tianchuangya/SmartDesktopCube-IoT/README.md

# SmartDesktopCube-IoT
SmartDesktopCube-IoT基于 ESP32 的多功能智能桌面魔方 IoT 项目
