tianchuangya/SmartDesktopCube-IoT/关于硬件.docx

BH1750：SDA=2，SCL=1 ,

ENS160 + AHT21：SDA 6 SCL 5

TFT ILI9341：led 3.3v sck 13 sdi 12 dc 14 reset 4 cs 16 T_CLK 17 T_DIN 18 T_DO 20 T-IQR 21 T_CS 47

LD2410C：tx 15 rx 7

LD2410C：16mm * 22mm

多路dc电源模块：pcb板59.5mm*26.5mm，dc接口5.5*2.1mm

ENS160 + AHT21：19.6mm*24.3mm（手工测量）

BH1750：32.6mm*15.1mm
