tianchuangya/SmartDesktopCube-IoT/具体功能实现.docx

实现：

ESP32 + DHT11 温湿度采集

OLED 显示（温度、湿度、时间、WiFi 状态）

WS2812 灯光（3 种效果：常亮、呼吸、报警）

WiFi 上传数据到本地服务器

网页端：登录 + 设备在线状态 + 实时数据 + 历史曲线

远程控制灯光（网页点一下 → 灯亮）

阈值报警（温度过高 → 灯变红）

硬件端

1. 搭建 ESP32 开发环境
2. 驱动 0.96 寸 OLED 屏幕，显示温湿度、WiFi 状态、网络时间
3. 驱动 DHT11 采集温湿度数据
4. 驱动 WS2812 灯光，实现常亮、红色报警两种状态
5. 连接 WiFi，定时通过 HTTP 上传温湿度数据到服务器
6. 接收服务器指令，执行开灯、关灯、报警灯光效果

网页 / 服务器端

1. 搭建本地 Flask 服务器
2. 实现用户注册、登录功能（可略）
3. 提供接口接收 ESP32 上传的温湿度数据，存入 SQLite
4. 开发登录后可见的网页仪表盘，显示当前温湿度、设备在线状态、历史折线图
5. 开发网页控制按钮：开灯、关灯、触发报警
6. 开发接口下发控制指令给 ESP32
7. 记录并展示设备上下线日志
