tianchuangya/SmartDesktopCube-IoT/数据集字段说明(1).md

# 数据集字段说明

## 变量说明

| 字段名 | 说明 | 单位 |
|---|---|---|
| TypPS | 平均粒径 | μm |
| oxygen | 氧气浓度 | 体积百分比（%） |
| pm10 | 直径 ≤ 10 μm 的颗粒物（PM10）浓度 | μg/m³ |
| cnt0_5 | 直径 > 0.5 μm 的颗粒物计数 | 个 |
| co | 一氧化碳（CO）浓度 | ppm |
| temperature | 温度 | °C |
| performance | 计算得出的性能指标 | — |
| co2 | 二氧化碳（CO₂）浓度 | ppm |
| measuretime | 上一次完整测量周期所用的时间 | 毫秒（ms） |
| so2 | 二氧化硫（SO₂）浓度 | μg/m³ |
| no2 | 二氧化氮（NO₂）浓度 | μg/m³ |
| cnt5 | 直径 > 5 μm 的颗粒物计数 | 个 |
| timestamp | 测量对应的时间戳 | Unix Epoch 时间（毫秒） |
| pm1 | 直径 ≤ 1.0 μm 的颗粒物（PM1）浓度 | μg/m³ |
| cnt1 | 直径 > 1 μm 的颗粒物计数 | 个 |
| dewpt | 露点温度 | °C |
| tvoc | 总挥发性有机化合物（TVOC）浓度 | ppb |
| pressure | 大气压 | hPa |
| cnt10 | 直径 > 10 μm 的颗粒物计数 | 个 |
| dCO2dt | CO₂ 浓度变化率 | ppm/s |
| sound_max | 最大噪音水平 | dB(A) |
| health | 计算得出的健康指标。正常评估范围为 0~1000，燃气报警为 -200，火灾报警为 -800 | — |
| temperature_o2 | 温度（氧气传感器） | °C |
| cnt2_5 | 直径 > 2.5 μm 的颗粒物计数 | 个 |
| o3 | 臭氧（O₃）浓度 | μg/m³ |
| humidity | 相对湿度 | % |
| dHdt | 绝对湿度变化率 | g/m³/s |
| humidity_abs | 绝对湿度 | g/m³ |
| sound | 噪音水平 | dB(A) |
| pm2_5 | 直径 ≤ 2.5 μm 的颗粒物（PM2.5）浓度 | μg/m³ |
| cnt0_3 | 直径 > 0.3 μm 的颗粒物计数 | 个 |

## 数据异常记录

| 日期 | 异常说明 |
|---|---|
| 2023 年 7 月 9 日 | 由于空气湿度骤增，导致细颗粒物测量值出现误差 |
| 2023 年 4 月 17 日 | 实验室停电，可能由短路引发 |
| 2023 年 5 月 21 日 | Herzogenrath 发生大火（距测量地点约 9~10 公里） |
