tianchuangya/SmartDesktopCube-IoT/作品提交/文档要求.md

 文档撰写要求

1）设计作品名称应与作品创意表上的作品名称一致，作品名称不超过20（含）字。

2）摘要为中文摘要，不超过1000字。

3）正文主要包含以下部分，依次为：1.设计需求分析，2.特色与创新，3.功能设计，4.系统实现，5.其他内容，6.参考文献。每部分的内容要求见括号中说明。

4）正文采用三级编目，章、节、小节。格式参照本模板。

5）所有文字均需自己撰写，引用参考文献仅可引用文中的观点或结论，不能引用文字。所有引用请标明出处，并在参考文献中说明，严禁抄袭。

- 设计文档容量限制在30MB

- 设计文档后缀名， .doc, .docx，不支持.pdf格式
