tianchuangya/SmartDesktopCube-IoT/Smart Desktop Cube IoT/答辩/答辩流程设计_v1.md

# 智能桌面魔方 — 答辩流程设计（第一版）

> 赛事：2026全国大学生物联网设计竞赛 · 华东赛区决赛
> 赛道：乐鑫科技命题赛道
> 预设答辩时长：8分钟陈述 + 3~5分钟评委提问（以赛区通知为准）
> 团队：3人（主讲1人 + 补充1人 + 演示协助1人）

---

## 总体节奏

| 段落 | 内容 | 时长 | 核心目标 |
|---|---|---|---|
| 一 | 市场痛点 + 产品定位 | 1分30秒 | 让评委3秒记住"我们是什么" |
| 二 | 系统架构 | 1分30秒 | 展示技术完整度 |
| 三 | 核心功能演示 | 2分钟 | 眼见为实，视频/实物 |
| 四 | AI决策（端+云） | 1分30秒 | 回应赛事AI主题要求 |
| 五 | 工程深度 + 创新点 | 1分钟 | 拉开与"拼凑型"队伍的差距 |
| 六 | 未来规划 + 收尾 | 30秒 | 商用想象空间，干净收束 |

---

## 一、市场痛点 + 产品定位（1分30秒）

### 讲述脚本

> "在开始之前，我想先请大家看几张截图。"
>
> 【翻到PPT第2页：电商平台截图拼贴】
>
> "这是我在京东、淘宝、拼多多搜索'桌面智能终端'的结果。排名前十的产品，功能高度雷同——显示时间、测个温湿度、最多再加个PM2.5数字。它们本质上是一个**带屏幕的测量仪**，不是终端。测量完了，然后呢？没有然后。"
>
> 【翻到PPT第3页：对比表格】
>
> "我们也看了乐鑫官方的参考方案，偏向办公辅助和生活提醒。但真正做'环境感知→智能决策→主动推送'这条链路的桌面产品，在消费市场上几乎是空白。"
>
> 【翻到PPT第4页：产品定位一句话】
>
> "这就是我们做智能桌面魔方的出发点：**不做第N个温湿度计，做桌面上第一个会思考、会决策、会主动找你的环境终端。**"

### PPT内容

**第1页（封面）**
- 项目名称：智能桌面魔方 — 基于ESP32-S3的环境决策终端
- 团队名 / 学校 / 赛道
- 小眠角色形象（右下角，建立视觉记忆）

**第2页（市场截图拼贴）**
- 【图片位】京东搜索"桌面智能终端"前5个商品截图（带价格）
- 【图片位】淘宝搜索"桌面温湿度计"前5个商品截图
- 【图片位】拼多多同类商品截图
- 标注：用红色圈出它们共同的功能点（时钟、温度、湿度），旁边大字写"然后呢？"
- 底部小字：截图日期 2026年X月

**第3页（竞品对比表）**

| 维度 | 市面桌面终端 | 乐鑫参考方案 | 智能桌面魔方 |
|---|---|---|---|
| 环境感知 | 温湿度（1~2项） | 温湿度+光照 | 六参数+雷达存在 |
| 智能决策 | 无 | 简单阈值提醒 | 边缘AI+云端LLM |
| 主动推送 | 无 | 无 | 微信/网页实时推送 |
| 用户交互 | 无/按键 | 屏幕显示 | TFT触摸+网页+OTA |
| 角色IP | 无 | 无 | 小眠（5种情绪状态） |

**第4页（定位一句话）**
- 大字居中：**"不做第N个温湿度计，做桌面上第一个会思考的环境终端。"**
- 下方三个关键词图标：感知 → 决策 → 行动
- 小眠角色从"睡觉"到"醒来"的小动画暗示（静态图即可）

### 演讲要点
- 语速稍慢，让评委消化截图信息
- "然后呢？"这个反问要停顿一拍，制造记忆点
- 不要贬低竞品，用"它们解决了测量问题，但决策是空白"这种中性表述

---

## 二、系统架构（1分30秒）

### 讲述脚本

> "接下来看系统怎么实现。"
>
> 【翻到PPT第5页：硬件架构图】
>
> "主控是ESP32-S3，双核240MHz，16MB Flash加8MB PSRAM。我们利用双核做了物理隔离——Core 0跑网络和通信，Core 1跑UI和传感器，两核之间通过共享数据池通信，互不阻塞。"
>
> "传感器方面，六种环境参数全覆盖：ENS160出CO2、TVOC、AQI、eCO2四项空气质量指标，AHT20出温湿度，BH1750出光照，LD2410B毫米波雷达做人体存在检测——这个是后面专注模式的核心。"
>
> 【翻到PPT第6页：软件分层图】
>
> "软件分三层：底层是FreeRTOS任务调度，中间是数据池加协议栈，上层是LVGL界面和Web服务。所有LVGL渲染严格限制在单一线程内，其他任务只写共享字段——这是我们踩了线程安全的坑之后确立的核心原则。"
>
> 【翻到PPT第7页：云端架构图】
>
> "云端走MQTT协议，自研握手鉴权——设备上报DID，后端下发Token，后续所有消息带Token校验。后端用FastAPI，接了大模型API做环境报告的智能生成。"

### PPT内容

**第5页（硬件架构图）**
- 【图片位】系统硬件连接图（ESP32-S3居中，各传感器用线连接，标注接口I2C/UART/SPI）
- 双核分工用两种颜色区分：Core 0（蓝色）= WiFi/MQTT/Web，Core 1（绿色）= LVGL/传感器/OTA
- 右下角小图：实物照片（外壳装好后的正面照）

**第6页（软件分层图）**
- 三层架构图：
  - 底层：FreeRTOS（Task_LVGL / Task_Network / Task_DataRead / Task_Control / OTA）
  - 中间层：DataPool共享数据池 + MQTT协议栈 + WebServer RESTful API
  - 上层：LVGL UI（bootScreen/mainScreen/fouseScreen/settingsScreen）+ Web控制页
- 用红色虚线框标注"LVGL线程安全边界"

**第7页（云端架构图）**
- 数据流图：ESP32 → MQTT Broker → FastAPI后端 → LLM API → 报告生成 → 网页展示
- 旁边标注：握手鉴权流程（DID→Token→带Token通信）
- 小图标：微信推送、网页数字孪生

### 演讲要点
- 这页信息密度高，不要逐字念，抓重点讲
- "双核物理隔离"和"LVGL线程安全"是两个技术亮点，稍微展开一句
- 如果评委是技术背景，这里会留下"这队有工程深度"的印象

---

## 三、核心功能演示（2分钟）

### 讲述脚本

> "说了这么多，直接看东西。"
>
> 【播放演示视频 / 或现场操作实物】
>
> "这是开机——黑色启动画面，小眠在睡觉，下方实时显示模块加载进度：光照传感器、温湿度、空气质量、雷达，每个模块有五次重试机会，全部加载完才进入主界面。"
>
> 【视频切到主界面】
>
> "主界面：左侧是六项环境数据实时刷新，右上角小眠的表情会随空气质量变化——空气好她开心，空气差她报警。底部是WiFi和MQTT连接状态。"
>
> 【视频切到专注模式】
>
> "专注模式是雷达驱动的。我坐到桌前，雷达检测到人体存在，五秒后自动进入专注界面，计时开始，灯光切暖光。我站起来离开，五秒后自动退出。全程不需要碰任何按钮。"
>
> 【视频切到网页控制】
>
> "手机打开cube.local，这是设备的Web控制页：实时数据、专注模式开关、亮度调节、OTA固件更新——全部远程可控。"
>
> 【视频切到AI报告】
>
> "最后看云端AI。后端每天聚合环境数据和专注记录，大模型生成日报：今天下午CO2超标时你的专注时长缩短了40%，建议午后先通风。这不是简单的数据展示，是跨数据源的因果洞察。"

### PPT内容

**第8页（演示视频/实物）**
- 如果播放视频：全屏播放，PPT只显示一个标题"实机演示"
- 如果现场操作：PPT显示功能清单checklist，每演示完一项打勾
- 视频建议分段剪辑，每段之间用黑屏+白字标题过渡

**视频分段建议（总长控制在2分钟内）：**

| 段落 | 内容 | 时长 | 拍摄要点 |
|---|---|---|---|
| 1 | 开机动画 | 10秒 | 特写TFT屏幕，黑色背景+加载文字清晰可见 |
| 2 | 主界面数据刷新 | 15秒 | 手指触摸滑动，数据实时跳动，小眠表情变化 |
| 3 | 专注模式自动进入/退出 | 20秒 | 人坐下→自动进入→计时→人离开→自动退出，一镜到底 |
| 4 | 网页控制 | 20秒 | 手机屏幕录制：打开cube.local→操作→设备响应 |
| 5 | OTA升级 | 15秒 | 网页点检测更新→确认→进度条→完成 |
| 6 | AI日报/周报 | 20秒 | 网页端展示报告内容，重点拍"洞察"文字 |
| 7 | 微信推送（如有） | 10秒 | 手机收到推送通知的画面 |

### 演讲要点
- 演示是全场最重要的环节，视频必须提前录好备份
- 如果是现场操作，安排一个人专门操作设备，主讲人继续讲
- 专注模式的"无感"是最大卖点——强调"全程不需要碰任何按钮"
- 如果现场演示翻车，立刻切到备份视频，不要慌

---

## 四、AI决策：端侧 + 云端（1分30秒）

### 讲述脚本

> "赛事主题要求AI，我们的AI不是贴上去的标签，是系统架构的有机组成，分两端。"
>
> 【翻到PPT第9页：端侧AI】
>
> "端侧：ESP32-S3上跑了一个轻量PM2.5预测模型，基于温湿度、光照、CO2等特征做实时推理，不依赖网络，毫秒级响应。另外专注模式的状态机本身就是一个决策系统——雷达输入→存在判断→延迟确认→状态切换→灯光联动，这是完整的感知-决策-执行闭环。"
>
> 【翻到PPT第10页：云端AI】
>
> "云端：后端每天聚合所有传感器数据和专注记录，调用大模型API生成环境日报和周报。关键不是'生成了报告'，而是报告里有什么——"
>
> 【翻到PPT第11页：报告示例】
>
> "比如这条：'本周你下午的专注效率是上午的2.1倍，且CO2超过1000ppm时专注时长平均缩短40%。建议：午后先开窗通风15分钟再进入专注。'这是跨数据源的相关性分析，是只有我们这套硬件组合——雷达+环境传感器+专注计时——才能算出来的洞察。"
>
> "端侧管实时，云端管长时。实时决策不需要网络，长时洞察需要推理能力。这是我们的AI分工。"

### PPT内容

**第9页（端侧AI）**
- 左侧：PM2.5预测模型流程图（输入特征→模型→输出）
- 右侧：专注状态机图（雷达检测→存在确认→延迟→进入专注→离开→退出）
- 标注：TinyML / 边缘推理 / 零网络依赖

**第10页（云端AI）**
- 数据流：传感器数据 → 后端聚合 → 结构化Prompt → LLM → 报告
- 强调：不是"接了个API"，是"只有这套数据组合才能产生的洞察"

**第11页（AI报告示例截图）**
- 【图片位】实际生成的日报/周报截图（从后端网页截取）
- 用高亮框标出"洞察"句子（如上面的CO2与专注时长相关性）
- 底部对比：左边"普通数据展示：平均CO2 800ppm" vs 右边"AI洞察：CO2>1000时专注缩短40%"

### 演讲要点
- 这页直接回应赛事AI主题要求，必须讲清楚
- "不是贴标签，是有机组成"这句话要说出来
- 报告示例用真实数据（提前跑几天积累），不要用假数据
- 如果评委问"大模型用的什么"，诚实回答（Qwen/DeepSeek API），重点是prompt设计和数据聚合逻辑

---

## 五、工程深度 + 创新点总结（1分钟）

### 讲述脚本

> "最后快速说几个工程细节，然后总结创新点。"
>
> 【翻到PPT第12页：工程细节】
>
> "第一，OTA固件升级是用户确认制的——设备永不自动更新，后端推送新版本通知，用户在网页上确认后才开始下载，下载期间自动暂停所有非关键任务，MD5校验通过才写入。"
>
> "第二，启动流程做了I2C总线恢复和每模块五次重试——烧录后传感器可能卡死，我们发9个SCL脉冲释放总线，这在消费级产品里是标配，在学生项目里很少见。"
>
> "第三，所有LVGL渲染严格单线程，跨核通信只走共享字段，杜绝了线程安全问题。"
>
> 【翻到PPT第13页：创新点】
>
> "总结三个创新点：
> 一，市场定位创新——从测量仪到决策终端，填补桌面环境智能决策的空白；
> 二，交互创新——毫米波雷达驱动的无感专注闭环，加上角色IP的情感化交互；
> 三，架构创新——端侧实时AI加云端长时洞察的双层智能分工。"

### PPT内容

**第12页（工程深度）**
- 三个要点，每个配一个小示意图：
  - OTA流程图（推送→确认→暂停任务→下载→校验→写入）
  - I2C恢复波形示意（9个SCL脉冲）
  - 线程安全模型（LVGL线程 vs 其他任务，共享字段箭头）
- 这页不需要讲太细，快速过，但让评委看到"这队有工程素养"

**第13页（创新点总结）**
- 三个创新点，每个一句话 + 一个图标
- 大字、留白、不要堆文字
- 这是评委打分时最后记住的一页

### 演讲要点
- 工程细节快速过，不要陷入技术讲解（留给Q&A）
- 创新点总结要慢、要清晰、要有停顿
- "填补空白"这个词可以用，但不要过度吹嘘

---

## 六、未来规划 + 收尾（30秒）

### 讲述脚本

> "未来规划：短期内，灯光控制和空调联动已经在协议层预留了接口，赛后即可扩展。中期，我们会把环境决策模型开放API，对接智能家居生态。长期，这个方向——桌面环境智能决策——在消费市场是空白，我们相信它值得被做成一个真正的产品。"
>
> "以上就是智能桌面魔方，谢谢大家。"

### PPT内容

**第14页（未来规划）**
- 时间轴：短期（灯光/空调联动）→ 中期（开放API/生态对接）→ 长期（产品化）
- 简洁，不要画太大的饼

**第15页（结束页）**
- 项目名称 + 团队 + 感谢
- 小眠角色"点赞"表情
- 二维码（可选：链接到演示视频/GitHub仓库）

---

## 评委提问预判 + 应答准备

### 高概率问题

**Q1: "你们和市面上的桌面温湿度计有什么本质区别？"**
> 答：它们是测量工具，显示数字就结束了。我们是决策终端——测量之后有判断、有行动、有推送。比如CO2超标，温湿度计只会显示一个数字，我们会判断"空气质量差"，推送微信通知，小眠表情变成告警状态，周报里会告诉你"这周有三天CO2超标，建议改善通风"。从测量到决策到行动，这是本质区别。

**Q2: "AI具体用了什么？是调API还是有自己的模型？"**
> 答：两端都有。端侧是TinyML的轻量PM2.5预测模型，跑在ESP32-S3上，不依赖网络。云端是大模型API做环境报告生成，但核心价值不在API本身，在于我们的数据聚合和prompt设计——我们把雷达存在数据、环境六参数、专注时长做跨源关联，这是通用大模型做不到的，因为它没有这些数据。

**Q3: "代码是自己写的还是AI生成的？"**
> 答：架构设计是我们自己做的——双核怎么分、协议怎么走、状态机怎么转、线程安全怎么保证，这些设计决策是人做的。实现层面我们大量使用了AI辅助编码，这在2026年是正常的工程实践。关键是每一个设计决策我都能解释为什么这么做——比如为什么LVGL必须单线程、为什么OTA要暂停其他任务、为什么I2C要做总线恢复。工具是AI的，脑子是我们的。

**Q4: "毫米波雷达和摄像头方案比有什么优势？"**
> 答：三个优势。第一，隐私——雷达不采集图像，放在卧室、宿舍没有隐私顾虑，摄像头不行。第二，穿透性——雷达可以穿透塑料外壳，不需要开孔，摄像头必须露出来。第三，功耗和成本——LD2410B几块钱，摄像头加AI推理芯片贵得多。对于"有没有人"这个判断，雷达是更优解。

**Q5: "这个产品能商用吗？壁垒在哪？"**
> 答：硬件本身没有壁垒，谁都能抄。壁垒在数据——跑三个月、半年之后，我们的决策模型比任何新入场的团队都准，因为我们有真实的环境-行为关联数据。另外用户习惯和角色IP的情感连接也是软壁垒。商用路径上，短期内可以走众筹/小批量，中期对接智能家居生态。

**Q6: "为什么选ESP32-S3而不是其他方案？"**
> 答：三个原因。第一，双核240MHz性能够跑LVGL加传感器加网络，不需要额外的应用处理器。第二，8MB PSRAM让LVGL的帧缓冲可以放PSRAM，内部RAM留给任务栈。第三，乐鑫生态成熟，WiFi/BLE/OTA都是现成的，开发效率高。这个赛道本身就是乐鑫命题，用ESP32-S3是最自然的选择。

**Q7: "专注模式的误触发怎么处理？比如只是路过桌子？"**
> 答：我们做了延迟确认机制——雷达检测到人体存在后，不是立刻进入专注，而是等待5秒持续存在才确认进入。同样，离开后也是5秒无人才退出。另外有30秒冷却期——手动退出后30秒内不会自动重新进入，防止"我只是站起来拿个东西"的误触。

### 中概率问题

**Q8: "MQTT为什么不用TLS？"**
> 答：当前是局域网场景，设备和后端在同一WiFi下，风险可控。协议层已经预留了Token鉴权，后续上公网时可以加TLS。这是一个工程权衡——局域网内TLS的握手开销对ESP32来说不小，在演示场景下我们优先保证通信稳定性。

**Q9: "传感器数据准不准？有没有校准？"**
> 答：ENS160有72小时预热期，我们上电后持续运行让传感器稳定。AHT20出厂已校准。BH1750是数字输出，精度高。实际使用中我们更关注趋势和相对变化（比如"CO2从600升到1200"），而不是绝对精度。周报里的洞察也是基于趋势分析。

**Q10: "团队怎么分工的？"**
> 答：我负责硬件和固件——系统架构、双核任务设计、传感器驱动、LVGL界面、OTA。成员2负责后端——FastAPI服务、MQTT通信、AI报告生成、数字孪生网页。成员3负责测试、文档、PPT和演示视频。三个人从四月开始，每周至少碰一次进度。

---

## 演示视频拍摄清单（提前准备）

- [ ] 设备充满电 / 准备稳定USB供电
- [ ] 外壳装配完成，外观整洁
- [ ] 拍摄环境：干净桌面，背景简洁，光线充足
- [ ] 手机屏幕录制（网页控制 + 微信推送）
- [ ] AI报告提前生成好（用真实数据跑几天）
- [ ] 每段拍两遍，选最好的
- [ ] 剪辑总长控制在2分钟以内
- [ ] 导出1080p，备份U盘+云端各一份

---

## 答辩当天检查清单

- [ ] 实物设备 + 备用USB线 + 充电宝
- [ ] 演示视频U盘备份（防止现场网络问题）
- [ ] PPT备份（U盘 + 云端 + 邮箱发自己一份）
- [ ] 手机热点（防止现场WiFi不可用）
- [ ] 后端服务确认在线（成员2负责）
- [ ] 提前30分钟到场测试投屏/翻页笔
- [ ] 主讲人计时排练至少3遍（控制在7分30秒，留30秒余量）

---

## 待确认事项

- [ ] 华东赛区决赛形式：现场答辩 or 线上？（查赛区通知）
- [ ] 答辩时长：几分钟陈述 + 几分钟提问？
- [ ] 是否允许实物演示？还是只能放视频？
- [ ] PPT比例：16:9 还是 4:3？
- [ ] 是否需要提交PPT文件？格式要求？

---

*文档版本：v1.0 | 创建日期：2026-07-21 | 状态：初稿待排练后迭代*
