tianchuangya/SmartDesktopCube-IoT/智能桌面魔方——功能规格说明书.docx

智能桌面魔方

Smart Desktop Cube IoT

功能规格说明书

Technical Specification Document

2026年7月 | v1.0

一、产品概述

1.1 产品定义

智能桌面魔方（Smart Desktop Cube IoT）是一款面向桌面场景的物联网智能终端设备。产品以 ESP32-S3 为主控核心，集成多维度环境传感器、毫米波雷达、触控显示屏、智能灯光控制等模块，通过边缘AI推理、WiFi联网、MQTT通信，实现环境感知、智能决策、场景联动、远程管控的一体化解决方案。

1.2 产品定位

• 目标用户：学生、办公人群、桌面工作者

• 使用场景：个人桌面、书房、宿舍、小型办公室

• 核心价值：自动感知用户状态，智能调节桌面环境，提升专注效率与舒适度

• 产品形态：桌面立方体终端 + Web管理后台 + 智能灯带

1.3 技术栈

• 硬件平台：ESP32-S3（双核240MHz，8MB Flash，8MB PSRAM）

• 开发框架：Arduino IDE + PlatformIO + FreeRTOS

• UI框架：LVGL 8.x（轻量级嵌入式图形库）

• 通信协议：WiFi 802.11b/g/n + MQTT 3.1.1 + HTTP/HTTPS

• 后端：FastAPI + async/await + SQLite (aiosqlite)

• 前端：纯HTML5/CSS3/JavaScript（Canvas粒子引擎）

二、硬件规格

2.1 主控模块

• 芯片：ESP32-S3

- 双核Xtensa LX7 @ 240MHz

- 8MB Flash（固件 + SPIFFS + OTA分区）

- 8MB PSRAM（ Octal SPI）

- 内置WiFi 4 + BLE 5.0

双核分工：Core 1 负责显示渲染（LVGL）、传感器采集、雷达检测、专注模式决策、OTA 升级、本地智能决策；Core 0 负责 WiFi 连接管理、MQTT 通信（握手/心跳/数据上报）、Web 服务器（REST API + mDNS）。两核通过 DataPool 共享数据与 dataMutex 互斥锁实现线程安全通信。

2.2 显示模块

• 屏幕：2.4寸 TFT LCD

- 驱动芯片：ILI9341

- 分辨率：320×240像素

- 接口：SPI（MOSI 12, SCLK 13, CS 16, DC 14, RST 4, BL 42）

- 背光：PWM可调亮度（GPIO 42）

• 触摸：XPT2046 电阻式触摸控制器

- 接口：SPI（SCLK 18, MISO 20, MOSI 17, CS 47, IRQ 21）

- 采样方式：压力值判断（z1 < 20 或 > 4000 视为无效）

- 坐标映射：raw(150-2000) → screen(0-320/0-240)

2.3 传感器模块

2.3.1 ENS160 空气质量传感器

• 测量指标：eCO₂（等效二氧化碳）、TVOC（总挥发性有机物）、AQI（空气质量指数）

• 通信接口：I²C（地址 0x53）

• 预热时间：上电后2-3分钟自动预热

• 温度补偿：每60秒从AHT21读取温湿度进行一次补偿校准

• 异常恢复：连续读数异常时自动执行 IDLE→STANDARD 复位流程

• 输出范围：eCO₂ 400-65000ppm, TVOC 0-65000ppb, AQI 1-5级

2.3.2 AHT21 温湿度传感器

• 测量指标：温度（-40~85°C）、相对湿度（0~100%RH）

• 通信接口：I²C（地址 0x38）

• 精度：温度 ±0.3°C, 湿度 ±2%RH

• 采样周期：500ms（Task_DataRead 任务周期）

2.3.3 BH1750 光照传感器

• 测量指标：环境光照度（1-65535 lux）

• 通信接口：I²C（地址 0x23）

• 应用：屏幕亮度自适应调节

2.3.4 LD2410B 毫米波雷达

• 功能：人体存在检测（静止/运动目标检测）

• 检测范围：0.75-6米

• 通信接口：UART（RX 7, TX 15, 波特率 256000bps）

• 输出：静止目标距离、运动目标距离、存在状态

• 应用：专注模式自动触发、无人自动退出、屏幕智能唤醒/休眠

2.4 执行模块

2.4.1 Yeelight 智能灯带 1S

• 光源：双色温LED（暖白2700K + 冷白6500K）

• 亮度范围：1%-100%

• 通信方式：WiFi 2.4GHz + LAN Control Protocol（HTTP API）

• 控制接口：HTTP GET /set?power=on&bright=80&ct=4000

• 供电：USB / DC 5V，即插即用，零接线

• 联动场景：专注模式自动切换3000K暖光，退出恢复先前灯光

2.5 存储模块

• 固件存储：8MB Flash（Bootloader + 分区表 + factory + ota_0 + SPIFFS）

• SPIFFS 分区：预留用于配置文件与运行时数据存储；当前图片资源以 C 数组形式编译进固件 Flash

• PSRAM：8MB，用于LVGL显示缓冲区（LV_MEM_CUSTOM=1）

三、软件功能详述

3.1 环境数据采集

3.1.1 数据采集流程

系统以500ms 为周期轮询所有传感器，采集以下数据：

• 温度（°C）和湿度（%RH）—— AHT21

• eCO₂（ppm）、TVOC（ppb）、AQI（1-5级）—— ENS160

• 光照强度（lux）—— BH1750

• 人体存在状态（有/无）—— LD2410B

3.1.2 数据滤波算法

• 数据平滑：传感器驱动库内置滤波处理，ENS160 自带多周期平均

• 限幅滤波：两次采样差值超过阈值时丢弃，防止跳变

• ENS160预热管理：上电后2-3分钟自动预热，期间标记数据为"预热中"

3.1.3 AQI计算

• 采用标准0-500线性插值算法

• 输入eCO₂和TVOC，取两者中更差等级

• 等级映射：优(0-50) / 良(51-100) / 轻度(101-150) / 中度(151-200) / 重度(201-300) / 严重(>300)

3.2 边缘AI：PM2.5浓度预测

3.2.1 功能概述

利用设备已有的温湿度、CO₂、TVOC四维传感器数据，通过部署在ESP32本地的LightGBM机器学习模型，实时预测PM2.5浓度（μg/m³），无需额外硬件。

3.2.2 模型规格

• 模型类型：LightGBM 回归树

• 决策树数量：1000棵

• 每树内部节点：30个

• 每树叶节点：31个

• 输入特征：温度、CO₂、TVOC、湿度（4维）

• 输出：PM2.5浓度（μg/m³）

3.2.3 推理流程

ESP32读取4路传感器数据 → 构建特征向量 → 遍历1000棵决策树 → 每棵树叶节点值累加 → 输出PM2.5预测值。推理全程在本地Flash（PROGMEM）中完成，无需网络请求。

3.2.4 部署工具

• convert_model_to_c.py：自研Python脚本，将LightGBM模型文件转换为C语言数组

• 输出文件：pm25_model_data.h（包含阈值、特征索引、左子树、右子树、叶子值五个数组）

• 存储位置：ESP32 Flash（PROGMEM），不占用RAM

3.2.5 性能指标

• 单次推理耗时：< 10ms

• 模型占用Flash：约500KB

• RAM占用：约4KB（仅存储中间变量）

• 网络依赖：无（完全离线推理）

3.3 本地UI交互

3.3.1 显示框架

• 图形库：LVGL 8.x

• 显示驱动：Adafruit_ILI9341 + TFT_eSPI

• 触摸驱动：XPT2046（SPI通信，压力值判断）

• 显示缓冲区：PSRAM分配（LV_MEM_CUSTOM=1），约 30KB 双缓冲（320×48 像素 × 2 × RGB565）

3.3.2 页面结构

• 主屏幕（mainScreen）：AQI数值+颜色圈圈（绿→红渐变）、温湿度/光照/CO₂/TVOC/PM2.5数据、虚拟IP角色+心情标签、WiFi/MQTT/专注状态指示灯、固件版本号

• 环境屏幕（envScreen）：温湿度、CO₂、TVOC、AQI、光照详细数据

• 空气质量屏幕（airScreen）：CO₂/TVOC/AQI分级展示

• 专注屏幕（fouseScreen）：专注计时器（HH:MM:SS）、环境建议（温度过高建议开空调、CO₂偏高建议通风等）

• 设置屏幕（settingsScreen）：灯光、专注参数、OTA更新

3.3.3 交互特性

• 时间显示：通过NTP对时，每200ms刷新一次

• 环境数据：传感器 500ms 采样一次，UI 每 200ms 刷新显示（LVGL 定时器）

• 页面切换：触控滑动或点击导航图标切换

• 离线模式：断网时所有本地UI功能正常，仅网络相关数据标记为"--"

3.3.4 开机动画

设备上电后显示开机画面（bootScreen），展示"小眠"角色睡眠静态图与模块加载进度文字。Phase 1 即时渲染 UI 框架（约 1 秒），Phase 2 后台依次初始化各传感器模块（BH1750→AHT21→ENS160→LD2410B，每个模块 5 次重试 + I2C 总线恢复），每步更新进度文字。全部就绪后以 500ms 淡入动画过渡到主界面。

- sleep：角色睡眠静态图

- wake_1 -> wake_2：角色眼睛缓缓睁开，完成苏醒动效

- welcome：显示欢迎语

- logo：项目Logo展示

过渡到主界面。开机画面使用角色睡眠静态图（C 数组编译），后续可扩展苏醒序列帧。

3.3.5 锁屏界面

设备远程锁定后，独立显示lockScreen：

- 屏幕显示锁定状态，虚拟IP角色抱胸严肃、带锁图标

- 触控完全失效，禁止任何本地操作

- 解锁后自动恢复主界面

3.4 虚拟IP角色交互

3.4.1 功能概述

采用专属二次元虚拟IP角色作为设备的情感化交互核心，通过角色表情和动作替代传统灯光告警，实现环境状态、设备模式、安全事件的拟人化表达。

3.4.2 角色状态机

• 微笑放松：AQI=1（优良），所有指标正常

• 轻微担忧：AQI=2（良），单项指标轻微异常

• 紧张警示：AQI≥3（轻度污染及以上），CO₂/TVOC超标

• 安静陪伴：专注模式激活，低动效，不打扰

• 抱胸严肃：设备锁定，显示锁态图标

• 点赞鼓励：环境恢复正常，任务完成

• 开机显示角色睡眠静态图 + 模块加载进度文字

• 传感器就绪后以 500ms 淡入动画过渡到主界面

• 主界面各组件依次浮现（15 个控件，70ms 步长，300ms 动效），全程 1-2 秒

• 显示欢迎语："嗨，今天想专注点什么？"

• 平滑过渡到主界面，全程1-2秒

3.4.4 资源管理

• 存储位置：以 C 数组形式编译进固件 Flash（PROGMEM）

• 图片分类：角色表情、AQI背景、专注界面、开机动画

• 渲染方式：低帧率、低占用，适配ESP32性能

图片资源池（ImagePool_t）六类资源：

- 角色表情（RoleImg_t, 60x60）：normal微笑 / remind提醒 / alert告警 / focus专注 / celebrate点赞 / guide向导

- AQI背景（AqiBgImg_t, 60x60）：5级（优/良/中/差/劣）

- 开机动画（BootImg_t, 320x240）：5帧序列（sleep -> wake_1 -> wake_2 -> welcome -> logo）

- 界面背景（BgImg_t, 320x240）：main / focus / menu / report / setting

- UI控件（UIControlImg_t）：tab_air / tab_env / tab_time / tab_set / btn_back / btn_ok

- 专注相关（FocusImg_t）：focus_start / focus_running / focus_end

所有图片以 C 数组形式存储于固件 Flash 中（PROGMEM），编译时嵌入，不依赖 SPIFFS 分区。

3.4.5 温度驱动角色换装（规划功能）

规划为虚拟IP角色"小眠"添加根据 AHT21 传感器实时温度自动切换服饰的功能，将环境温度从抽象数字转化为直觉感知的角色穿着变化。当前版本角色表情仅基于空气质量（AQI/eCO₂/TVOC）驱动，温度换装功能预留了图片资源接口，将在后续版本中实现。

（规划中）• 寒冷（<15°C）：角色穿着厚棉服、围巾，呈现“冷”的视觉信号

（规划中）• 凉爽（15-22°C）：角色穿着薄外套，呈现“偏凉”的视觉信号

（规划中）• 舒适（22-28°C）：角色穿着短袖T恤，呈现“舒适”的视觉信号

（规划中）• 炎热（>28°C）：角色穿着无袖背心，呈现“热”的视觉信号

（规划中）换装机制与角色状态机独立运行，温度换装优先级低于AQI状态切换但高于专注模式动效。每个温度区间预绘制多张不同服饰的角色图片，存储于SPIFFS分区，温度跨越阈值...

3.5 专注模式

3.5.1 触发机制

• 自动触发：LD2410B雷达检测到人体存在，持续超过设定阈值（默认5秒，可通过 FocusConfig_t 配置）

• 手动触发：触控屏幕专注模式按钮

• 远程触发：MQTT指令下发专注模式切换

3.5.2 模式行为

• 进入专注：虚拟IP角色切换安静陪伴状态 + Yeelight灯带切换3000K暖光 + 计时器开始计时

• 专注中：屏幕显示专注计时器（HH:MM:SS格式），角色保持安静状态

• 退出专注：雷达检测到离开超过阈值 + 自动退出 + 灯光恢复默认 + 展示专注时长

• 数据记录：专注时长（sensorData.focus_duration）由focus_mode.cpp全权管理，每秒自增

• 专注会话环境记录（FocusSession_t）：进入专注模式后，IntelligenceTask每5秒采样一次温度、湿度、CO₂数据并累积求和。退出专注时计算会话期间平均值，生成专注质量评分（0-100分），评分权重为CO₂浓度40%（>600ppm开始扣分）、温度35%（舒适区22-26°C）、湿度25%（舒适区40-60%）。评分结果以半透明面板形式展示在屏幕上（6秒自动消失），包含专注时长、环境均值和评分等级（Excellent≥90 / Good≥75 / Fair≥60 / Improve<60）。

• CO₂趋势预测（predictCO2Trend）：利用传感器历史环形缓冲区（SensorHistory，每5分钟记录一次，保留60个点=5小时）中最近6个点（30分钟数据），通过最小二乘法线性回归计算CO₂浓度变化斜率。当斜率>5ppm/5min且当前值<1000ppm时，预测达到通风阈值（1000ppm）的剩余时间，在专注界面显示'CO2 rising ~25min to ventilate'。每30秒更新一次预测结果。

• 专注期间智能休息建议（checkFocusBreak）：专注模式运行中，系统每5秒检测环境参数，当CO₂>1200ppm、温度>28°C或湿度>75%时，通过顶部半透明Toast弹窗（5秒显示时长）建议用户适当休息通风。同类建议设有3分钟冷却期（FOCUS_BREAK_COOLDOWN_MS=180000）避免频繁打扰。

3.5.3 联动逻辑

• 灯光联动：进入专注→暖光（3000K），退出专注→恢复先前灯光

• 角色联动：根据AQI/CO₂实时变化，角色在安静陪伴状态下仍可轻微表情变化

• CO₂提醒：专注中CO₂持续升高，角色轻微提醒用户开窗通风

专注模式可配置参数（FocusConfig_t）：

- radar_max_distance：雷达最大探测距离（默认60cm）

- radar_sensitivity：雷达灵敏度1-10（默认5）

- leave_timeout_ms：离开超时（默认5000ms），无人超时自动退出专注

- auto_enter_delay_ms：自动进入延时（默认5000ms），持续有人超时自动进入

- auto_enter_enabled / auto_exit_enabled：启用/禁用自动进出（默认：auto_enter=关闭，auto_exit=开启）

- focus_cooldown_ms：手动退出后冷却期（默认30000ms），禁止自动进入

3.6 远程设备锁定

3.6.1 锁定机制

• 锁定方式：通过 MQTT 控制指令或 Web 管理面板远程触发设备锁定，锁定状态由 status.device_lock 标志位管理

• 解锁方式：通过 MQTT 控制指令或 Web 管理面板远程解锁，解锁后自动恢复主界面与全部功能

• 离线保持：WiFi 断开后锁定状态依然保持（标志位存储于内存），防止物理绕过

3.6.2 锁定行为

• 屏幕：黑屏或显示锁定界面

• 触控：完全失效，禁止任何本地操作

• 传感器：停止数据采集和上报

• 灯光：全部禁用

• 网络：仅保留MQTT心跳，接收解锁指令

3.6.3 触发方式

• 远程锁定：Web后台一键锁定/解锁

• 指令鉴权：设备 Token 验证（MQTT 握手动态下发）

• 离线保持：WiFi断开后安全状态依然保持，防止物理破解

3.7 网络通信

3.7.1 WiFi连接

• 协议：802.11b/g/n, 2.4GHz

• 连接策略：异步连接 + 状态机管理（15秒超时重试）

• 断网处理：自动重连，不阻塞本地功能

• 离线模式：断网时本地所有功能正常，联网后自动恢复数据上报

3.7.2 MQTT通信

• 协议：MQTT 3.1.1（端口 1883，公共 EMQX Broker: broker.emqx.io）

• QoS：QoS 0（PubSubClient 默认，至多一次送达）

• 订阅Topic：

- status：设备状态上报

- data：传感器数据上报

- control：云端指令下发（灯光控制/安全锁/OTA/专注模式）

• 时序控制：subscribe()后等待SUBACK确认（delay 300ms），避免握手消息丢失

• 心跳保活：KeepAlive 15秒（PubSubClient 默认值）

• 缓冲区：setBufferSize(512)

MQTT消息类型与握手流程：

- handshake：设备上电后发送握手请求（含device_id, chip_model, version）

- handshake_ack：服务器返回握手响应（含token, 过期时间），token用于后续鉴权

- data_report：传感器数据周期性上报

- data_report_ack：服务器确认接收

- heartbeat：心跳包（每 30 秒发送一次）

- heartbeat_ack：心跳响应

- version_check：设备请求版本检查（含current_version字段）

- ota_update：服务器推送OTA更新响应（含code/url/version/md5字段）

- control：服务器下发控制指令（灯光/安全锁/专注模式）

- control_ack：设备控制指令执行回执

- ota_status：设备OTA状态上报

时序控制：subscribe()后等待SUBACK（delay 300ms），避免握手消息在订阅生效前到达。

3.7.3 NTP时间同步

• 服务器：ntp.aliyun.com, ntp1.aliyun.com, pool.ntp.org

• 时区：Asia/Shanghai（UTC+8）

• 同步策略：启动后每30秒重试一次，10秒超时等待

• 时间格式：通过localtime()转换为本地时间，每200ms刷新UI显示

3.7.4 非阻塞异步联网架构

系统采用FreeRTOS多任务 + 状态机 + 超时重试的非阻塞架构，确保联网过程不影响屏幕渲染、传感器采集和用户交互：

• WiFi连接：Task_Network 独立任务（Core 0, 优先级1），每500ms轮询WiFi状态。WiFi.begin()调用后立即返回，通过状态机跟踪连接进度（WL_IDLE_STATUS → WL_CONNECTED），15秒超时后自动重试

• MQTT通信：MqttReconnectTask 独立任务，每50ms处理MQTT消息收发。subscribe()后等待SUBACK确认（delay 300ms），避免握手消息丢失

• NTP时间同步：非阻塞轮询，每500ms检查一次同步结果，最多等待10秒。失败后30秒自动重试，不影响其他任务

• 离线模式：断网时所有本地功能（传感器、UI、雷达、灯光）正常运行，网络相关数据标记为离线。网络恢复后自动重连并补传数据

• 任务优先级设计：UI渲染（最高）> 传感器采集 > 网络通信 > 灯光控制，确保交互流畅不被网络阻塞

整个架构确保设备7×24小时稳定运行，网络状态变化不影响本地功能。

3.7.5 Blinker App 云平台通信

• 平台：Blinker IoT 物联网平台（点灯科技）

• 实现方式：直连 Blinker MQTT 协议（不依赖 Blinker 库，避免 ArduinoJson 版本冲突）

• 认证流程：HTTPS 请求 iot.diandeng.tech 获取动态 MQTT broker 凭证 → 独立 PubSubClient 连接 Blinker broker

• 上行控件（6个）：num-wendu(温度), num-shidu(湿度), num-eco2, num-pm25, num-lx(光照), num-ppb(TVOC)

• 下行控件：当前版本仅实现数据推送，灯光控制通过设备端 Web 管理面板或 MQTT 指令实现

• 合并发送：9 个控件打包到 1 条 MQTT publish，2 秒推送一次

• 安全设计：独立 WiFiClient/PubSubClient 实例不干扰主 MQTT，断网自动跳过，setSocketTimeout(2) 防看门狗

3.7.6 微信报警通知

• 推送方式：Blinker HTTP API（iot.diandeng.tech/api/v1/user/device/wxMsg/）发送微信模板消息

• 模板格式：标题 + 状态 + 消息内容（含实时数值）

• 检测周期：10 秒检查一次，各项报警独立冷却 2 分钟（Blinker 服务端限制 60s/条）

• 断网时自动跳过，不影响其他功能

报警阈值表：

报警项 | 阈值 | 级别 | 报警消息
AQI（空气质量指数） | ≥ 300 | 严重 | AQI值过高(XXX)，请注意室内通风
温度（上限） | ≥ 45°C | 紧急 | 室内温度过高，目前XX°C，疑似火灾！
温度（下限） | ≤ 5°C | 提醒 | 室内温度过低，目前XX°C
湿度（上限） | ≥ 85% | 提醒 | 室内湿度过高，当前XX%，注意防潮
湿度（下限） | ≤ 20% | 提醒 | 室内湿度过低，当前XX%，注意保湿
PM2.5 | ≥ 150 μg/m³ | 严重 | PM2.5浓度超标，当前XX μg/m³，请通风或佩戴口罩
eCO2（等效二氧化碳） | ≥ 2000 ppm | 严重 | CO2浓度过高，当前XX ppm，请开窗通风
TVOC（挥发性有机物） | ≥ 2200 ppb | 严重 | TVOC浓度过高，当前XX ppb，注意室内空气

3.8 灯光控制

3.8.1 控制方式

• 设备：Yeelight 智能灯带 1S

• 协议：Yeelight LAN Control Protocol（TCP JSON-RPC, port 55443）

• 控制接口：TCP JSON-RPC over port 55443（Yeelight LAN Control Protocol）

• 色温映射：0-100（APP值）→ 2700K-6500K（开尔文）

3.8.2 预设模板

• 暖光模式：亮度100%，色温3000K（专注/放松场景）

• 冷光模式：亮度80%，色温6500K（工作/提神场景）

• 白光模式：亮度80%，色温4500K（日常/中性场景）

本地智能决策阈值（IntelligenceTask，区别于微信告警阈值，用于本地早期预警）：CO₂告警 >1000ppm（微信2000ppm）；TVOC告警 >0.5mg/m³（微信2200ppb）；温度舒适度 18-28°C（含闷热26°C+60%、湿冷20°C+70%复合判断）；湿度舒适度 30-70%；专注休息建议 CO₂>1200ppm / 温度>28°C / 湿度>75%（冷却3分钟）；自动亮度 光照<100lux→40%亮度，>500lux→100%亮度（线性插值）；免打扰时段 22:00-08:00（需NTP时间同步）。

3.8.3 联动场景

• 专注模式：自动切换暖光（3000K）

• 退出专注：恢复先前灯光状态

• 远程控制：Web后台滑块调节亮度和色温

• 远程控制：Blinker App 数据推送（灯光控制已移除，通过 Web 管理面板或 MQTT 指令实现）

3.9 Web管理后台

3.9.1 粒子可视化

• 三路独立Canvas粒子系统：CO₂、湿度、温度

• CO₂映射：粒子数量（400ppm→30个，2500ppm→200个），颜色从青→橙→红渐变

• 湿度映射：粒子数量+大小（干燥→少而小，潮湿→多而大）

• 温度映射：粒子颜色（冷蓝紫→暖黄→热橙红）

• 粒子物理：布朗运动（随机加速度+速度阻尼），边界反弹

• 平滑过渡：指数移动平均（EMA），避免粒子数量突变

3.9.2 数字孪生控制面板

• 两阶段转场动画：模型放大移动→落位→面板分块出现

• 返回动画：面板隐藏→模型缩回卡片→恢复控制台

• 左侧面板：实时环境数据（CO₂/温度/湿度/AQI/PM2.5/光照）

• 右侧面板：设备控制（灯光开关/亮度/色温/专注模式/安全锁）

3.9.3 页面加载动画

• 主页面：导航栏从左展开→内容淡入上浮→卡片分批浮现

• 页面切换：路由淡入→块依次浮现，块间延迟约50ms

• 性能：主要使用transform+opacity，避免layout重排和filter:blur()

• 无障碍：支持prefers-reduced-motion，用户关闭动画时自动减少动效

3.9.3.1 网页端固件更新管理

设备内置Web服务器（http://cube.local/，mDNS局域网访问），提供全中文管理界面。固件更新卡片显示当前版本号，用户点击“检测更新”后设备通过MQTT向后端查询，若有新版本则显示确认/暂不按钮，用户确认后才执行OTA。更新过程中网页实时显示下载进度百分比。

3.9.4 OTA远程固件升级（已完整实现）

OTA远程固件升级功能已完整实现，支持通过MQTT协议检测新版本、网页端确认更新、HTTP流式下载固件、Flash分区写入、MD5完整性校验、自动重启生效的完整流程。

核心设计原则：设备不自动更新。所有OTA触发权交给网页端用户手动确认，防止误更新导致设备变砖。

OTA更新流程：

1. 用户在设备网页端（http://cube.local/）点击“检测更新”按钮

2. 设备通过MQTT发送version_check请求（含当前版本号）到后端服务器

3. 后端比较版本号，若有新版本则回复ota_update消息（code:200 + url + version + md5）

4. 设备收到后存储为待确认状态，网页端显示“发现新版本: vX.X.X”

5. 用户点击“确认更新”→ 设备启动OTA任务，暂停所有其他活动

6. HTTP流式下载固件 → 边下载边写入Flash → 实时更新进度条（0-100%）

7. 下载完成 → MD5校验 → 校验通过 → 3秒后自动重启生效

8. 若5秒内后端无响应，网页显示“已是最新版本”

线程安全架构：

OTA任务（Core 1）不直接调用任何LVGL函数。所有UI更新通过DataPool共享字段（status.ota_in_progress / ota_progress / ota_status_text）传递，由LVGL定时器任务（custom.c ui_refresh_timer_cb）在正确的线程上下文中渲染进度条。

OTA期间任务暂停机制：

OTA进行时（status.ota_in_progress=true），以下任务自动暂停：

• Task_Realtime_Control：雷达更新 + 专注模式状态机

• Task_DataRead：传感器数据采集

• MqttReconnectTask：数据上报/Blinker推送/心跳（但保持MQTT连接用于状态上报）

• IntelligenceTask：自动亮度/空气告警/舒适度评估/免打扰/专注会话记录与评分/CO₂趋势预测/历史数据（5秒周期，Core 1）

OTA完成或失败后，所有任务自动恢复。

技术规格：

• 分区表：8MB Flash（factory + ota_0 + spiffs，通过 partitions_8MB.csv 配置）

• 下载方式：HTTP流式下载，4KB缓冲区，边下载边写入

• 校验：MD5完整性校验（后端下发），校验失败自动丢弃

• 版本比较：vX.Y.Z格式，仅新版本号>当前版本才允许更新

• 进度显示：硬件TFT锁屏界面 + 网页端同步显示百分比

• 错误恢复：下载/写入/校验失败后5秒显示错误信息，自动恢复主界面

• 当前固件版本：v1.0.0（DataPool.h FW_VERSION宏定义）

3.9.5 开机GIF过渡加载

Web管理后台在首次加载时需要缓存粒子可视化引擎、角色图片、UI组件等静态资源，此过程存在数百毫秒至数秒的白屏时间。为优化用户等待体验，复用设备端开机动画素材“小眠苏醒”GIF作为过渡动画，在资源缓存期间全屏播放，下方同步显示Loading文字及进度指示。

• 素材复用：直接复用设备端开机GIF（img_boot_sleep），无需额外制作加载动画资源

• 双重价值：既美化了界面加载过程，又解决了缓存期间的白屏闪烁问题，优化了界面流程的连贯性

• 视觉设计：GIF居中全屏播放，下方显示“Loading…”文字与呼吸动画，背景色与主界面深色主题一致（#0d0d1a）

• 生命周期：资源缓存完成 → GIF淡出 → 主界面粒子可视化淡入，全程无白屏

• 二次访问：静态资源已缓存后直接跳过过渡动画，零延迟进入主界面

该方案巧妙复用已有开机动画素材，在不增加额外资源开销的前提下，将原本令人困扰的白屏等待时间转化为品牌IP展示窗口，提升了产品整体视觉完成度和用户体验连贯性。

3.10 设备安全

3.10.1 传输安全

• MQTT：数据上报与指令下发通过公共 EMQX Broker 传输

• HTTPS：后端 API、用户认证（JWT 令牌签发与验证）、配置下发全部使用 HTTPS

• 设备身份：设备临时 Token（MQTT 握手时由服务器动态下发）+ 用户端 JWT 令牌双重鉴权

3.10.2 防护机制

• 限流：单设备单位时间上报次数限制

• 短时封禁：同一MAC/Token/IP短时间内大量请求，自动封禁5分钟

• 永久黑名单：已封禁设备持续攻击，MAC地址加入永久黑名单

• 双层防护：应用层（Token/JWT/频率校验）+ 网络层（IP/MAC/流量过滤）

3.10.3 硬件安全

• 安全启动：仅运行合法签名固件

• Flash加密：Token、日志全部加密存储

• 防篡改：固件完整性校验

四、系统架构

4.1 端-边-云三层架构

端侧（ESP32-S3 硬件端，8MB Flash）

• 传感器数据采集（ENS160/AHT21/BH1750/LD2410B）

• 边缘AI推理（LightGBM PM2.5预测）

• 本地UI渲染（LVGL + 虚拟IP角色）

• 设备执行（Yeelight灯带 + 触控交互）

• 双核分工隔离（Core 1 业务逻辑 + Core 0 网络通信，通过 dataMutex 互斥锁同步）

边侧（设备端智能处理）

• 数据滤波与异常检测

• 专注质量评分（加权扣分：CO₂ 40% + 温度 35% + 湿度 25%）

• CO₂趋势预测（最小二乘法线性回归，30分钟滑动窗口）

• 专注期间智能休息建议（CO₂/温度/湿度阈值触发，3分钟冷却）

• 夜间免打扰模式（22:00-08:00自动抑制告警输出）

• 专注模式决策引擎

• 虚拟IP角色状态机

• 离线自治（断网时所有本地功能正常）

云侧（FastAPI + SQLite + WebSocket）

• MQTT Broker（公共 EMQX 服务）

• 数据持久化存储（SQLite + aiosqlite 异步驱动，6 张数据表：用户、设备、传感器数据、操作日志、语音日志、OTA日志）

• Web 管理后台（粒子可视化 + 数字孪生 + WebSocket 实时推送）

• 远程设备管控（灯光/安全锁/OTA/专注模式）、AI 环境评分与建议、"小眠"AI 对话助手（SSE 流式）

4.2 数据流

上行数据流：传感器采集 → 本地滤波 → 边缘AI推理 → 本地UI更新 + 灯控联动 → MQTT → 云端存储 → Web粒子可视化

下行指令流：Web后台 → MQTT → ESP32 → 执行（灯光/安全锁/模式切换/OTA）

4.3 模块化代码架构

• DataPool：全局数据池，统一管理传感器数据、设备状态、WiFi状态、角色状态

• 各模块围绕数据池运行，模块间不直接相互调用，高内聚低耦合

• 模块列表：sensor / screen / wifi / mqtt / focus_mode / pm25predict / bluetooth_light / ui / radar / security

五、通信协议与数据格式

5.1 MQTT 上报数据格式

传感器数据上报（Topic: cube2026/device/{did}/data）：

{

"device_id": "CUBE001",

"timestamp": 1720000000,

"temperature": 24.5,

"humidity": 52.0,

"eco2": 850,

"tvoc": 120,

"aqi": 2,

"pm25_predicted": 35.2,

"lux": 320,

"focus_mode": true,

"focus_duration": 3600,

"radar_present": true

}

5.2 MQTT 控制指令格式

灯光控制（Topic: cube2026/server/{did}/control）：

{

"cmd": "light_control",

"power": "on",

"brightness": 80,

"color_temp": 50

}

安全锁控制：

{

"cmd": "security_lock",

"action": "lock"

}

专注模式切换：

{

"cmd": "focus_mode",

"action": "enter"

}

5.2.1 版本检查请求（Topic: device/{did}/status）：

{"device_id": "CUBE001", "token": "xxx", "timestamp": 1753012800, "type": "version_check", "current_version": "v1.0.0"}

5.2.2 OTA更新响应（Topic: server/{did}/control）：

{"code": 200, "type": "ota_update", "msg": "新版本可用", "timestamp": 1753012801, "url": "http://server.com/firmware/v1.1.0.bin", "version": "v1.1.0", "md5": "d41d8cd98f00b204e9800998ecf8427e"}

code说明：200=有新版本可用，204=已是最新版本，401=Token无效，403=设备未授权

5.3 Yeelight HTTP API

• 开灯：GET /set?power=on

• 关灯：GET /set?power=off

• 亮度：GET /set?bright=80（1-100）

• 色温：GET /set?ct=4000（2700-6500K）

• 组合：GET /set?power=on&bright=80&ct=4000

六、性能指标

• 传感器采样周期：1秒

• PM2.5推理耗时：< 10ms（单次）

• PM2.5模型大小：约500KB（Flash）

• UI刷新率：约30fps（LVGL渲染）

• 粒子可视化：60fps（200+粒子）

• MQTT上报周期：2秒（传感器数据）/ 30秒（设备状态）

• WiFi重连：15秒超时 + 指数退避

• NTP同步：30秒重试间隔，10秒超时

• 触摸采样：约20ms/次

• RAM占用：约36%（启用PSRAM后）

• Flash占用：约3MB（固件）+ 2MB（SPIFFS）

七、版本信息

• 固件版本：v1.0.0

• LVGL版本：8.x

• Arduino框架：ESP32 Arduino Core 2.x

• 编译器：PlatformIO + GCC xtensa-esp32s3-elf

• 分区表：8MB Flash（factory 3MB + ota_0 3MB + spiffs 2MB）

八、规划中功能（待实现）

以下功能已纳入系统设计规划，将在后续版本中逐步实现。

8.2 系统调度与低功耗管理

• 定时任务：用户可预设时间触发特定操作（如定时开关灯、定时切换模式）

• 夜间低功耗模式：指定时段自动降低屏幕亮度、减少传感器采样频率

• 屏幕亮度自适应：BH1750读取环境光照 → PWM自动调节TFT背光亮度

• 毫米波待机：长时间无人时自动进入低功耗休眠，检测到人自动唤醒

8.3 算法模块扩展

• 人体舒适度评估：综合温湿度数据，计算体感舒适度指数（SSD），输出舒适/一般/不舒适

• 故障检测与隔离：传感器连续异常时自动标记故障、隔离该模块，不影响其他功能正常运行

• 屏幕亮度自适应算法：光照值 → 对数映射 → PWM占空比，平滑过渡不闪烁

8.4 微信告警推送

• 环境异常事件（CO₂超标、AQI恶化）自动推送微信消息

• 安全锁操作通知（锁定/解锁）

• 设备离线超时告警

• 对接方式：微信公众号/企业微信 API

8.5 一主多从分布式架构

• 一个主设备管理多个从设备（不同房间/位置）

• 云端统一管理所有设备，数据看板支持多设备切换

• 从设备通过MQTT注册到主设备账号，自动同步配置

8.6 开机自检

• 设备启动时自动检测各模块状态（传感器I²C通信、WiFi、MQTT连接）

• 异常模块在屏幕上显示红色警告图标

• 自检通过后进入正常主界面

8.7 霉菌风险监测

• ENS160传感器内置霉菌风险评估算法

• 综合温湿度数据，输出霉菌生长风险等级

• 高风险时角色提醒用户开窗通风、除湿

8.9 红外家电控制

• 红外收发模块学习空调/电视等红外遥控码

• 根据温湿度阈值自动调控空调（温度过高→开制冷，温度过低→开制热）

• 支持远程红外指令下发

8.10 音频播报

• DFPlayer Mini本地语音播报，零延迟

• 环境告警、AI建议、模式切换语音提示

• 断网超时自动语音提醒

8.11 SD卡本地存储

• 历史数据与运行日志本地存储，掉电不丢失

• 支持数据导出

8.12 云端AI增强

• 对接大模型，基于环境数据生成舒适度评分与场景建议

• 长期数据智能分析，输出环境优化方案

• 专注报告生成（已在设备端实现）：退出专注时本地生成专注质量评分（0-100分）+ 环境均值统计 + CO₂趋势预测，以半透明面板实时展示；云端进一步生成长期趋势分析与改进建议

• 云端TTS语音合成：支持普通话 + 多地方言（Edge-TTS）

• 对接公开气象接口，室内外温差计算与穿衣建议

## 8.13 启动流程（两阶段初始化）

- Phase 1（快速显示）：Serial + LVGL + 触摸屏 + UI界面初始化，约1秒内完成，启动画面立即渲染
- Phase 2（模块加载）：BH1750光照 → AHT21温湿度 → ENS160空气质量 → LD2410B雷达，每个模块最多5次重试
- 启动画面：纯黑背景 + 小眠角色图片 + 实时加载进度文字（白色）
- 模块加载期间持续显示启动画面，全部完成后自动淡入过渡到主界面
- 模块加载在独立FreeRTOS任务中运行（Core 1），不阻塞LVGL渲染
- LVGL定时器每500ms轮询modules_ready标志，确认加载完成后切换屏幕
