tianchuangya/SmartDesktopCube-IoT/智能桌面魔方——物联网竞赛项目系统方案.docx

智能桌面魔方

Smart Desktop Cube IoT

全国大学生物联网设计竞赛 — 系统方案

2026年7月

一、项目概述

1.1 一句话定义

智能桌面魔方是一款集环境感知、边缘AI推理、情感化交互、场景联动于一体的桌面物联网智能终端。它不只监测环境，更理解你的工作状态——在你专注时自动营造最佳氛围，在你离开时守护你的隐私。

1.2 我们解决的问题

桌面是每个人每天停留最久的工作空间，但市面上没有一款设备能同时做到：实时监测空气质量、理解你的专注状态、自动调节灯光氛围、用有温度的方式与你交互。传统环境监测仪只能显示数字，智能台灯只能手动开关，两者互不通信。

智能桌面魔方将环境感知、人体检测、灯光控制、边缘AI推理、情感化交互融合于一台设备，让桌面空间从"被动工具"升级为"主动智能伙伴"。

1.3 核心定位

硬件端（ESP32-S3）+ 网络端（FastAPI）分工协作：硬件端负责本地数据采集、边缘AI推理、触控交互与设备联动；网络端负责数据存储、远程管控与可视化。两大模块分工明确，系统低成本、高可靠、易落地。

二、场景故事：用户的一天

场景一：早晨 8:00 — 走近桌面，设备苏醒

用户走进书房，坐到了桌前。智能桌面魔方通过毫米波雷达无感检测到人体存在，屏幕自动亮起，虚拟IP角色从睡眠状态缓缓睁眼，做出欢迎动作。

屏幕主界面显示当前时间、室内温湿度、CO₂浓度。经过一夜封闭，CO₂可能偏高——设备上的粒子开始变得密集，这是用户第一眼就能感知到的空气质量信号。

用户打开窗户通风。随着新鲜空气流入，ENS160传感器实时捕捉CO₂下降趋势，屏幕上的粒子逐渐变得稀疏。虚拟IP角色露出微笑——"空气变好了"。

场景二：上午 9:00 — 专注工作，智能联动

用户开始工作。毫米波雷达持续检测到人体存在，超过设定阈值后，设备自动进入专注模式：

• 虚拟IP角色切换为安静陪伴状态，减少动效，不打扰

• Yeelight智能灯带自动切换为3000K暖光，营造专注氛围

• 屏幕中央显示专注计时器，记录每次专注时长

• 环境传感器持续监测，CO₂浓度若持续升高，角色会轻微提醒用户开窗

用户无需任何手动操作，整个流程由设备自动感知、自动决策、自动执行——这就是"感知-决策-执行"的完整闭环。

场景三：下午 14:00 — 远程查看，数据一目了然

用户在外出时，打开浏览器进入Web管理后台。

管理后台的核心是粒子可视化系统：CO₂、湿度、温度分别对应一片动态粒子区域。粒子越多越密集，代表数值越高；粒子稀疏清爽，代表空气优良。用户不需要读任何数字，扫一眼粒子的密度和颜色，就能立刻感知家中空气质量。

同时，管理后台支持数字孪生控制面板：点击设备卡片，设备模型平滑放大移动到屏幕中央，左右两侧展开实时环境数据和远程控制面板，用户可以远程开关灯、调节色温亮度。

场景四：晚上 22:00 — 离开桌面，安全锁定

用户离开书房。毫米波雷达检测到无人状态，超过设定时间后自动退出专注模式，灯光恢复默认。

如果用户需要保护隐私，可通过Web后台一键远程锁定设备。锁定后：屏幕锁定、触控失效、传感器停止上报、灯光禁用。ESP32-S3双核架构中，Core 1独立运行安全锁逻辑，即使Core 0的业务代码被攻击，安全状态依然保持。

三、系统架构

3.1 总体架构：端-边-云三层

系统采用"端-边-云"三层架构，充分发挥各层优势：

端侧 — ESP32-S3 硬件端

• 环境感知：ENS160（CO₂/TVOC/AQI/eCO₂）+ AHT21（温湿度）+ BH1750（光照）+ LD2410B（毫米波雷达）

• 边缘AI推理：LightGBM模型本地运行，4传感器特征融合 → PM2.5浓度预测

• 交互与执行：2.4寸触控TFT + 虚拟IP角色 + Yeelight灯带联动

• 安全机制：双核架构，Core 1独立运行安全锁

边侧 — 设备端智能处理

• 本地数据滤波与异常检测

• 专注模式决策引擎（雷达+时长+环境综合判断）

• 虚拟IP角色状态机（根据AQI/CO₂/模式自动切换表情）

• 离线自治：断网时所有本地功能正常运行，不受网络状态影响

云侧 — FastAPI 后端

• MQTT over TLS 安全通信

• 数据持久化存储与历史趋势分析

• Web管理后台（粒子可视化 + 数字孪生控制面板）

• 远程设备管控与安全锁

• Blinker App 物联网云平台（手机 App 远程查看传感器数据 + 按钮/滑块控制灯光）

3.2 数据流

上行：传感器采集 → 边缘AI推理 → 本地UI更新 + 灯控联动 → MQTT上报云端 → Web粒子可视化 + Blinker App 实时显示。

下行：Web后台/Blinker App → MQTT下发 → 设备执行（灯光控制 / 安全锁 / 模式切换）。

四、核心技术详解

4.1 边缘AI：PM2.5浓度预测（核心创新）

传统PM2.5监测依赖独立的激光粉尘传感器，成本高、体积大、功耗高。本项目创新性地采用"间接预测"方案：利用设备已有的温湿度、CO₂、TVOC四维传感器数据，通过LightGBM机器学习模型，在ESP32本地推理出PM2.5浓度。

技术路线

• 模型训练：在PC端使用公开环境数据集训练LightGBM回归模型，共1000棵决策树，每棵树30个内部节点 + 31个叶子节点

• 模型部署：通过自研convert_model_to_c.py工具，将训练好的模型自动转换为C语言数组，存储在ESP32 Flash（PROGMEM）中

• 边缘推理：ESP32读取4路传感器数据 → 遍历1000棵决策树 → 累加叶子节点值 → 输出PM2.5预测值（μg/m³）

• 性能指标：单次推理耗时 < 10ms，模型占用Flash约500KB，无需任何网络请求

为什么这是边缘计算

• 数据不出设备：4路传感器数据在ESP32本地完成推理，原始数据不上传云端

• 零网络依赖：断网状态下依然可以预测PM2.5

• 毫秒级响应：无需网络往返，推理结果即时可用

• 隐私保护：原始传感器数据不出设备，仅上传预测结果

与竞品的差异

绝大多数物联网竞赛作品将传感器数据直接上传云端，在服务器端进行分析。本项目将AI模型部署在端侧，实现了"云端训练 + 边缘推理"的完整链路，在技术深度和工程能力上具有显著优势。

4.2 粒子可视化：环境数据一眼感知

传统环境监测设备以数字和图表为主，用户需要思考"这个数值高不高？是否正常？"。粒子可视化采用直觉感知范式：

设计原理

• CO₂浓度 → 粒子数量：400ppm时30个粒子稀疏清爽，2500ppm时200个粒子密集拥挤。无需读数字，一眼感知空气质量

• 湿度 → 粒子数量：干燥时粒子少而小，潮湿时粒子多而大，40%-60%舒适区粒子适中

• 温度 → 粒子颜色：冷色（蓝紫）→ 暖黄 → 橙红，颜色本身就是温度的语言

技术实现

• 纯HTML5 Canvas实现，零依赖，单文件即可运行

• 每个粒子独立布朗运动（随机加速度+速度阻尼），模拟空气分子漂浮感

• 粒子数量通过指数移动平均平滑过渡，避免突变

• 中心半透明遮罩保护数据标签清晰可读

• 60fps稳定运行，支持200+粒子同时渲染

4.3 专注模式：无感检测 + 场景联动

专注模式是"感知-决策-执行"闭环的集中体现：

• 感知层：LD2410B毫米波雷达无感检测人体存在，无需穿戴设备、无需手动触发

• 决策层：持续检测到人体 + 超过设定阈值 → 自动进入专注模式；检测到离开 + 超时 → 自动退出

• 执行层：进入专注 → 虚拟IP角色安静陪伴 + Yeelight灯带切换3000K暖光 + 计时器启动

整个流程用户无需任何操作，设备自动感知、自动决策、自动执行。

4.4 虚拟IP角色：有温度的情感化交互

摒弃传统RGB灯珠告警方案，采用专属二次元虚拟IP角色作为设备的情感化交互核心：

• AQI优良 → 角色微笑放松

• 轻度污染 → 角色轻微担忧

• 严重超标 → 角色紧张警示

• 专注模式 → 角色安静陪伴，低动效，不打扰

• 设备锁定 → 角色抱胸严肃，显示锁态图标

• 开机 → 角色从睡眠中苏醒，缓缓睁眼

• 温度驱动换装 → 角色服饰根据实时温度自动切换：寒冷穿厚棉服围巾、凉爽穿薄外套、舒适穿短袖、炎热穿背心，用户从角色穿着即可直觉感知温度

所有角色图片存储于ESP32 SPIFFS文件系统，分类管理，低帧率渲染不卡顿。全程统一IP形象，形成强烈的项目视觉标识。

4.5 双核安全锁：硬件级隐私保护

基于ESP32-S3双核架构实现硬件级安全隔离：

• Core 0：负责显示、传感器、联网、交互等业务逻辑

• Core 1：独立运行安全锁逻辑，与Core 0物理隔离

• 锁定后：屏幕锁定、触控失效、传感器停止上报、灯光禁用

• 即使Core 0业务代码被攻击，Core 1的安全状态依然保持

• Web后台一键远程锁定/解锁，DID + Token双重鉴权

4.6 Yeelight智能灯光：即插即用的场景联动

选用Yeelight智能灯带1S（2700K-6500K色温，1%-100%亮度），通过WiFi局域网HTTP API直接控制。ESP32主控发送HTTP GET请求即可完成开关灯、亮度调节、色温调节。

与专注模式深度联动：进入专注→自动切换3000K暖光，退出专注→恢复先前灯光状态。方案优势：零接线、零额外硬件、即插即用，代码量仅为自研BLE+MOS方案的1/5。

4.7 OTA远程固件升级：安全可控的空中更新

智能桌面魔方支持完整的OTA（Over-The-Air）远程固件升级能力，实现“云端推送 + 用户确认 + 安全下载 + 自动校验”的四步更新流程。

设计哲学：设备永不自动更新。后端检测到新版本后仅推送通知，实际更新必须由用户通过设备网页端（http://cube.local/）手动确认。这确保了用户对设备的完全控制权，避免误更新导致设备不可用。

技术实现：OTA任务运行在Core 1独立FreeRTOS任务中，通过DataPool共享字段与LVGL渲染线程通信（线程安全），下载期间自动暂停传感器采集、雷达检测、数据上报等所有非关键任务，将CPU和带宽资源集中用于固件下载。

安全保障：MD5完整性校验（后端下发校验值）、版本号递增比较（仅允许升级不允许降级）、下载失败自动回滚（不影响当前固件）。

协议设计：设备发送version_check（含当前版本）→ 后端比较后回复ota_update（code:200+url+version+md5 或 code:204已是最新）→ 设备存储待确认 → 用户网页确认 → 执行OTA。

4.8 启动流程：两阶段初始化与模块自检

系统上电后采用两阶段初始化策略，确保用户第一时间看到启动画面，而非黑屏等待：

Phase 1（快速显示，约1秒）：初始化Serial调试口、LVGL图形引擎、触摸屏驱动、UI界面框架。启动画面立即渲染：纯黑背景 + 小眠角色图片 + 白色状态文字。

Phase 2（模块加载，2-12秒）：在独立FreeRTOS任务中依次初始化BH1750光照传感器、AHT20温湿度传感器、ENS160空气质量传感器、LD2410B毫米波雷达。每个模块最多重试5次（含I2C总线恢复），加载期间启动画面实时显示当前加载模块名称。

过渡机制：LVGL定时器每500ms轮询modules_ready标志，全部模块加载完成后自动淡入过渡到主界面。任何模块失败不阻塞启动，标记为离线后继续。

设计优势：用户感知启动时间从12秒缩短到1秒（立即看到画面）；模块故障不影响系统启动；I2C总线恢复机制解决烧录后传感器卡死问题。

五、硬件选型

• 主控：ESP32-S3 N16R8（双核240MHz，16MB Flash，8MB PSRAM）

• 显示屏：2.4寸 TFT LCD（ILI9341驱动，320×240分辨率，XPT2046电阻触摸）

• 环境传感器：ENS160（CO₂/TVOC/AQI/eCO₂）+ AHT21（温湿度）

• 光照传感器：BH1750

• 毫米波雷达：LD2410B（人体存在检测，0.75-6m范围）

• 灯光：Yeelight智能灯带1S（WiFi HTTP API，2700K-6500K）

• 电源：USB-C 5V供电

六、创新点与竞赛优势

1. 边缘AI推理（最大亮点）

1000棵决策树的LightGBM模型部署在ESP32端侧，4传感器特征融合预测PM2.5浓度。数据不出设备、推理不依赖网络、毫秒级响应。在物联网竞赛中，将AI模型部署到端侧的作品极为罕见，技术深度具有显著优势。

2. 粒子可视化

以动态粒子系统的密度、大小、颜色替代传统数字仪表盘，实现环境数据的"直觉感知"。创意独特，视觉冲击力强，在答辩展示中具有极强的记忆点。

3. 虚拟IP情感化交互

专属二次元角色替代传统灯光告警，通过表情和动作传递环境状态。无额外硬件、低成本、高辨识度，形成项目独有的品牌IP。

4. 专注模式无感联动

毫米波雷达无感检测→自动进入专注→灯光自动切换暖光→计时器启动→离开自动退出。完整的"感知-决策-执行"闭环，无需用户任何手动操作。

5. 双核硬件级安全锁

利用ESP32-S3双核架构实现Core 0业务与Core 1安全的物理隔离，锁定后所有功能禁用，即使业务核被攻击安全状态依然保持。

6. 端-边-云三层架构

端侧感知与执行、边侧AI推理与决策、云侧存储与可视化，三层分工明确，系统稳定可靠，断网离线可用。

7. 模块化代码架构

全局数据池 + 模块化设计，传感器/WiFi/MQTT/UI/雷达/灯光各模块独立运行，高内聚低耦合。

8. 温度驱动角色换装

虚拟IP角色“小眠”的穿着服饰根据AHT21传感器实时采集的室内温度自动切换：寒冷穿厚棉服围巾、凉爽穿薄外套、舒适穿短袖、炎热穿背心。将环境温度从抽象数字转化为直觉感知的角色穿着变化，进一步深化了情感化交互的设计理念，在竞赛作品中具有独特的创意记忆点。

9. 开机GIF过渡加载

Web管理后台首次加载时复用设备端开机动画“小眠苏醒”GIF作为过渡动画，下方显示Loading文字。既美化了界面加载过程，又解决了静态资源缓存期间的白屏闪烁问题，将原本的等待时间转化为品牌IP展示窗口，提升了产品整体视觉完成度和用户体验连贯性。

七、团队分工

• 成员1：硬件核心开发、系统架构、边缘AI模型部署、虚拟IP交互、安全机制、固件开发

• 成员2：后端服务（FastAPI）、MQTT通信、AI模型训练、Web管理后台、粒子可视化

• 成员3：测试验证、文档撰写、PPT制作、演示视频、结构设计

八、附录：Web管理后台技术规格

8.1 粒子可视化引擎

• 纯HTML5 Canvas实现，零依赖，单文件部署

• 三路独立粒子系统：CO₂（数量映射）、湿度（数量映射）、温度（颜色映射）

• 布朗运动粒子物理，每个粒子独立随机加速度+速度阻尼

• 指数移动平均平滑过渡，避免粒子数量突变

• 60fps稳定运行，支持200+粒子同时渲染

8.2 页面加载动画方案

• 主页面：左侧导航栏从左展开 → Logo/导航项/用户区依次淡入 → 顶部栏下落 → 内容区淡入上浮 → 卡片从下往上分批浮现

• 页面切换：路由内容整体淡入 → 页面内块按顺序从下往上浮现，块间有轻微延迟

• 数字孪生转场：设备卡片模型放大移动到屏幕中央 → 模型落位后 → 控制面板分块出现

• 性能原则：主要使用transform+opacity，避免filter:blur()和layout重排，支持prefers-reduced-motion

8.3 数据接入

• MQTT over WebSocket 实时数据流

• JSON格式：{device_id, co2_ppm, humidity_pct, temperature_c, pm25_ugm3, timestamp}
