tianchuangya/SmartDesktopCube-IoT/双核分工.docx

【核心 0（协议核 / 网络核）】

专职：所有异步通信、后台、非实时任务

- Wi-Fi 连接与断网重连
- 网络协议（TCP/MQTT/HTTP）
- 后端数据上传、API 交互
- TLS 加密、Token 鉴权
- 蓝牙 BLE 通信

作用：保证网络永远稳定、不卡前端、不掉线。

【核心 1（应用核 / 实时核）】

专职：所有本地实时控制、用户交互、传感器

- 传感器采集（BH1750/AHT20/ENS160）
- 数据滤波、AI 本地推理
- LVGL 屏幕 UI 渲染
- 本地语音播报（Edge-TTS）
- 红外控制、设备联动
- 实时逻辑判断、警报触发
- SD 卡文件读写（语音文件、配置、日志）

xTaskCreatePinnedToCore( 任务函数名, "任务名字", 堆栈大小, 传递参数, 优先级, 任务句柄, 核心编号 );

堆栈大小：4096 → 普通任务（传感器、WiFi、MQTT、逻辑） 8192 → 中等任务（语音、SD卡、文件、字符串处理） 16384 → 大任务（LVGL屏幕、TTS语音、复杂AI、大量缓存）
