tianchuangya/SmartDesktopCube-IoT/未来扩展功能.docx

## 语音交互接口预留

硬件端已预留 I2S 音频接口与 MEMS 麦克风焊盘位置，未来可升级为：

- 离线语音关键词识别（基于乐鑫 ESP-Skainet 框架）
- 本地语音控制专注模式切换、台灯调节、温湿度查询
- 无需网络、低延迟、隐私安全

当前版本聚焦核心环境监测与专注闭环，语音交互为下一迭代方向。

## 红外家电控制接口预留

PPT页面建议：一页讲清楚

页面标题：红外家电控制 —— 空调自动调控

页面布局（分三栏）：

左栏：控制逻辑

触发条件

- 温度 > 28℃ → 自动开启空调制冷
- 温度 < 18℃ → 自动开启空调制热
- 专注模式激活 → 温度调节至 25℃ 舒适区间

控制方式

- 自动模式：根据温度阈值自主决策
- 远程模式：网页端/微信端手动控制
- 本地模式：屏幕触控面板快捷操作

中栏：技术架构

红外学习与发射

- 红外收发一体模块，支持遥控码学习
- 命令表驱动架构：ir_control 指令统一调度
- 发射后切换至接收模式，验证空调应答信号
- 闭环控制：发送 → 接收确认 → 状态反馈

现场演示说明

- 因比赛场地空调型号未知，无法提前学习遥控码
- 现场通过 屏幕弹窗 验证完整控制链路
- 红外发射管同步闪烁，提供物理层反馈
- 用手机摄像头捕捉演示
- Ppt中放入5秒视频演示设备控制寝室空调

右栏：架构图（简版）

text

┌──────────────┐

│ 温度传感器 │

│ (AHT21) │

└──────┬───────┘

│ 温度数据

▼

┌──────────────┐ ┌──────────────┐

│ 阈值判断 │────▶│ 红外发射 │

│ (command) │ │ (KY-005) │

└──────────────┘ └──────┬───────┘

│ 红外信号

▼

┌──────────────┐

│ 空调设备 │

└──────────────┘

页面底部补充说明（小字）

部署适配说明：实际使用时，只需通过红外学习功能录入一次遥控码，系统即可适配任意品牌空调。红外指令存储于命令表中，学习过程无需修改核心代码。当前演示版本聚焦于系统链路的完整性和控制逻辑的正确性，红外实际触发已通过 LED 指示和屏幕弹窗验证。

答辩时的口述配合

“关于空调控制，我们设计了完整的红外学习、阈值触发和闭环验证机制。由于比赛现场空调型号不确定，我们通过屏幕弹窗和红外发射管闪烁来验证完整链路。实际部署时，只需学习一次遥控码即可适配任意空调，这是我们工程上的设计考量。”
