tianchuangya/SmartDesktopCube-IoT/2026年全国大学生物联网设计竞设计文档初稿.docx

全国大学生物联网设计竞赛

智能桌面魔方

学校名称： | 宁波工程学院
团队名称： | 天幕智创
队长： | 钱泽琳
队员1： | 缪卓珲
队员2：
队员3：

全国大学生物联网设计竞赛组委会

2020年7月

智能桌面魔方

# 摘要

本设计面向校园与居家桌面场景，提出一款集环境监测、智能交互、远程管控、AI 分析于一体的物联网智能终端方案。设备以 ESP32-S3 为核心，实现温湿度、光照、空气质量多维度数据采集，搭配触控显示、语音播报、氛围灯提示与红外家电控制功能。系统采用非阻塞联网、模块化架构、故障隔离与表驱动编程，支持离线运行与自动重连。后端提供数据可视化、AI 健康建议、远程配置及微信告警服务，通信全程采用 MQTT over TLS 与 HTTPS 加密，并通过 DID+Token 鉴权、限流封禁、Flash 加密等机制保障安全。作品功能完整、架构规范、实用性强，可直接落地部署。

关键词：智能桌面；环境监测；物联网；ESP32-S3；MQTT 加密；AI 分析；红外控制；微信告警

目 录

# 第1章 设计需求分析

（本章节主要描述面向什么需求设计了本作品，本作品主要解决了什么问题，或对什么现有产品或应用作出了改进等）

## 1.1 桌面环境智能监测与交互的现实需求

### 1.1.1 传统桌面监测设备的功能局限性

当前市场上的桌面环境监测设备普遍存在功能单一、场景适配性差的问题：多数产品仅支持温湿度基础监测，缺少空气质量、光照强度等多维度数据采集；且普遍依赖屏幕单一展示方式，缺乏语音、灯光、远程通知等多通道交互能力，无法满足用户对健康环境感知与智能提醒的需求。

### 1.1.2 现有设备在智能联动与自动化上的不足

传统监测设备多为 “数据展示工具”，缺乏与家电设备的联动控制能力，无法根据环境参数自动调节空调、灯具等设备；同时多数产品依赖手机 APP 操作，缺少本地触控、离线运行、自动重连等高可用设计，网络异常时设备易陷入瘫痪状态，影响用户体验。

### 1.1.3 物联网终端的安全与工程化短板

市面低成本物联网设备普遍存在安全防护薄弱问题：通信未加密、身份无校验、数据易被篡改；同时代码架构松散，缺少模块化设计、故障隔离、表驱动编程等工程化实现，后期维护与扩展难度大，不符合竞赛对项目规范性与安全性的要求。

# 第2章 特色与创新

（本章节主要描述作品与现有其他技术或应用相比所产生的优势和创新点）

## 2.1 多维度环境感知与一体化交互创新

### 2.1.1 复合式环境监测方案

本作品突破传统桌面设备单一温湿度监测的局限，集成温湿度、光照、空气质量三类传感器，实现桌面环境的全维度感知。其中，ENS160 空气质量传感器可精准识别有害气体浓度，弥补了市面同类产品在室内健康监测上的空白，为用户提供更全面的环境健康参考。

### 2.1.2 多通道融合交互设计

作品构建了 “本地触控 + 语音播报 + 氛围灯提示 + 微信告警” 的多通道交互体系，相比传统设备仅依赖屏幕显示的单一交互方式，用户可通过视觉、听觉、远程通知等多种渠道获取信息，交互体验更直观、更及时，适配学习、工作等多种场景需求。

## 2.2 工程化架构与高可用设计创新

### 2.2.1 模块化代码与表驱动编程架构

硬件端采用分文件模块化开发，将显示、传感器、网络、安全等功能独立封装，实现故障隔离；同时通过表驱动命令管理模式，新增功能仅需修改配置表，无需改动主流程，相比传统线性代码，大幅提升了系统的可维护性与扩展性，符合工业级开发规范。

### 2.2.2 非阻塞异步联网与离线运行机制

系统采用非阻塞 WiFi+MQTT 架构，断网时自动进入离线模式，本地数据采集、显示功能不受影响；每 10 秒自动尝试重连，超过 1 分钟未恢复则语音告警，解决了传统物联网设备 “断网即瘫痪” 的痛点，大幅提升了设备的可用性与稳定性。

## 2.3 全链路安全防护与场景化优化创新

### 2.3.1 多重安全防护体系

作品在通信层采用MQTT over TLS 与 HTTPS 全链路加密，身份验证采用 DID 设备唯一标识 + 临时 Token 双重校验，同时结合限流封禁、Flash 加密、安全启动等机制，相比普通物联网设备的明文传输与弱身份验证，安全性提升显著，有效防范数据篡改与恶意攻击。

### 2.3.2 场景化智能联动与低功耗优化

针对桌面学习场景，设计了专注模式与日常模式双系统，可根据用户需求自动调节播报频率与红外控制策略；同时实现屏幕亮度自适应、夜间低功耗模式，兼顾了使用体验与能耗控制，相比通用型设备更贴合校园与居家桌面的实际使用场景。

# 第3章 功能设计

（本章节主要描述作品根据需求分析所规划设计的各种功能，着重体现这些功能的作用）

## 3.1 环境感知与数据采集功能

### 3.1.1 多维度环境数据采集

设备搭载 ENS160+AHT21 温湿度空气质量组合传感器、BH1750 光照传感器，实现桌面环境的多维度数据采集：

- 温湿度：实时监测室内温湿度，为舒适度评估与红外控制提供依据
- 光照强度：采集环境亮度数据，用于屏幕亮度自适应调节
- 空气质量：监测有害气体浓度并完成等级判定，为健康预警提供支撑

### 3.1.2 数据预处理与稳定输出

通过均值滤波、限幅滤波算法对采集数据进行处理，去除噪声与突变值，保证数据稳定可靠，为后续的显示、分析与控制功能提供高质量数据支撑。

## 3.2 地交互与控制功能

### 3.2.1 触控显示与状态反馈

搭载 2.4 寸触控 TFT 显示屏，实现多页面数据可视化展示，支持日常模式 / 专注模式切换，网络离线时自动进入离线界面，持续显示本地数据并提示网络状态。

### 3.2.2 语音播报与灯光提示

内置语音喇叭与 WS2812 氛围灯，可实现 AI 健康建议播报、网络异常提醒、故障告警等语音反馈；氛围灯随环境参数、设备状态自动变色，以灯光方式直观提示环境健康等级与设备运行状态。

### 3.2.3 红外家电自动控制

根据预设温湿度阈值，通过红外发射模块自动控制空调等家电设备启停，实现桌面环境温度的自动化调节，提升用户使用便捷性。

## 3.3 网络通信与远程功能

### 3.3.1 非阻塞联网与离线运行

采用非阻塞 WiFi+MQTT 架构，设备可在联网过程中继续运行本地功能；断网时自动进入离线模式，本地数据采集、显示、控制功能不受影响，网络恢复后自动同步数据。

### 3.3.2 数据上传与指令接收

通过 MQTT over TLS 加密通道，将环境数据上传至后端服务器；同时接收后端下发的控制指令、语音文本数据，实现远程管控与交互联动。

### 3.3.3 微信告警与远程通知

当环境参数超标、传感器故障或网络异常时，设备主动上报事件，后端通过微信公众号测试号向用户推送告警消息，实现异常情况的远程实时提醒。

## 3.4 安全防护与系统管理功能

### 3.4.1 身份鉴权与通信加密

采用 DID 设备唯一标识 + 临时 Token 双重身份校验，通信全程采用 MQTT over TLS 与 HTTPS 加密，防止数据被篡改与非法访问，保障设备与数据安全。

### 3.4.2 硬件自检与故障隔离

设备开机时自动检测传感器、屏幕、喇叭、网络等模块状态，任一模块故障时不影响整机运行，并通过交叉告警方式提示用户，实现故障隔离与高可用运行。

### 3.4.3 低功耗与自适应管理

支持夜间低功耗模式、屏幕亮度自适应调节，根据环境光照、运行模式动态调整设备功耗策略，兼顾使用体验与能耗控制，延长设备续航时间。

# 第4章 系统实现

（本章节主要描述实现功能所采用物联网技术架构，包括感知层技术、传输层技术、控制层技术、软件开发技术、云应用、数据挖掘和可视化应用等。）

## 4.1 感知层技术实现

### 4.1.1 硬件平台与传感器配置

系统以 ESP32-S3 为主控单元，搭载多类传感器与交互模块：

- 核心控制：ESP32-S3 开发板，集成 WiFi 与蓝牙功能，支持 Arduino 开发环境
- 环境感知：ENS160+AHT21 温湿度空气质量组合传感器、BH1750 光照传感器
- 交互模块：2.4 寸触控 TFT 显示屏、WS2812 氛围灯、无源语音喇叭、红外发射模块

### 4.1.2 数据采集与预处理实现

传感器通过 I2C、单总线等接口与主控通信，实现环境数据的实时采集；通过均值滤波与限幅滤波算法对原始数据进行去噪处理，消除数据抖动与异常值，保证数据的稳定性与可靠性。

## 4.2 传输层技术实现

### 4.2.1 通信协议与加密实现

- 采用 WiFi 无线通信方式接入网络，通过 MQTT 3.1.1 协议实现设备与后端的双向数据传输，全程采用 TLS 加密保障通信安全
- 设备与后端的 HTTP 接口通信采用 HTTPS 协议，结合 DID 设备唯一标识与临时 Token 双重身份校验，防止数据篡改与非法访问

### 4.2.2 非阻塞联网与离线机制实现

采用非阻塞式 WiFi 连接与 MQTT 客户端设计，联网过程中设备可继续运行本地功能；断网时自动进入离线模式，本地数据采集与显示功能不受影响，网络恢复后自动重连并同步数据。

## 4.3 控制层技术实现

### 4.3.1 模块化软件架构设计

硬件端采用分文件模块化开发，将显示模块、传感器模块、网络模块、安全模块等功能独立封装，实现功能解耦与故障隔离；通过表驱动命令管理模式，统一处理本地触控、远程指令、红外控制等命令，提升系统可维护性与扩展性。

### 4.3.2 系统调度与故障隔离实现

采用非阻塞异步调度机制，保证传感器采集、屏幕刷新、网络通信、语音播报等任务互不阻塞；开机时自动执行硬件自检，任一模块故障时不影响整机运行，并通过交叉告警方式提示用户，实现故障隔离与高可用运行。

## 4.4 软件开发与实现环境

### 4.4.1 开发环境与语言

硬件端基于 Arduino IDE 开发，采用 C/C++ 语言编写程序，通过各类第三方库实现传感器驱动、屏幕显示、网络通信等功能；后端采用 Python/Java 开发，搭建轻量级 Web 服务与 MQTT Broker。

### 4.4.2 关键技术库与工具

硬件库：TFT_eSPI 显示库、Adafruit Unified Sensor 传感器库、PubSubClient MQTT 库、IRremote 红外控制库

安全库：mbedtls 加密库，实现 TLS 通信与 Flash 数据加密

开发工具：串口调试助手、MQTT 客户端测试工具、微信公众平台测试号

## 4.5 云应用与数据服务实现

### 4.5.1 后端服务与数据存储

后端服务接收设备上传的环境数据，实现数据持久化存储；提供 Web 管理面板，支持用户查看历史数据、配置触发阈值、远程控制设备。

### 4.5.2 AI 分析与消息推送

后端对接大模型 API，基于环境数据生成人体舒适度评估与健康建议；通过微信公众号测试号接口，向用户推送异常告警消息，实现远程实时提醒。

### 4.5.3 数据可视化与用户交互

通过 Web 端实现环境数据的可视化展示，生成温湿度、光照、空气质量的历史趋势曲线；支持用户通过网页配置设备参数、查看设备状态、接收系统通知，实现完整的远程交互闭环。

# 第5章 其他内容

（本章节主要描述前文未涉及的内容，如作品的工业设计、作品的成本计算等）

## 5.1 作品工业设计与结构实现

### 5.1.1 整体外观与结构布局

本作品采用一体化紧凑设计，外壳选用简约立方体造型，适配桌面场景摆放；主控板、传感器、交互模块分层布局，顶部为传感器与显示屏区域，侧面预留红外发射窗口与散热孔，兼顾美观性与实用性，减少对桌面空间的占用。

### 5.1.2 人机交互与使用体验优化

设备采用正面触控屏 + 顶部指示灯的交互设计，屏幕界面布局简洁直观，数据信息分区展示；氛围灯采用柔和渐变效果，避免强光干扰学习与工作，同时外壳采用哑光材质，减少反光影响，提升使用体验。

## 5.2 5.2 成本核算与性价比分析

### 5.2.1 硬件成本明细

作品硬件均采用高性价比开源模块，总成本控制在百元级区间，具体如下：

模块 | 型号 / 规格 | 单价（元）
主控板 | ESP32-S3 开发板 | 31
传感器模块 | ENS160+AHT21、BH1750 | 42
显示模块 | 2.4 寸 TFT 触控屏 | 26
交互模块 | WS2812 灯条、喇叭、红外模块 | 15
电源与配件 | 杜邦线、外壳、电源模块 | 15
合计 | | 129

### 5.2.2 成本控制与性价比优势

相比市面同类功能的商用物联网设备，本作品成本仅为其 1/5 左右，同时保留了多维度监测、远程告警、自动化控制等核心功能，在低成本的基础上实现了较高的功能完整性与工程化设计，具备较强的推广应用潜力。

## 5.3 5.3 作品推广价值与应用展望

### 5.3.1 应用场景拓展

作品可直接应用于校园宿舍、家庭书房、办公桌面等场景，为用户提供健康环境监测与智能提醒；同时可通过扩展传感器模块，适配教室、实验室等更多场景的环境监测需求。

### 5.3.2 后续优化方向

后续可优化方向包括：优化外壳结构设计提升散热性能、扩展蓝牙连接功能实现本地数据备份、增加电池模块实现便携使用、接入更多类型传感器拓展监测维度，进一步提升设备的实用性与场景适配性。

# 参考文献

（请按规范列举参考文献，参考文献格式请按照GB/T 7714规范）

[1] 物联网嵌入式系统设计指南[M].中国电子技术标准化研究院. 2020.

[2] Espressif Systems. ESP32-S3 官方技术手册[EB/OL].Espressif Systems. 2023.

[3] MQTT 3.1.1 协议规范[S].OASIS Open. 2016.

[4] Arduino 编程入门与项目实践[M].机械工业出版社. 2021.

[5] 微信公众平台测试号开发文档[EB/OL].腾讯科技(深圳)有限公司. 2024.

全国大学生物联网设计竞赛设计文档[智能桌面魔方]
