tianchuangya/SmartDesktopCube-IoT/关于红外模块.docx

我们在系统架构中完整预留了红外控制模块。硬件上在PCB板上预留了红外发射管的接口和GPIO引脚；软件上采用了命令表驱动，已经定义了ir_control命令的完整数据协议。考虑到现场演示环境空调不可控，现场演示采用UI模拟反馈来验证完整链路，我们编写了Demo函数来模拟该接口的完整调用与反馈流程。实际部署时，只需学习一次遥控码，填入预留接口，无需修改任何核心代码即可实现真实控制
