tianchuangya/SmartDesktopCube-IoT/屏幕边缘灯带.docx

1. 显示规则（最舒服、最专业）

- 屏幕最外圈 4~6px 宽度，纯颜色，不画任何 UI
- 中间区域正常显示数据（时间、温湿度、空气质量）
- 外圈 = 环境氛围灯

2. 颜色规则

- 空气优（AQI≤50 / CO₂正常）：青绿色 / 天蓝色
- 良好：浅绿色
- 一般：黄色
- 差 / CO₂超标：橙色 → 红色
- 严重超标：红色快闪呼吸

3. 呼吸速度规则

- 优良：慢呼吸（周期 4 秒）
- 中等：中速（周期 2 秒）
- 差：急促呼吸（周期 1 秒）
- 严重超标：极急促（0.5 秒）+ 闪烁提醒
