tianchuangya/SmartDesktopCube-IoT/市场调研报告.docx

我调查了目前市场上大部分的普通价位的桌面产品（包括桌面智能桌宠、桌面智能时钟等）发现在这个关于温度这个功能方面做文章的挺少，主要是目前温度显示，少部分产品能做到天气预报等功能，针对这些我觉得我们可以针对一下方向入手，增加我们产品差异性：

1、 极端温度、天气（包括但不限于雨天，大风、炎热等天气）预报和警示
2、 定时或主动进行预报

针对上述的预报，用户可以自行设置自动提醒和每日固定时间进行播报

也可以用户主动询问的方式进行播报

3、 区别于天气预报只是大范围的温度和市场上产品无场景关联只是冰冷数据，本地部署的温湿度模块可以实时查看室内温度与湿度，从而达到室内外体感温度差过大的精准预警。或者基于桌面局部温湿度，计算体感舒适度等级（舒适 / 干燥 / 闷热 / 湿冷）

干燥：“建议补水，可开启加湿器”

闷热：“建议开启空调 + 开窗通风”

温差大：“建议增减衣物，避免着凉”

4、 通过云端记录（带个人账号登录的 Web 后台）：结合最近几日的温度湿度，可以准确比较出相较于前几日的温度差，从而提心用户添加/减少衣物，区别于传统桌面智能宠物对温度掌握只是数字上变化，而我们可以做到记录、对比、判断

实现 ：实时数据看板

历史环境曲线（日 / 周 / 月）

自定义提醒阈值

远程查看设备状态

5、区别传统桌面智能宠物对温度变化只是简单提醒，而我们通过红外遥控（服务器调用智能家居api（不考虑））来自动打开空调实现温度的调控，并在温度恢复到人体体感适宜温度时关闭

建议：考虑到实际会受到物体遮挡，导致空调红外接收失败，可以做分体式红外转发器，采用分离式设计来避免，同时做到减少产品臃肿的设计，后期可以扩展至智能家电控制

5、 多场景化设计：用户可通过设备本地触控屏或者网页端后台一键切换，支持定时自动开启/关闭。具体实现：

【专注模式】：

交互屏蔽：设备端屏幕自动降低亮度、关闭动态效果，禁用非必要的弹窗提醒、语音播报，仅保留基础环境数据显示，全程不打扰用户沉浸式专注状态

静默监测：后台持续正常采集桌面温湿度、室内外环境数据，不中断核心监测功能，所有异常预警转为静默记录，仅在网页端后台留存，不弹出打扰

温和联动：仅在环境出现极端异常（如温度超32℃、湿度低于30%）时，才以极温和的方式触发红外联动，自动开启空调/风扇调节环境，全程无声光打扰

状态留存：退出专注模式后，自动推送专注时段内的完整环境报告，告知用户期间环境变化、异常情况，不遗漏关键信息

【日常模式】：

全功能开放：正常开启所有环境提醒、定时播报、主动查询功能，屏幕亮度、交互效果恢复常规状态

智能联动生效：桌面环境超出舒适阈值时，正常触发弹窗提醒、设备端提示，同步启动红外联动控制空调、风扇等家电，自动调节桌面微环境

场景化建议推送：实时结合环境数据，推送对应办公场景的舒适度建议，辅助用户保持良好的桌面工作环境

数据同步：所有环境数据、联动记录实时同步至云端个人账号后台，完整留存历史记录

6、 云端设备检测：

网页端实时展示设备在线 / 离线状态（绿色 = 在线、红色 = 离线），同步监测 3 类异常（设备异常、传感器异常、环境异常）并推送告警，网页端增设 “异常记录” 模块，分类留存所有告警信息，支持按时间筛选查看，方便查看维修

7、 个性化阈值自适应：

系统内置人体舒适默认区间，用户可在网页端自行修改上下限，比如觉得偏热，可把上限调到 27℃，达到这个温度就自动打开空调
