tianchuangya/SmartDesktopCube-IoT/作品提交/2026年全国大学生物联网设计竞设计文档.docx

全国大学生物联网设计竞赛

智能桌面魔方

学校名称： | 宁波工程学院
团队名称： | 天幕智创
队长： | 钱泽琳
队员1： | 缪卓珲
队员2： | 许俊翔
队员3：

全国大学生物联网设计竞赛组委会

2026年7月

智能桌面魔方

# 摘要

本作品面向宿舍、书房、办公室等桌面学习与办公场景，设计并实现了一款集环境感知、专注陪伴、远程管控、前端可视化和云端分析于一体的物联网智能终端。硬件以 ESP32-S3 为核心，集成 AHT21 温湿度传感器、ENS160 空气质量传感器、BH1750 光照传感器、LD2410B 毫米波雷达和 2.4 寸 ILI9341 触控屏，能够采集温度、湿度、TVOC、eCO2、光照、人体存在等数据，并在本地完成显示、告警、自动亮度调节、专注模式触发和专注环境评分。系统采用 FreeRTOS 双核任务调度，将界面渲染、传感器采集、网络通信、Web 控制、OTA 升级和本地智能决策解耦运行；通过两阶段启动、模块重试、离线运行、自动重连、静态缓冲区和 PSRAM 内存优化提升稳定性。通信层支持局域网 Web 控制、Captive Portal 配网、MQTT 数据上报与远程指令下发，并接入 Blinker 数据面板和 PushPlus/微信告警。后端基于 FastAPI、SQLAlchemy、MQTT 与 WebSocket 构建，提供用户认证、设备管理、数据存储、历史查询、远程控制、OTA 固件管理、实时推送和以规则引擎为主的 AI 环境分析接口，可选接入大模型生成个性化建议。前端 cube-tianmu 基于 Vue 3、TypeScript 与 Vite 构建，提供大众版、青少年版和老年版三套入口，并通过 ECharts 趋势图、Three.js 数字孪生模型、空气成分粒子舞台、小眠角色交互和 WebSocket 实时同步提升可视化表达与演示稳定性。作品突出“桌面环境健康 + 专注学习陪伴”的应用定位，兼顾低成本、可扩展、安全鉴权与可演示落地，形成了从感知层、传输层、平台层到应用层的完整物联网闭环。

关键词：智能桌面；环境监测；ESP32-S3；MQTT；FastAPI；Vue 3；数字孪生；专注模式；毫米波雷达；OTA 升级；AI 分析

目 录

# 第一章 设计需求分析

## 1.1 桌面环境健康监测需求

### 1.1.1 桌面场景下的环境不可见问题

宿舍、书房和办公桌面通常空间较小、人员停留时间长，通风、光照、温湿度和挥发性气体变化会直接影响学习效率与身体舒适度。普通用户很难持续感知 eCO2、TVOC、光照强度等指标，只能在闷热、异味或疲劳已经出现后被动处理，因此需要一种能够长期驻留桌面、低打扰地采集环境数据并及时提醒的终端。

### 1.1.2 传统桌面设备的功能局限

现有温湿度计或空气质量检测仪多以单点数据显示为主，缺少人体存在感知、专注时长记录、远程数据查看和告警联动。部分智能家居设备依赖手机 App 和云平台，在断网或配网失败时体验明显下降，也不适合竞赛演示中对本地可用性、可解释性和工程完整性的要求。

### 1.1.3 物联网作品的工程化需求

本作品不仅要完成传感器采集和屏幕展示，还需要解决设备身份认证、数据可靠上报、远程控制回执、OTA 固件升级、历史数据存储、实时可视化和异常告警等工程问题。因此系统设计目标是构建软硬件协同的闭环架构，使设备具备可部署、可维护、可扩展的物联网终端能力。

# 第二章 特色与创新

## 2.1 多维感知与场景化陪伴创新

### 2.1.1 环境数据与人体存在融合

作品将温湿度、TVOC、eCO2、光照强度与毫米波人体存在数据统一纳入桌面环境模型。相比只显示温湿度的传统设备，系统能够判断“人在桌前时的真实环境质量”，并将监测结果用于专注模式、休息提醒和告警推送，使环境监测从被动读数转为场景化服务。

### 2.1.2 专注模式闭环设计

LD2410B 雷达可在约 30 cm 桌面距离内检测人体存在。系统支持自动、手动和远程三种专注触发方式，进入专注后记录会话时长与环境均值，退出时按照 eCO2、温度、湿度权重生成 0-100 分专注环境评分，并在屏幕上给出总结，实现“感知-记录-评价-反馈”的闭环。

### 2.1.3 二次元角色“小眠”状态与菜单向导

作品在本地屏幕和前端视觉中打造了统一的二次元角色“小眠”交互体系。小眠不是单纯装饰，而是与 AQI、eCO2、TVOC、温湿度、毫米波就座检测和专注模式联动：环境舒适时呈现放松常态，指标轻微异常时进入提醒状态，空气质量严重异常时进入告警状态，用户专注时降低动效进行安静陪伴，专注结束或环境恢复后给出庆祝反馈。开机阶段采用小眠“苏醒”动画，1-2 秒内完成品牌露出和主界面过渡；菜单层面则用小眠替代传统入口，点击角色后呼出空气质量、环境、专注、设置等选项卡，兼顾状态提示、情感陪伴和操作向导。

## 2.2 高可用与本地智能创新

### 2.2.1 两阶段启动与故障隔离

硬件端采用两阶段启动策略：先初始化 LVGL 和启动界面，让用户约 1 秒内看到设备反馈；随后在后台任务中依次加载 BH1750、AHT21、ENS160、LD2410B 等模块。每个模块具备多次重试和故障标记机制，单个传感器异常不会阻塞整机启动，屏幕和本地控制仍可继续使用。

### 2.2.2 离线可用与自动重连

WiFi、MQTT、Blinker 和 Web 服务均采用非阻塞运行方式。网络异常时，设备继续执行采集、显示、专注计时、亮度调节和本地告警；网络恢复后自动重连并重新上报状态，避免“断网即不可用”的低可靠体验。

## 2.3 端云协同与可扩展创新

### 2.3.1 多入口远程交互

系统同时提供设备本地触控屏、局域网 Web 控制页、MQTT 后端通道、cube-tianmu 前端控制台、WebSocket 实时推送、Blinker 数据面板和 PushPlus/微信提醒。用户可通过设备热点或局域网网页进入控制页，也可通过云端前端查看历史数据、接收告警和下发当前实机已接入的控制指令；灯光、色温、蜂鸣器等控制项在前后端协议和界面中保留扩展入口，当前不作为已完成实机执行链路描述。

### 2.3.2 本地预测与云端分析结合

设备端基于历史环形缓冲进行 CO2 趋势线性回归，提前提示通风；同时在固件中部署轻量 PM2.5 预测数据模型，将部分推理留在本地完成。后端再基于多维传感器数据计算环境综合评分、风险预警、改善建议和周报，使终端低延迟响应与云端长期分析形成互补。

## 2.4 多版本前端与数字孪生可视化创新

### 2.4.1 分层用户入口设计

前端 cube-tianmu 针对不同使用人群设计了 /public 大众版、/teen 青少年版完整控制台和 /senior 老年版三套入口。大众版强调轻量查看与快速上手，青少年版面向学生学习、设备调试和答辩展示，提供设备、控制、AI 分析、日志等完整功能；老年版采用大字号、低密度信息和简化操作，降低理解和操作成本。三套入口共用认证、设备数据和 WebSocket 状态同步，并结合模糊上浮入场、悬浮式卡片、页面过渡和状态加载动画，使不同人群进入系统时都能获得更直观、连续的交互反馈。

### 2.4.2 数字孪生与空气粒子表达

控制台引入 Three.js GLB 魔方模型、轻量硬件状态屏和 Canvas 空气成分粒子舞台，将 eCO2、TVOC、PM2.5、湿度、光照等抽象数据转化为可观察的视觉状态。粒子舞台会根据空气数据动态调整粒子类别、数量和颜色，并通过帧率限制、DPR 限制、IntersectionObserver 暂停和组件卸载清理控制资源占用，使前端既有展示辨识度，也能维持较好的运行性能。

# 第三章 功能设计

## 3.1 环境感知与数据采集功能

### 3.1.1 多维度环境数据采集

设备通过 AHT21 获取温湿度，通过 ENS160 获取 TVOC、eCO2 与空气质量相关指标，通过 BH1750 获取光照强度，通过 LD2410B 获取人体存在与距离信息。采集结果统一写入全局数据池，供屏幕显示、Web 控制页、MQTT 上报、本地智能决策和专注模式共同使用。

温湿度数据用于舒适度判断、专注环境评分和历史趋势展示。

光照数据用于屏幕背光自适应调节，降低夜间刺眼和强光下看不清的问题。

空气质量数据用于 eCO2、TVOC、AQI、PM2.5 预测与异常提醒。

### 3.1.2 数据预处理与稳定输出

系统对传感器异常值进行过滤，并在模块未就绪时使用状态标记避免错误数据污染历史缓存。历史数据以环形缓冲方式保存，支持趋势预测和局域网网页查询，后端则持久化保存上报数据用于历史曲线和周报分析。

## 3.2 本地交互与控制功能

### 3.2.1 触控显示与状态反馈

2.4 寸 TFT 触控屏采用 LVGL 构建启动页、主界面、空气质量页、环境页、专注页、设置页和锁屏页。界面实时显示温湿度、光照、空气质量、网络状态、人体存在、专注时长和 OTA 状态，异常时通过角色状态、提示弹窗和状态点进行反馈。

### 3.2.2 局域网 Web 控制页

设备内置 WebServer，可提供实时数据接口、历史数据接口、控制接口、WiFi 扫描与连接接口、OTA 检测和确认接口。用户连接设备热点或同一局域网后即可通过浏览器完成配网、专注模式切换、自动亮度开关、免打扰开关和固件升级确认。

### 3.2.3 移动端提醒与远程查看

设备通过 Blinker 直连协议推送温度、湿度、eCO2、PM2.5、光照、TVOC 等数据控件，并通过 PushPlus 接口发送微信告警。Blinker 端灯光按钮相关函数已保留但当前返回为空实现，告警推送设置冷却时间，避免同一异常连续推送造成打扰。

## 3.3 专注模式与智能提醒功能

专注模式可由雷达自动触发、屏幕/网页手动触发或后端远程触发。系统检测到人体持续存在超过阈值后进入专注状态，切换专注界面并开始计时；检测到离开超过设定时间后自动退出，手动退出后设置冷却时间，避免短时间内反复自动进入。

专注期间系统每 5 秒累积温度、湿度和 eCO2 数据。退出时计算平均值，并按照 eCO2 40%、温度 35%、湿度 25% 的权重生成专注环境评分，同时显示专注时长、均值和等级，帮助用户理解本次学习环境质量。

系统使用最近 30 分钟的 eCO2 历史点进行最小二乘线性回归，当预测到 CO2 将在一定时间内达到通风阈值时，在专注页面显示提前通风建议，实现从事后告警到事前提醒的改进。

专注期间若 eCO2、温度或湿度超过设定阈值，设备会弹出休息或通风建议，并设置 3 分钟冷却期，保证提醒有效但不过度打扰。

## 3.4 网络通信与远程功能

### 3.4.1 配网与离线运行

设备启动 SoftAP 与 Captive Portal，用户连接 CubeLight 热点后可自动跳转到配网页面，扫描附近 WiFi 并写入 NVS 持久化保存。已保存网络可在重启后自动连接；网络不可用时，核心本地功能保持运行。

### 3.4.2 数据上报与指令接收

设备通过 MQTT 向后端发送握手、心跳、数据上报、版本检查和控制 ACK。后端返回临时设备 Token，后续心跳、数据和控制回执均使用 Token 校验，保证设备身份和数据归属。

后端当前实机主线已支持设备锁、专注模式控制、OTA 更新推送与执行结果 ACK；局域网 Web 控制页支持专注模式、自动进入专注、自动亮度、免打扰和屏幕亮度调节。后端协议中保留灯光、色温、灯光亮度、微信通知开关等控制项，但其中灯光、色温、蜂鸣器等硬件执行链路尚未接入当前 MQTT 实机主流程，作为后续扩展能力处理。

### 3.4.3 OTA 固件升级

后端支持管理员上传固件、计算 MD5、生成下载地址并通过 MQTT 向单台或全部在线设备推送更新。设备端收到新版本后先提示用户确认，再通过 HTTPS/HTTP 流式下载、写入 Flash、校验 MD5、重启并回传 ACK，便于比赛演示和后续维护。

### 3.4.4 前端实时同步与演示模式

前端通过 WebSocket 订阅传感器数据、设备心跳、控制结果和告警消息，连接时携带最新 Token，连接建立前的订阅消息进入队列，异常断开后按指数退避自动重连。演示模式会拦截部分 API 并模拟 WebSocket 数据流，用于比赛答辩、无硬件环境展示和前端界面检查。

## 3.5 安全防护与系统管理功能

### 3.5.1 用户与设备双重鉴权

用户侧采用 JWT 登录鉴权和管理员权限校验；设备侧采用握手生成的临时 Token 校验心跳、数据上报、指令拉取和 ACK。后端区分普通用户与管理员，支持设备绑定、解绑、重命名和管理员设备管理。

### 3.5.2 告警、日志与数据管理

后端对 TVOC、eCO2、霉菌风险等指标进行阈值检测，并通过 WebSocket 推送告警；同时保存传感器数据、操作日志、语音日志和 OTA 日志。演示脚本可生成账号、设备、七天历史数据和典型异常样本，便于稳定展示。

### 3.5.3 低功耗与舒适体验

系统支持 22:00-08:00 免打扰、光照驱动的屏幕亮度调节和本地舒适度判断。通过减少动态内存分配、采用静态缓冲区和 PSRAM 承载大块内存，降低长时间运行中的内存碎片风险。

# 第四章 系统实现

## 4.1 感知层技术实现

### 4.1.1 硬件平台与传感器配置

系统硬件以 ESP32-S3 DevKitM-1 为主控，基于 PlatformIO + Arduino 框架开发，使用 8MB 分区配置和 PSRAM 支持。主要外设包括 ILI9341 触控显示屏、AHT21 温湿度传感器、ENS160 空气质量传感器、BH1750 光照传感器和 LD2410B 毫米波雷达。

ESP32-S3 负责传感器采集、屏幕渲染、WiFi/MQTT 通信、局域网 Web 服务和 OTA 升级。

AHT21、ENS160、BH1750 分别通过 I2C 接入，LD2410B 通过 UART 接入，屏幕与触控分别通过 SPI/触控接口驱动。

设备外设采用模块化初始化和状态标记，便于在单个模块异常时继续运行主流程。

### 4.1.2 数据采集与预处理实现

传感器数据采集由独立 FreeRTOS 任务执行，结果写入 SensorData、DeviceStatus、SensorHistory 等共享数据结构。系统通过互斥锁保护关键数据读写，通过历史环形缓冲支持网页历史曲线和本地趋势预测。

## 4.2 传输层技术实现

### 4.2.1 通信协议与主题设计

设备与后端主要通过 MQTT 3.1.1 通信，Topic 以 cube2026 为前缀区分公共 Broker 上的消息空间，包含设备状态、数据上报、ACK 和服务端控制等主题。后端基于 aiomqtt 异步客户端订阅消息，硬件端基于 PubSubClient 发送与接收 JSON 数据。

局域网交互采用设备内置 HTTP 服务，提供 /api/data、/api/history、/api/control、/api/wifi/scan、/api/wifi/connect 等接口；云端平台采用 FastAPI REST 接口和 WebSocket 连接，前端通过订阅设备实时刷新数据。

### 4.2.2 非阻塞联网与重连机制

网络任务独立运行在 Core 0，应用层、采集层和界面层主要运行在 Core 1。MQTT 连接、心跳、Blinker 推送和 Web 服务均避免阻塞主显示流程；断网时跳过云端发送并保留本地功能，恢复后重新认证、重连和同步状态。

## 4.3 控制层技术实现

### 4.3.1 FreeRTOS 双核任务划分

系统在 setup 中创建多个固定任务：LVGL 界面任务负责显示和触控，DataRead 负责数据采集，RealtimeCtrl 负责本地控制，FocusReport 负责专注相关处理，OTA 任务负责固件更新，WiFi/MQTT/Web 任务负责网络通信。双核划分降低了联网波动对用户界面和传感器采集的影响。

### 4.3.2 两阶段启动流程

第一阶段立即初始化串口、显示驱动、LVGL 和启动界面；第二阶段通过后台 ModuleLoad 任务加载传感器和雷达。启动页显示当前加载进度，全部模块完成后切换主界面。该设计显著降低用户等待感，也便于定位模块初始化失败。

### 4.3.3 本地智能决策实现

LocalIntelligence 任务每 5 秒执行一次，依次处理免打扰模式、自动亮度、空气质量告警、温湿度舒适度告警、专注会话采样、休息建议、CO2 趋势预测和历史数据记录。PM2.5 预测模型数据以头文件形式保存在固件中，推理过程不依赖网络。

### 4.3.4 稳定性与内存管理

系统通过 PSRAM、静态缓冲区、snprintf 和任务分工降低内存碎片风险；OTA 下载期间暂停部分网络任务，避免网络栈、TLS/HTTP 下载与 MQTT 发送同时争用资源。关键状态通过共享字段与 UI 渲染线程通信，保证升级进度和异常提示可见。

## 4.4 软件开发与平台实现

### 4.4.1 开发环境与主要技术栈

硬件端使用 PlatformIO、Arduino、FreeRTOS、LVGL、PubSubClient、ArduinoJson、Adafruit AHTX0、DFRobot ENS160、BH1750、MyLD2410、Adafruit ILI9341 等库；Yeelight/蓝牙灯控制模块作为预留扩展代码保留，当前未纳入主初始化流程和 MQTT 实机控制链路。后端使用 FastAPI、SQLAlchemy、aiosqlite、python-jose、bcrypt、aiomqtt、WebSocket 和 httpx，形成异步 API 服务。

### 4.4.2 后端服务实现

后端提供 /api/v1/auth、/device、/data、/control、/log、/admin、/ai、/chat、/ota 等接口。核心能力包括用户注册登录、JWT 鉴权、设备握手绑定、传感器数据上传、最新/历史数据查询、远程控制、控制 ACK、操作日志、语音日志、管理员统计、AI 分析和 OTA 固件管理；管理员后台接口与页面文件已保留，当前不作为 MVP 演示主入口。

数据库模型包括用户、设备、传感器数据、操作日志、语音日志和 OTA 日志。设备状态、固件版本、设备 Token、绑定用户和最近心跳均可持久化记录，便于后台管理和演示复盘。

WebSocket 管理器支持认证、设备订阅、心跳和广播，可向订阅客户端推送 sensor_data、device_status、device_heartbeat、control_result、alert 等消息，减少前端轮询压力。

### 4.4.3 前端工程实现

前端 cube-tianmu 采用 Vue 3、TypeScript、Vite、Pinia、Vue Router、Element Plus、ECharts、Three.js、Konva 等技术实现。路由层采用懒加载组织 /public、/senior 和 /teen 页面，导航守卫支持登录态校验与演示模式放行；useWebSocket 组合式函数统一处理地址解析、Token 认证、消息分发、订阅队列、自动重连和退出清理。Dashboard 页面使用按需加载的 ECharts 展示趋势数据，并通过数字孪生模型、空气粒子舞台和设备状态卡把硬件状态可视化。界面层实现了 BlurReveal 模糊上浮加载、LiquidGlass 悬浮玻璃面板、page-load 页面过渡、fade-up-blur 卡片入场、数字孪生飞行动画、二次元角色“小眠”浮动反馈和可展开的小眠聊天入口，使数据加载、页面切换和控制状态变化不再只是静态刷新，而是形成更具连续性的动态体验。

为降低首屏体积，前端将 Element Plus 延迟到 /teen 路由加载，ECharts 只在图表初始化时动态导入，Three.js、ECharts、Element Plus 等依赖通过 Vite manual chunks 拆分；较大的 GLB 模型和启动动画放在 public 静态目录引用。AI 分析页已接入环境评分、风险预警、智能建议和周报接口，PDF 导出按钮当前提示功能开发中，因此不计入已完成核心功能。

## 4.5 OTA 远程固件升级实现

OTA 链路包括固件上传、版本检查、MQTT 推送、用户确认、固件下载、MD5 校验、Flash 写入、重启和 ACK 回传。后端从 data/firmware 目录维护固件文件并生成 URL，设备端以独立 OTA 任务执行下载和升级，升级过程在本地 Web 页和屏幕上显示状态。实机联调已验证 ESP32-S3 能完成版本检查、下载校验、烧录重启和结果回传。

## 4.6 云应用与数据分析实现

### 4.6.1 数据可视化与远程管理

cube-tianmu 前端面向用户提供设备列表、实时数据、历史趋势、远程控制、AI 分析和日志中心，趋势图使用后端分桶聚合结果并支持 1H、6H、24H、7D 等时间范围切换；面向管理员的用户、设备和统计页面文件已保留，当前处于开发完善阶段。系统内置演示模式，可在没有完整硬件或公网环境时提供稳定样本数据，保证答辩展示过程可控。

### 4.6.2 AI 分析与智能建议

后端 AI 接口以规则引擎为基础计算环境综合评分：温度、湿度、空气质量和舒适度按权重汇总，并输出优秀、良好、一般、较差等级；风险接口根据 eCO2、TVOC、AQI、湿度、温度、霉菌风险等指标生成分级预警。建议接口默认使用规则建议，在配置 LLM_MODE、LLM_API_KEY、LLM_API_BASE_URL、LLM_API_MODEL 等环境变量后，可选调用通义千问或本地 Ollama 模型生成个性化改善建议；未配置时系统自动回退到规则结果。

周报接口按天汇总历史数据，输出近七天温湿度、空气质量等趋势，帮助用户观察桌面环境变化。小眠聊天接口通过 SSE 流式返回文本，可把设备实时数据注入上下文；前端控制台提供可展开的聊天面板，用“小眠”角色身份回答设备状态、环境指标和使用建议等问题。该能力依赖后端 LLM 配置，未配置时会提示需要配置模型参数。

端侧与云端共同完成实时响应和长期分析：端侧负责低延迟提示、离线可用和专注陪伴，后端负责跨设备管理、历史存储、实时推送、统计分析和固件维护。

# 第五章 其他内容

## 5.1 作品结构方案与样机形态

### 5.1.1 样机结构布局方案

当前作品处于功能样机阶段，重点完成主控、传感器、触控屏、网络通信和后端平台的联调验证。外壳尚未进行最终制作，因此本文不将外壳作为已完成成果描述。结构设计方案上，作品计划采用桌面立方体外形，主控、电源、传感器与显示模块按分区方式布置，传感器区域避开屏幕背光和主控发热位置，并预留散热孔、走线空间和后续 3D 打印装配位。

### 5.1.2 人机交互与样机体验

当前样机的人机交互主要由 2.4 寸触控屏、局域网 Web 控制页和移动端告警共同完成。屏幕界面采用二次元角色“小眠”的状态与数据仪表结合的方式表达设备状态，normal、remind、alert、focus、celebrate 等角色图像分别对应环境正常、普通提醒、严重告警、专注陪伴和任务完成反馈；boot_sleep 动画用于小眠开机“苏醒”流程。小眠固定在屏幕角落，不遮挡核心数据，并可作为菜单向导呼出空气质量、环境、专注、设置等选项，形成“状态提示 + 情感陪伴 + 操作引导”的交互闭环。后续外壳制作完成后，将进一步优化屏幕开孔、触控角度、传感器进气位置和整体握持/摆放体验。

## 5.2 成本核算与性价比分析

### 5.2.1 硬件成本明细

作品优先选用开源生态成熟、资料丰富且价格适中的模块，当前核心电子硬件成本约 114 元，成本明细见表。该成本不包含外壳加工、3D 打印材料、螺丝铜柱、备件损耗和调试工具；外壳将在后续样机完善阶段单独核算。

模块 | 型号 / 规格 | 单价（元）
主控板 | ESP32-S3 DevKitM-1 | 31
传感器模块 | AHT21、ENS160、BH1750、LD2410B | 42
显示模块 | 2.4 寸 ILI9341 TFT 触控屏 | 26
电源与配件 | 杜邦线、电源模块、连接器、临时固定配件 | 15
合计 | | 114

### 5.2.2 成本控制与性价比优势

相较商用空气质量检测仪和桌面智能屏，本作品在较低硬件成本下实现了多维环境采集、人体存在感知、专注陪伴、局域网控制、云端管理和 OTA 升级，适合教学、竞赛展示和小规模场景化应用。

## 5.3 作品推广价值与应用展望

### 5.3.1 应用场景拓展

作品可应用于学生宿舍、图书馆自习位、家庭书房、办公室工位和实验室环境角等场景。通过修改阈值、传感器组合和外壳结构，也可扩展为教室空气质量节点、办公区环境看板或多设备分布式监测系统。

### 5.3.2 后续优化方向

后续计划包括完成外壳建模与制作、优化散热和装配结构、完善多设备统一管理、提升告警策略可配置性、增加电池与低功耗休眠、强化 MQTT/TLS 安全配置、正式接入灯光/蜂鸣器等预留控制接口、接入更多传感器，并将 AI 建议从规则为主逐步扩展为规则与大模型协同。

# 第六章 参考文献

[1] Espressif Systems. ESP32-S3 Series Datasheet[EB/OL]. Espressif Systems, 2024.

[2] OASIS. MQTT Version 3.1.1 Plus Errata 01[S]. OASIS Standard, 2015.

[3] LVGL Kft. LVGL Documentation v8.3[EB/OL]. LVGL, 2024.

[4] FreeRTOS. FreeRTOS Kernel Developer Documentation[EB/OL]. Amazon Web Services, 2024.

[5] DFRobot. ENS160 Air Quality Sensor Wiki[EB/OL]. DFRobot, 2023.

[6] Aosong Electronics. AHT21 Integrated Temperature and Humidity Sensor Datasheet[EB/OL]. Aosong, 2023.

[7] ROHM Semiconductor. BH1750FVI Digital 16bit Serial Output Type Ambient Light Sensor IC Datasheet[EB/OL]. ROHM, 2011.

[8] Hi-Link. LD2410B Human Presence Radar Module Manual[EB/OL]. Hi-Link, 2023.

[9] Sebastián Ramírez. FastAPI Documentation[EB/OL]. FastAPI, 2024.

[10] SQLAlchemy Authors. SQLAlchemy 2.0 Documentation[EB/OL]. SQLAlchemy, 2024.

[11] Vue.js. Vue 3 Documentation[EB/OL]. Vue.js, 2026.

[12] Vite Team. Vite Documentation[EB/OL]. Vite, 2026.

[13] Apache Software Foundation. Apache ECharts Documentation[EB/OL]. Apache ECharts, 2026.

[14] Three.js Authors. Three.js Documentation[EB/OL]. Three.js, 2026.

全国大学生物联网设计竞赛设计文档[智能桌面魔方]
