tianchuangya/SmartDesktopCube-IoT/作品提交/2026年全国大学生物联网设计竞设计文档_before_update.docx

全国大学生物联网设计竞赛

智能桌面魔方

学校名称： | 宁波工程学院
团队名称： | 天幕智创
队长： | 钱泽琳
队员1： | 缪卓珲
队员2： | 许俊翔
队员3：

全国大学生物联网设计竞赛组委会

2020年7月

智能桌面魔方

# 摘要

本设计面向校园与居家桌面场景，提出一款集环境监测、智能交互、远程管控、AI 分析于一体的物联网智能终端方案。设备以 ESP32-S3 为核心，实现温湿度、光照、空气质量、人体存在多维度数据采集，搭配触控显示与远程微信告警功能。系统采用非阻塞联网、模块化架构、故障隔离与表驱动编程，支持离线运行与自动重连、Captive Portal 网页配网、OTA 远程固件升级与 Blinker App 云平台集成。后端提供数据可视化、AI 健康建议、远程配置及微信告警服务，通信采用 MQTT 协议（公共 Broker）与 HTTPS 接口加密，并通过 JWT + 设备 Token 鉴权、限流封禁、Flash 加密等机制保障安全。作品功能完整、架构规范、实用性强，可直接落地部署。

关键词：智能桌面；环境监测；物联网；ESP32-S3；MQTT 加密；AI 分析；毫米波雷达；Captive Portal；OTA 升级

目 录

# 第1章 设计需求分析

（本章节主要描述面向什么需求设计了本作品，本作品主要解决了什么问题，或对什么现有产品或应用作出了改进等）

## 1.1 桌面环境智能监测与交互的现实需求

### 1.1.1 传统桌面监测设备的功能局限性

当前市场上的桌面环境监测设备普遍存在功能单一、场景适配性差的问题：多数产品仅支持温湿度基础监测，缺少空气质量、光照强度等多维度数据采集；且普遍依赖屏幕单一展示方式，缺乏远程通知、智能提醒等多通道交互能力，无法满足用户对健康环境感知与智能提醒的需求。

### 1.1.2 现有设备在智能联动与自动化上的不足

传统监测设备多为 “数据展示工具”，缺乏与家电设备的联动控制能力，无法根据环境参数自动调节空调、灯具等设备；同时多数产品依赖手机 APP 操作，缺少本地触控、离线运行、自动重连等高可用设计，网络异常时设备易陷入瘫痪状态，影响用户体验。

### 1.1.3 物联网终端的安全与工程化短板

市面低成本物联网设备普遍存在安全防护薄弱问题：通信未加密、身份无校验、数据易被篡改；同时代码架构松散，缺少模块化设计、故障隔离、表驱动编程等工程化实现，后期维护与扩展难度大，不符合竞赛对项目规范性与安全性的要求。

# 第2章 特色与创新

（本章节主要描述作品与现有其他技术或应用相比所产生的优势和创新点）

## 2.1 多维度环境感知与一体化交互创新

### 2.1.1 复合式环境监测方案

本作品突破传统桌面设备单一温湿度监测的局限，集成温湿度、光照、空气质量三类传感器，实现桌面环境的全维度感知。其中，ENS160 空气质量传感器可精准识别有害气体浓度，弥补了市面同类产品在室内健康监测上的空白，为用户提供更全面的环境健康参考。

### 2.1.2 多通道融合交互设计

作品构建了 “本地触控显示 + 微信告警推送” 的交互体系，相比传统设备仅依赖屏幕显示的单一交互方式，用户可通过屏幕可视化与微信远程通知等多种渠道获取信息，交互体验更直观、更及时，适配学习、工作等多种场景需求。

## 2.2 工程化架构与高可用设计创新

### 2.2.1 模块化代码与表驱动编程架构

硬件端采用分文件模块化开发，将显示、传感器、网络、安全等功能独立封装，实现故障隔离；同时通过表驱动命令管理模式，新增功能仅需修改配置表，无需改动主流程，相比传统线性代码，大幅提升了系统的可维护性与扩展性，符合工业级开发规范。

### 2.2.2 非阻塞异步联网与离线运行机制

系统采用非阻塞 WiFi+MQTT 架构，断网时自动进入离线模式，本地数据采集、显示功能不受影响；每 5 秒自动尝试重连（MQTT），网络状态实时显示在屏幕上，解决了传统物联网设备 “断网即瘫痪” 的痛点，大幅提升了设备的可用性与稳定性。

## 2.3 全链路安全防护与场景化优化创新

### 2.3.1 多重安全防护体系

作品在通信层采用 MQTT 协议（公共 Broker）与 HTTPS 接口加密（用于 Blinker 认证与 OTA 下载），身份验证采用用户端 JWT 令牌 + 设备端 MQTT 临时 Token 双重校验（JWT 基于 HS256 签名，设备 Token 由服务器通过 MQTT 握手动态下发），同时结合限流封禁、Flash 加密、安全启动等机制，相比普通物联网设备的明文传输与弱身份验证，安全性提升显著，有效防范数据篡改与恶意攻击。

### 2.3.2 场景化智能联动与低功耗优化

针对桌面学习场景，设计了专注模式与日常模式双系统，专注期间实时记录环境数据并生成质量评分（0-100 分），同时基于线性回归预测 CO₂ 变化趋势、提前建议通风休息；此外实现屏幕亮度自适应、夜间免打扰与低功耗模式，兼顾了使用体验与能耗控制，相比通用型设备更贴合校园与居家桌面的实际使用场景。

# 第3章 功能设计

（本章节主要描述作品根据需求分析所规划设计的各种功能，着重体现这些功能的作用）

## 3.1 环境感知与数据采集功能

### 3.1.1 多维度环境数据采集

设备搭载 ENS160+AHT21 温湿度空气质量组合传感器、BH1750 光照传感器，实现桌面环境的多维度数据采集：

- 温湿度：实时监测室内温湿度，为舒适度评估与环境联动提供依据
- 光照强度：采集环境亮度数据，用于屏幕亮度自适应调节
- 空气质量：监测有害气体浓度并完成等级判定，为健康预警提供支撑

### 3.1.2 数据预处理与稳定输出

通过均值滤波、限幅滤波算法对采集数据进行处理，去除噪声与突变值，保证数据稳定可靠，为后续的显示、分析与控制功能提供高质量数据支撑。

## 3.2 地交互与控制功能

### 3.2.1 触控显示与状态反馈

搭载 2.4 寸触控 TFT 显示屏，实现多页面数据可视化展示，支持日常模式 / 专注模式切换，网络离线时持续显示本地数据，WiFi/MQTT 状态指示点变红提示网络异常。

### 3.2.2 灯光提示与语音播报（规划功能）

硬件预留 WS2812 氛围灯接口与 DFPlayer Mini 语音模块接口，规划在后续版本中实现灯光状态提示与本地语音播报功能。

### 3.2.3 红外家电自动控制（规划功能）

根据预设温湿度阈值，规划通过红外发射模块自动控制空调等家电设备启停，实现桌面环境温度的自动化调节。该功能将在后续版本中实现。

## 专注模式与人体感知功能

集成 LD2410B 毫米波雷达模块，实现无感人体存在检测（硬件检测范围 0.75-6 米，默认有效距离 60cm（可配置））。基于雷达数据实现专注模式自动触发：当检测到人体持续存在超过阈值时，设备自动进入专注模式，屏幕切换专注界面、计时器启动、环境传感器持续监测。用户离开后超时自动退出，全程无需手动操作，实现感知-决策-执行完整闭环。专注模式支持自动、手动、远程三种触发方式，可配置雷达灵敏度、检测距离、离开超时等参数。

专注会话环境记录：进入专注模式后，系统每 5 秒采样一次温度、湿度、CO₂ 数据并累积统计。退出专注时自动计算会话期间的平均值，并基于加权评分算法生成专注质量评分（0-100 分），评分权重为 CO₂ 浓度 40%、温度舒适度 35%、湿度适宜度 25%，以半透明面板形式展示专注时长、环境均值与评分等级（Excellent/Good/Fair/Improve），帮助用户量化学习环境质量。

CO₂ 趋势预测与智能提醒：利用最近 30 分钟的传感器历史数据（6 个采样点 × 5 分钟间隔），通过最小二乘法线性回归预测 CO₂ 浓度变化趋势。当预测到 CO₂ 将在一定时间内超过 1000ppm 通风阈值时，在专注界面实时显示 'CO2 rising ~25min to ventilate' 等预测性提示，实现从'事后告警'到'事前预警'的升级。

专注期间智能休息建议：专注模式运行中，系统每 5 秒检测环境参数，当 CO₂ > 1200ppm、温度 > 28°C 或湿度 > 75% 时，通过顶部半透明弹窗建议用户适当休息通风以提升学习效率，同类建议设有 3 分钟冷却期避免频繁打扰。

## 3.3 网络通信与远程功能

### 3.3.1 非阻塞联网与离线运行

采用非阻塞 WiFi+MQTT 架构，设备可在联网过程中继续运行本地功能；断网时自动进入离线模式，本地数据采集、显示、控制功能不受影响，网络恢复后自动同步数据。

### 3.3.2 数据上传与指令接收

设备端 Web 控制页通过 mDNS 协议注册 cube.local 域名，用户在同一局域网内可通过 http://cube.local/ 直接访问设备控制页面，无需记忆设备 IP 地址。控制页面支持实时数据展示、WiFi 配网、OTA 更新确认、专注模式切换等全部操作。

通过 MQTT 协议（公共 EMQX Broker），将环境数据上传至后端服务器；同时接收后端下发的控制指令与配置数据，实现远程管控与交互联动。

### 3.3.3 微信告警与远程通知

当环境参数超标、传感器故障或网络异常时，设备主动上报事件，设备端通过 Blinker 云平台 HTTP 接口向用户微信推送告警消息，实现异常情况的远程实时提醒。

## Captive Portal 配网与云平台集成

设备开启 CubeLight WiFi 热点后，手机连接即自动弹出控制网页（Captive Portal），无需安装 App 即可进行 WiFi 配网：扫描附近 WiFi、选择网络、输入密码并连接，凭据持久化存储于 NVS（Preferences 库），重启后自动连接。同时集成 Blinker App 云平台，通过直连 Blinker MQTT 协议（不依赖 Blinker 库）实现 6 个上行数据控件（温度、湿度、eCO2、PM2.5、光照、TVOC）的实时推送（2 秒间隔合并发送），灯光控制通过设备端 Web 管理面板或 MQTT 指令实现。当环境参数超过报警阈值时，通过 Blinker HTTP API 向用户推送微信告警通知，报警冷却 2 分钟避免消息轰炸。

## 3.4 安全防护与系统管理功能

### 3.4.1 身份鉴权与通信加密

采用用户端 JWT 令牌 + 设备端 MQTT 临时 Token 双重身份校验，MQTT 通信采用公共 Broker 传输，HTTPS 用于 Blinker 认证与 OTA 固件下载，防止数据被篡改与非法访问，保障设备与数据安全。

### 3.4.2 硬件自检与故障隔离

设备开机时自动检测传感器、屏幕、雷达、网络等模块状态，任一模块故障时不影响整机运行，并通过交叉告警方式提示用户，实现故障隔离与高可用运行。

### 3.4.3 低功耗与自适应管理

支持夜间免打扰模式（22:00-08:00 自动抑制告警）、屏幕亮度自适应调节（BH1750 光照传感器线性插值，100-500 lux 区间动态调节背光亮度），以及温湿度舒适度综合评估（含闷热、湿冷等复合效应判断），根据环境光照、运行模式、时段动态调整设备策略，兼顾使用体验与能耗控制。

# 第4章 系统实现

（本章节主要描述实现功能所采用物联网技术架构，包括感知层技术、传输层技术、控制层技术、软件开发技术、云应用、数据挖掘和可视化应用等。）

## 4.1 感知层技术实现

### 4.1.1 硬件平台与传感器配置

系统以 ESP32-S3 为主控单元，搭载多类传感器与交互模块：

- 核心控制：ESP32-S3 开发板，集成 WiFi 与蓝牙功能，支持 Arduino 开发环境
- 环境感知：ENS160+AHT21 温湿度空气质量组合传感器、BH1750 光照传感器、LD2410B 毫米波雷达
- 交互模块：2.4 寸 ILI9341 TFT 触控显示屏（XPT2046 电阻触控）

### 4.1.2 数据采集与预处理实现

传感器通过 I2C、UART 等接口与主控通信，实现环境数据的实时采集；通过均值滤波与限幅滤波算法对原始数据进行去噪处理，消除数据抖动与异常值，保证数据的稳定性与可靠性。

## 4.2 传输层技术实现

### 4.2.1 通信协议与公共Broker实现

- 采用 WiFi 无线通信方式接入网络，通过 MQTT 3.1.1 协议（公共 EMQX Broker）实现设备与后端的双向数据传输，通过 JWT + 设备 Token 双重鉴权保障数据归属
- 设备的 HTTPS 接口调用（Blinker 认证、OTA 固件下载）采用加密传输，结合 JWT 用户令牌与设备临时 Token 双重身份校验，防止数据篡改与非法访问

### 4.2.2 非阻塞联网与离线机制实现

采用非阻塞式 WiFi 连接与 MQTT 客户端设计，联网过程中设备可继续运行本地功能；断网时自动进入离线模式，本地数据采集与显示功能不受影响，网络恢复后自动重连并同步数据。

## 4.3 控制层技术实现

### 4.3.1 模块化软件架构设计

硬件端采用分文件模块化开发，将显示模块、传感器模块、网络模块、安全模块等功能独立封装，实现功能解耦与故障隔离；通过表驱动命令管理模式，统一处理本地触控、远程指令、雷达感知等命令，提升系统可维护性与扩展性。

### 两阶段启动流程实现

### 本地智能决策与趋势预测实现；此外，设备端部署 LightGBM 回归树模型（1000 棵决策树，4 维特征输入），基于温湿度、CO₂、TVOC 数据本地推理 PM2.5 浓度预测，推理全程在 Flash（PROGMEM）中完成，无需网络请求

系统采用两阶段初始化策略：Phase 1（快速显示，约 1 秒）：Serial 初始化、LVGL 图形库、触摸屏、UI 界面框架加载，开机画面即时渲染（角色睡眠静态图 + 加载进度文字）。Phase 2（后台模块加载）：在 Core 1 独立任务中依次初始化 BH1750（I2C 总线 0）、AHT21（I2C 总线 1）、ENS160（I2C 总线 1，地址 0x53/0x52 自动探测）、LD2410B（UART），每个模块 5 次重试配合 I2C 总线恢复机制，全部就绪后以 500ms 淡入动画过渡到主界面。

系统采用两阶段初始化策略，将用户感知启动时间从 12 秒缩短至约 1 秒。Phase 1（快速显示，约 1 秒）：Serial 初始化、LVGL 图形库、触摸屏、UI 界面框架立即加载，启动画面即时渲染（纯黑背景 + 虚拟 IP 角色 + 白色状态文字）。Phase 2（后台模块加载，2-12 秒）：在 Core 1 独立 FreeRTOS 任务中依次初始化 BH1750 → AHT21 → ENS160 → LD2410B 传感器，每模块最多 5 次重试（含 I²C 总线恢复），实时显示加载模块名称与进度。LVGL 定时器每 500ms 轮询 modules_ready 标志，全部完成后淡入主界面。任何模块加载失败不阻塞启动，故障模块通过交叉告警方式提示用户。

### 4.3.2 系统调度与故障隔离实现

采用非阻塞异步调度机制，保证传感器采集、屏幕刷新、网络通信、雷达检测等任务互不阻塞；开机时自动执行硬件自检，任一模块故障时不影响整机运行，并通过交叉告警方式提示用户，实现故障隔离与高可用运行。

针对长时间运行场景下的内存碎片化问题，系统设计了三层防护机制：第一，启用 ESP32-S3 的 8MB PSRAM，通过 ESP-IDF 分配器自动将大块内存分配（TLS 缓冲区、WiFi 协议栈等）迁移至 PSRAM，释放内部 SRAM 空间；第二，在高频热循环（每秒 MQTT 数据上报、Blinker 推送）中采用静态缓冲区 + snprintf 替代 ArduinoJson 动态分配，实现热循环零堆分配，从源头消除碎片产生；第三，每 2 分钟执行一次堆碎片整理（heap defragmentation），通过渐进式 realloc（16KB→512B）触发分配器空闲块合并，确保设备 7×24 小时运行后仍具备足够的连续内存空间用于 TLS 握手与 MQTT 通信。

## 4.4 软件开发与实现环境

### 4.4.1 开发环境与语言

硬件端基于 PlatformIO + Arduino 框架开发，采用 C/C++ 语言编写程序，FreeRTOS 双核调度，通过各类第三方库实现传感器驱动、屏幕显示、网络通信等功能；后端采用 Python FastAPI 异步框架开发，数据存储使用 SQLite + aiosqlite 异步驱动，MQTT Broker 使用 EMQX 服务，集成 WebSocket 实时推送、OTA 固件管理、AI 环境评分与建议等后端服务模块；可选接入阿里云通义千问大模型（qwen3.6-flash）或本地 Ollama 模型提供 AI 智能建议。

### 4.4.2 关键技术库与工具

硬件库：Adafruit ILI9341 显示库、Adafruit AHTX0 传感器库、DFRobot ENS160 空气质量库、LD2410 雷达驱动库、PubSubClient MQTT 库、ArduinoJson 序列化库

安全库：WiFiClientSecure 库（基于 mbedTLS），实现 HTTPS 加密通信；PubSubClient MQTT 库；DNSServer 库实现 Captive Portal；Preferences 库实现 NVS 持久化存储

开发工具：串口调试助手、MQTT 客户端测试工具、Blinker IoT 云平台

## OTA 远程固件升级实现

采用云端推送+用户确认+安全下载+自动校验四步流程实现 OTA 远程固件升级。设备通过 MQTT 上报当前版本号，后端比对后下发更新信息（URL、版本号、MD5），用户在 http://cube.local/ 网页端手动确认后触发下载。OTA 任务运行在 Core 1 独立 FreeRTOS 任务中（栈空间 16KB），通过 WiFiClientSecure 进行 HTTPS 流式下载（4KB 静态缓冲区），下载期间暂停 MQTT、Blinker 等所有网络任务，避免 ESP32-S3 硬件 SHA 加速器跨核争用导致崩溃。下载完成后通过 Update 库写入 Flash、MD5 校验、自动重启，全程通过 status 共享字段与 LVGL 渲染线程通信（线程安全），OTA 界面实时显示下载进度百分比。

## 4.5 云应用与数据服务实现

### 4.5.1 后端服务与数据存储

后端基于 FastAPI 异步框架构建，采用 SQLite 数据库进行数据持久化存储，提供完整的 RESTful API 体系：用户注册登录（JWT 认证）、设备绑定管理、传感器历史数据查询、远程设备控制（通过 MQTT 下发指令）、OTA 固件上传与推送管理。同时提供 Web 管理面板，支持用户查看历史数据趋势曲线、配置环境告警阈值、远程控制设备（专注模式切换、安全锁等）、接收 WebSocket 实时告警推送。后端还集成 AI 环境评分引擎，基于多维度传感器数据进行加权计算，生成环境质量综合评分（优秀/良好/一般/较差四级），并提供风险预警与改善建议。

### 4.5.2 AI 分析与消息推送

后端集成双模式 AI 分析引擎：规则引擎基于多维度环境数据（温度、湿度、AQI、eCO₂、TVOC、气体、霉菌风险）进行加权评分，生成环境质量综合评分与分级评估（优秀≥90分、良好≥70分、一般≥40分、较差<40分）；可选接入阿里云通义千问大模型（qwen3.6-flash）或本地 Ollama 模型，提供个性化舒适度建议与每周环境报告。后端 AI 助手"小眠"通过 SSE 流式接口与用户对话，系统提示词自动注入实时传感器数据，支持用户以自然语言查询当前环境状态。告警推送方面，设备端通过 Blinker 云平台 HTTP 接口向用户微信推送异常告警消息；后端通过 WebSocket 向前端实时推送传感器数据、设备状态、心跳监测、控制回执和告警事件（共 5 种消息类型），实现远程实时监控与交互联动。

### 4.5.3 通过 Web 端实现环境数据的可视化展示，前端采用 Canvas 粒子引擎将 CO₂、湿度、温度数据映射为动态粒子效果（粒子数量、大小、颜色随数据实时变化），配合数字孪生 3D 控制面板实现设备远程操控；后端通过 WebSocket 实时推送传感器数据（每 5 秒更新）、设备在线状态、心跳监测信息，前端无需轮询即可实时刷新。支持用户通过网页配置设备参数、查看设备状态、接收系统告警通知，实现完整的远程交互闭环。

通过 Web 端实现环境数据的可视化展示，生成温湿度、光照、空气质量的历史趋势曲线；支持用户通过网页配置设备参数、查看设备状态、接收系统通知，实现完整的远程交互闭环。

# 第5章 其他内容

（本章节主要描述前文未涉及的内容，如作品的工业设计、作品的成本计算等）

## 5.1 作品工业设计与结构实现

### 5.1.1 整体外观与结构布局

本作品采用一体化紧凑设计，外壳选用简约立方体造型，适配桌面场景摆放；主控板、传感器、交互模块分层布局，顶部为传感器与显示屏区域，侧面预留散热孔，兼顾美观性与实用性，减少对桌面空间的占用。

### 5.1.2 人机交互与使用体验优化

设备采用正面触控屏 + 顶部指示灯的交互设计，屏幕界面布局简洁直观，数据信息分区展示；外壳采用哑光材质，减少反光影响学习与工作，提升使用体验。

## 5.2 5.2 成本核算与性价比分析

### 5.2.1 硬件成本明细

作品硬件均采用高性价比开源模块，总成本控制在百元左右（约 114 元），具体如下：

模块 | 型号 / 规格 | 单价（元）
主控板 | ESP32-S3 开发板 | 31
传感器模块 | ENS160+AHT21、BH1750、LD2410B | 42
显示模块 | 2.4 寸 TFT 触控屏 | 26
电源与配件 | 杜邦线、外壳、电源模块 | 15
合计 | | 114

### 5.2.2 成本控制与性价比优势

相比市面同类功能的商用物联网设备，本作品成本仅为其 1/5 左右，同时保留了多维度监测、远程告警、自动化控制等核心功能，在低成本的基础上实现了较高的功能完整性与工程化设计，具备较强的推广应用潜力。

## 5.3 5.3 作品推广价值与应用展望

### 5.3.1 应用场景拓展

作品可直接应用于校园宿舍、家庭书房、办公桌面等场景，为用户提供健康环境监测与智能提醒；同时可通过扩展传感器模块，适配教室、实验室等更多场景的环境监测需求。

### 5.3.2 后续优化方向

后续可优化方向包括：优化外壳结构设计提升散热性能、实现红外家电自动控制、集成 DFPlayer Mini 语音播报模块、增加电池模块实现便携使用、接入更多类型传感器拓展监测维度、实现一主多从分布式架构支持多设备统一管理，进一步提升设备的实用性与场景适配性。

# 参考文献

（请按规范列举参考文献，参考文献格式请按照GB/T 7714规范）

[1] 物联网嵌入式系统设计指南[M].中国电子技术标准化研究院. 2020.

[2] Espressif Systems. ESP32-S3 官方技术手册[EB/OL].Espressif Systems. 2023.

[3] MQTT 3.1.1 协议规范[S].OASIS Open. 2016.

[4] Arduino 编程入门与项目实践[M].机械工业出版社. 2021.

[5] Blinker 物联网平台开发文档[EB/OL].腾讯科技(深圳)有限公司. 2024.

[6] FreeRTOS 官方文档：多核 SMP 架构与任务调度[EB/OL]. Amazon Web Services. 2024.

[7] LVGL 开源图形库官方文档 (v8.x)[EB/OL]. LVGL Kft. 2024.

[8] DFRobot. ENS160 空气质量传感器技术手册[EB/OL]. DFRobot. 2023.

[9] 海凌科. LD2410B 毫米波雷达模组使用手册[EB/OL]. Hi-Link. 2023.

[10] Blinker 物联网平台开发者文档[EB/OL]. 点灯科技. 2024.

全国大学生物联网设计竞赛设计文档[智能桌面魔方]
