tianchuangya/SmartDesktopCube-IoT/AboutUI/智能桌面魔方 二次元角色状态及菜单向导设计文档.docx

智能桌面魔方 二次元角色状态及菜单向导设计文档

# 一、二次元角色状态联动设计（与环境数据、用户行为绑定）

角色作为核心视觉交互载体，结合环境数据（AQI、eCO₂、TVOC、温湿度）及用户行为（专注模式、就座检测），呈现不同神态与动作，兼顾状态提示与情感陪伴，不遮挡核心数据，贴合整体UI治愈风。

## 1.1 状态良好（默认常态）

- 触发条件：AQI == 1 且 eCO₂、TVOC、温度、湿度均处于舒适范围
- 角色表现：😊 微笑/放松神态（默认静态，可添加轻微呼吸动效）
- 设计目的：传递安心、舒适的环境状态，让用户直观感知环境一切正常，营造治愈氛围。

## 1.2 普通提醒

- 触发条件：AQI >= 2 或单一指标（如温度、湿度）轻微偏离舒适区
- 角色表现：😟 担心/思考神态（歪头动作或头顶冒出小问号，动效柔和不突兀）
- 设计目的：温和提示用户关注环境变化，不打断专注状态，如同友好的贴心建议，兼顾实用性与情感化。

## 1.3 严重告警

- 触发条件：AQI >= 4，或 eCO₂、TVOC 等关键空气质量指标严重超标
- 角色表现：😨 紧张/催促神态（搭配小闪电或感叹号点缀，可添加轻微抖动动效，增强视觉警示）
- 设计目的：提供强视觉信号，快速提醒用户环境异常，催促用户及时处理（如开窗通风），兼顾警示性与角色辨识度。

## 1.4 专注陪伴

- 触发条件：毫米波雷达检测到用户就座，设备自动进入 FocusMode（专注模式）
- 角色表现：💤 安静陪伴神态（趴在桌上或看书的静态/低帧率动效，无多余动态干扰）
- 设计目的：遵循“不打扰是最大的温柔”，减少角色动效，安静陪伴用户专注，不分散注意力，贴合专注模式核心需求。

## 1.5 任务结束（正向反馈）

- 触发条件：用户主动退出专注模式，或空气质量从 AQI >= 4 恢复至正常范围
- 角色表现：👍 点赞/庆祝神态（竖起大拇指、撒花等轻动效，氛围活泼）
- 设计目的：提供正向情感反馈，增强用户的成就感与使用粘性，让用户感受到产品的人文关怀。

# 二、开机初始化动画设计（角色“苏醒”流程）

开机动画以角色“苏醒”为核心，结合项目标识，打造有记忆点的开场，过渡自然，兼顾创意与实用性，时长控制在合理范围，不影响设备启动效率。

1. 屏幕亮起，显示项目Logo（二次元风格）或角色睡觉的静态插画，画面简洁柔和，无多余元素；
2. 角色缓慢“苏醒”：眼睛逐渐睁开，搭配轻微的起身/伸懒腰动效（低帧率，避免卡顿），贴合二次元治愈风格；
3. 苏醒完成后，屏幕出现一行暖心欢迎语，如“嗨，今天想专注点什么？”，字体与角色风格统一，柔和易读；
4. 动画结束（总时长1-2秒），无缝过渡到主功能界面，动画以淡入淡出方式呈现，避免突兀切换。

# 三、二次元角色菜单向导功能

角色作为菜单“向导”，以轻量化交互方式呼出选项卡，不破坏主界面布局，兼顾实用性与创意性，让菜单操作更具趣味性。

- 向导定位：角色固定在屏幕角落（与专注模式、状态提示位置统一，保持视觉一致性），常态下为静态，不干扰操作；
- 呼出逻辑：用户点击角色或触发指定操作（如短按设备按键），角色做出“指引”动作（手指指向菜单方向、点头等轻动效），同时弹出菜单选项卡；
- 菜单关联：菜单选项卡（含“空气质量”等核心菜单）弹出时，角色保持指引姿态，直至用户选择菜单或关闭选项卡；
- 设计亮点：用角色替代传统菜单按钮，增强交互趣味性，同时让角色功能更丰富，既做状态提示、情感陪伴，也做操作向导，提升整体交互体验，答辩时可作为细节亮点展示。

# 四、设计规范补充

- 角色形象统一：全程使用同一款Q版二次元角色，神态、动作风格一致，形成项目专属视觉IP；
- 动效适配性能：所有角色动效均为低帧率、轻量化，适配ESP32屏幕性能，避免卡顿、占用过多资源；
- 视觉优先级：角色始终作为辅助元素，不遮挡核心数据（如环境指标、专注时长），确保功能性优先；
- 风格统一：角色设计、动画、文案均贴合“科技专业+二次元治愈”的整体调性，与设备UI风格保持一致。

# 五、图片资源及对应变量名设计（适配数据池调用）

结合所有功能场景，设计所需图片资源，严格适配320*240屏幕尺寸，变量名遵循“功能_场景_类型”命名规范，简洁易懂、便于数据池调用，避免重名，所有图片风格统一为二次元治愈风，与角色、界面调性一致，具体如下：

## 5.1 角色神态类图片（核心交互类）

用途：对应角色不同状态联动，均为透明背景、Q版风格，尺寸统一为60*60（适配角落放置，不遮挡核心数据）

图片用途 | 变量名（数据池调用名） | 图片描述 | 适配场景
角色状态良好 | img_role_normal | Q版角色微笑/放松神态，透明背景，60*60 | AQI==1且所有环境指标正常
角色普通提醒 | img_role_remind | Q版角色担心/歪头神态（头顶小问号），透明背景，60*60 | AQI≥2或单一指标轻微偏离舒适区
角色严重告警 | img_role_alert | Q版角色紧张神态（搭配小感叹号），透明背景，60*60 | AQI≥4或关键指标严重超标
角色专注陪伴 | img_role_focus | Q版角色趴在桌上/看书安静神态，透明背景，60*60 | 用户就座进入专注模式
角色正向反馈 | img_role_celebrate | Q版角色竖大拇指/撒花庆祝神态，透明背景，60*60 | 退出专注模式、环境指标恢复正常
角色菜单向导指引 | img_role_guide | Q版角色手指菜单方向指引神态，透明背景，60*60 | 用户触发菜单呼出操作

## 5.2 开机初始化类图片

用途：开机“苏醒”动画序列，适配320*240全屏尺寸，无透明背景，动画帧按顺序命名，便于逐帧调用

图片用途 | 变量名（数据池调用名） | 图片描述 | 适配场景
开机初始静态图（角色睡眠） | img_boot_sleep | 320*240全屏，浅色系背景+角色睡眠静态插画，无多余元素 | 开机屏幕亮起初始帧
开机苏醒过渡帧1（眼睛半睁） | img_boot_wake1 | 320*240全屏，角色眼睛半睁，轻微苏醒姿态，背景不变 | 开机苏醒动画中间过渡
开机苏醒过渡帧2（完全睁眼） | img_boot_wake2 | 320*240全屏，角色完全睁眼，轻微伸懒腰姿态 | 开机苏醒动画末尾过渡
开机欢迎语背景图 | img_boot_welcome | 320*240全屏，浅色系背景+苏醒后角色，预留欢迎语文本位置 | 苏醒完成后显示欢迎语
项目二次元Logo图 | img_boot_logo | 320*240全屏，二次元风格Logo+项目名“智能桌面魔方” | 开机可选初始帧（替代角色睡眠图）

## 5.3 背景及界面辅助类图片

用途：屏幕背景、菜单弹窗背景，适配320*240屏幕，风格简约，不遮挡数据

图片用途 | 变量名（数据池调用名） | 图片描述 | 适配场景
主界面背景图 | img_bg_main | 320*240全屏，浅米白/淡浅蓝底色，极淡网格纹理，无多余元素 | 设备主功能界面默认背景
专注模式背景图 | img_bg_focus | 320*240全屏，比主背景更淡的底色，无纹理，降低视觉干扰 | 专注模式界面背景
菜单选项卡背景图 | img_bg_menu | 200*150（适配弹窗尺寸），浅白色背景，轻微圆角边框，二次元简约风格 | 角色向导呼出的菜单选项卡
专注报告弹窗背景 | img_bg_report | 280*200（适配弹窗尺寸），浅色系背景，预留角色、数据显示位置 | 退出专注模式后的报告弹窗

## 5.4 数据池调用说明

- 所有变量名均为英文小写，采用“img_功能模块_具体用途”格式，便于数据池统一管理和调用，避免与其他变量冲突；
- 图片格式统一为PNG（透明背景类）、JPG（全屏背景类），严格适配对应尺寸，避免拉伸、模糊，降低ESP32调用负载；
- 动画序列图片（开机苏醒帧）按变量名后缀1、2顺序命名，便于数据池按帧顺序调用，实现流畅动画效果；
- 所有图片资源需与数据池中定义的变量名一一对应，调用时直接通过变量名读取，无需额外路径配置，简化开发流程。

|（注：文档部分内容可能由 AI 生成）
