tianchuangya/SmartDesktopCube-IoT/AboutUI/ui界面二次元风格设计.docx

智能桌面魔方 UI 二次元风格视觉设计需求整理

一、专注模式页面设计

1. 视觉布局：页面固定角落放置迷你二次元 Q 版角色插画，尺寸小巧、不抢占主界面数据显示空间，低调不抢眼。
2. 文案搭配：角色旁附带暖心文案「专注中，加油！」，字体柔和简约，和插画风格统一。
3. 触发场景：用户入座自动进入专注模式时即刻展示，营造安静治愈的氛围感，不破坏专业数据界面整体调性。
4. 扩展优化：可增加轻微呼吸渐变动效，静态插画低亮度显示，避免强光分心；专注时长越久，角色可微调细微暖心姿态变化。

二、环境数据状态联动设计（AQI / 温湿度 / TVOC 等通用）

1. 状态联动逻辑
  - 环境数据正常优良：屏幕边缘环绕柔和冰蓝光带、缓慢流动渐变；二次元角色呈现微笑放松表情，神态治愈。
  - 环境数据超标异常：屏幕边缘光带切换暖红色警示流动光效；二次元角色切换紧张、担忧神态，直观提示异常。
2. 设计亮点：摒弃传统红绿灯、文字告警死板样式，用二次元角色神态 + 边缘氛围光带双重联动，创意感拉满，兼顾美观与状态识别。
3. 扩展优化：可增设中间档位（轻度偏高），光带呈暖黄色、角色轻微皱眉中性表情，实现三档状态分层提示，更细腻。

三、开机启动画面设计

1. 展示时长：设备上电开机，专属启动画面停留 1~2 秒 自动淡出。
2. 视觉内容：二次元手绘风格专属 Logo，搭配项目全称「智能桌面魔方」艺术字体排版。
3. 风格调性：二次元简约治愈风，配色统一后续 UI 体系；过渡动画平滑淡入淡出。
4. 扩展优化：可添加极淡粒子星光点缀，不花哨；启动画面结束后无缝切入专业数据主界面，风格切换自然，既有开场记忆点又不影响专业功能性。

四、退出专注模式汇报弹窗设计

1. 弹窗布局：专注结束生成数据报告弹窗，右下角 / 左下角嵌入迷你二次元角色插画。
2. 角色与文案：角色竖大拇指鼓励姿态，搭配文案「做得好！」「专注圆满结束～」。
3. 价值亮点：细节拉满，提升用户情感体验；项目答辩时评委能直观感受到人文关怀 + 交互细节设计，加分明显。
4. 扩展优化：可根据本次专注时长微调文案，时长越长鼓励文案更丰富；弹窗增加轻微上浮动画，角色做小幅点赞微动效。

五、整体统一规范（补充扩展）

1. 全程使用同一款 Q 版二次元角色贯穿所有页面，形象统一，形成项目专属视觉 IP；
2. 角色尺寸统一做小比例边角点缀，不遮挡传感器数据、WiFi 状态、时间等核心信息；
3. 光带动效、角色神态切换均做低帧率柔和动画，适配 ESP32 屏幕性能，不卡顿、不占用过多资源；
4. 整体风格：科技专业风 + 二次元治愈风结合，数据界面保持极简专业，细节彩蛋用二次元元素点缀，平衡功能性与创意颜值。
