tianchuangya/SmartDesktopCube-IoT/AboutUI/UI制作.docx

当然可以！GUI Guider 做的界面，**不仅能整得超好看，还能做到非常丝滑**，而且比手写代码效率高太多了！

## ✨ 「好看」怎么整？（GUI Guider 可视化调）

在工具里直接拖拽改样式，不用写一行代码：

1. **卡片/容器美化**

- 圆角：拉到 12~20px，瞬间就有现代感

- 背景：用白色/浅灰色，加个淡淡的边框和阴影，质感直接拉满

- 内边距：给文字留出空间，别贴边，看着更清爽

2. **按钮样式**

- 主色调：用你喜欢的蓝色，按下状态加深一点，做出按压反馈

- 圆角：8~12px，和卡片风格统一

- 文字：用白色，字号 14~16px，居中对齐

3. **文字和排版**

- 标题：用 18~20px 粗体，卡片内数据用 14~16px

- 颜色：深灰/黑色为主，避免纯黑，看着更柔和

- 对齐：卡片内文字左对齐，按钮文字居中对齐

## 🚀 「丝滑」怎么实现？（关键设置）

这才是ESP32上流畅度的核心，GUI Guider 导出的代码配合这些设置，丝滑度直接翻倍：

1. **开启硬件加速**

- 在你的Arduino代码里，初始化TFT_eSPI时开启DMA：

```cpp

tft.initDMA();

```

配合 LVGL 的 `lv_disp_draw_buf_init`，能大幅提升刷新速度。

2. **优化刷新方式**

- 在 `lv_conf.h` 里设置：

```c

#define LV_REFRESH_RATE 60 // 把刷新率设到60Hz

#define LV_DISP_DEF_REFR_PERIOD 16 // 约60fps

```

3. **减少界面负担**

- 别用太多复杂的阴影、渐变、半透明效果，会严重拖慢帧率

- 界面元素能静态就静态，少做频繁重绘的动画（比如实时刷新的数字，用定时器控制1秒刷新一次就行）

4. **内存优化**

- 双缓冲模式：在初始化LVGL时，用两个显示缓存（`draw_buf` 用两个），避免撕裂感

- 缓存大小：`buf[320 * 10]` 足够用，不用开太大

## 📌 额外加分项（丝滑又好看）

- 按钮按下的反馈动画、页面切换的淡入淡出效果，GUI Guider 里直接一键开启

- 数据更新用 LVGL 的动画 API，比如 `lv_bar_set_value(bar, value, LV_ANIM_ON)`，进度条会平滑过渡，比直接赋值好看10倍

- 给界面加个简单的主题（比如 `lv_theme_material_init()`），统一所有控件的风格，不用一个个调

总的来说，GUI Guider 做出来的界面，只要做好上面这几点，在你的ESP32上跑起来**又好看又丝滑**完全没问题。

需要我给你一份「GUI Guider导出代码后，在Arduino里做丝滑优化的完整示例」吗？
