tianchuangya/SmartDesktopCube-IoT/关于模型/训练模型.docx

时间 | 核心目标 | 你要做什么（每天2小时） | 做到这个就稳了
第1天 | 搞定“教师”设备 | 去实验室或网上确认专业检测仪，并搞定免费天气API的注册和验证（这步必须今天完成！）。 | 设备来源确定，API密钥拿到手。
第2-3天 | 搭建你的传感器 | 连接ENS160+BME280，写代码把TVOC、eCO2、温度、湿度按时间存到SD卡里。 | 串口能稳定打印传感器数值。
第4-5天 | 采集黄金数据 | 借到设备，和你的传感器放在一起，连续记录24-48小时，并同步抓取室外天气数据。 | 至少24小时的连续数据到手。
第6天 | 合并与训练 | 把所有数据合并到一个CSV文件，上传到Edge Impulse，点击“训练”得到模型。 | R² > 0.8 的模型生成。
第7天 | 部署与完善 | 把模型部署到ESP32，验证预测功能，并优化PPT或整理数据报告。 | 项目核心功能跑通。
