tianchuangya/SmartDesktopCube-IoT/（旧）智能桌面魔方——物联网竞赛项目系统方案.docx

智能桌面魔方——物联网竞赛项目系统方案

# 一、项目概述

## 1.1 项目名称

智能桌面魔方（Smart Desktop Cube IoT）

## 1.2 项目背景与痛点

日常桌面场景缺乏一体化环境监测与智能交互设备（在答辩PPT中放一页对比表），传统环境监测仪功能单一，无联动控制、远程管理及AI智能分析能力，且未覆盖空气质量监测需求；手动调控家电设备繁琐，无法根据室内环境参数实现自动化适配，难以兼顾使用便捷性与场景智能化需求。本项目针对校园、居家桌面场景，打造集环境感知（温湿度、光照、空气质量）、本地交互、远程管控、AI智能分析于一体的物联网智能终端，解决环境数据可视化、家电自动化、场景个性化适配、空气质量实时监测的核心痛点。

## 1.3 项目核心定位

本项目采用硬件端+网络后端分工协作模式，硬件端负责本地数据采集、交互控制与设备联动，网络端负责数据处理、AI分析与远程管控，两大模块分工明确、无功能重叠，整体系统低成本、易落地、实用性强，贴合物联网竞赛创新与实操要求。

# 二、整体系统架构

# 系统采用分层架构 + 高可用模块化设计，划分为硬件感知控制层、网络传输层、后端服务层、应用交互层、安全加固层，实现数据闭环流转与双向指令控制，架构稳定、扩展性强、安全性高，适配竞赛与实际使用场景，系统支持一主多从分布式设备接入，预留桌面环境数字孪生扩展接口，可实现多区域环境数据融合与物理虚拟空间同步映射，采用屏幕边缘氛围光效替代传统 LED 灯珠，实现环境数据与视觉效果实时联动，无额外硬件、展示更具科技感。。

# 硬件感知控制层：核心控制单元、环境传感器、显示交互模块、灯光音频模块、红外控制模块，负责本地数据采集与设备执行，蓝牙Mesh设备控制模块（台灯联动）

# 网络传输层：WiFi 无线传输 + MQTT over TLS 加密通道 + HTTPS 接口，保障通信安全

# 后端服务层：数据存储、AI 智能分析、气象对接、语音合成、业务逻辑处理模块

# 应用交互层：本地触控交互、后端网页管理平台

# 安全加固层：设备唯一标识 DID、临时 Token、限流封禁、黑名单机制、硬件安全启动、Flash 加密

# 三、模块分工与功能明细（硬件端+网络端）

## 3.1 硬件端

硬件端以ESP32-S3为核心控制器，基于Arduino IDE开发，搭载光照传感器、ENS160 + AHT21、触控显示屏、氛围灯、语音喇叭、红外收发一体模块、DFPlayer Mini MP3 播放器、Micro SD 卡数据存储模块实现全流程本地感知与执行控制，所有功能独立完成，不与网络端功能重叠。

### 3.1.1 环境数据采集

- 实时采集室内温湿度数据，保证数据精准稳定，适配日常桌面环境监测精度要求
- 实时采集环境光照强度数据，为屏幕亮度调节、环境分析提供基础数据支撑
- 通过 ENS160 高精度空气质量传感器，实时采集室内有害气体（氨气、硫化物、苯系蒸汽等）浓度数据，完成空气质量等级判定，为AI分析与预警提供数据支撑；模块上电后需2-3分钟预热，确保数据采集精准，代码中加入对应延时逻辑，保障数据稳定性。

### 3.1.2 本地显示与交互

- 搭载 2.4 寸触控 TFT 显示屏，支持多页面展示
- 显示内容：时间、温湿度、光照、空气质量多指标分级展示（AQI、TVOC、eCO₂、霉菌风险）、AI 建议、设备状态
- 支持用户单独查看任一空气质量指标详情与趋势，实现精细化数据查阅
- 网络离线时自动进入离线模式，继续显示本地数据
- 状态栏提示 “网络未连接”，AI 建议区显示 “等待网络恢复”

### 支持手动切换与毫米波雷达自动进入专注模式两种方式

### 3.1.3 灯光与音频输出

- 利用TFT 屏幕四周边缘作为环境氛围光带，无需外接 RGB灯珠，光效颜色、呼吸频率与温湿度、空气质量、CO₂浓度实时联动。
- ・空气优良时光效为柔和长周期慢呼吸；空气质量下降或 CO₂超标时，光带自动变为警示色并加快呼吸频率，形成直观视觉提醒。
- ・空气质量异常、网络异常、预警时屏幕边缘自动转为红色急促呼吸，无需独立灯珠即可实现强视觉反馈。采用 DFPlayer Mini MP3 模块实现本地语音播报，将高频提示音预先存入专用 TF 卡，无需云端 TTS 即可零延迟播报
- 语音喇叭支持故障提示、网络提醒、AI 建议播报
- 网络断开超过 1 分钟自动语音提醒用户检查网络
- 专注模式智能台灯联动
- 系统通过ESP32-S3内置蓝牙模块，基于蓝牙Mesh协议与桌面智能台灯建立直接通信。当毫米波雷达检测到用户就座并自动进入专注模式后，系统自动向台灯发送色温调节指令，将灯光切换为3000K暖色调，营造舒适专注的桌面光环境；退出专注模式时自动恢复默认色温。
- 技术特点：
- 零网关架构：ESP32-S3直接作为蓝牙Mesh配置端（Provisioner），无需额外网关设备，降低系统复杂度与硬件成本
- 场景化智能联动：专注模式触发→灯光自动适配，体现物联网“感知-决策-执行”完整闭环
- 自动式交互：用户无需任何手动操作，坐下即自动调节光环境，实现真正的无感智能

### 3.1.4 红外家电控制

- 内置定向红外收发一体模块可自动 / 远程控制空调等家电
- 根据预设温湿度阈值，自动控制空调启停，实现环境温度自动化调节
- 支持红外指令学习与本地存储，发送指令后自动切换接收模式，获取空调应答信号，确认设备真实开启 / 关闭，形成闭环控制

### 3.1.5 系统调度与低功耗管理

- 支持定时任务配置，实现定时关机、定时数据采集功能，提升设备实用性
- 开启夜间自动低功耗模式，降低设备能耗，延长运行时长
- 屏幕亮度自适应调节，根据环境光照强度、时段自动调整，兼顾视觉体验与功耗控制
- 新增毫米波人体存在检测模块，实现无感自动专注模式：检测到用户就座自动进入专注模式，用户离开超时自动退出，无需手动操作，提升智能交互体验。
- 屏幕亮度自适应调节，根据环境光照强度、时段自动调整，兼顾视觉体验与功耗控制。
- 屏幕边缘氛围光效支持智能动态调节，根据环境等级自动切换颜色与呼吸速度，提升交互体验与科技感。

### 3.1.6 数据通信

- 稳定连接WiFi网络，保障硬件与后端通信畅通（包含自动断网重连）
- 将本地采集的温湿度、光照、空气质量等环境数据实时上传至后端服务端，确保数据同步及时
- 精准接收网络端下发的控制指令、语音文本数据，快速响应执行
- 异常事件主动上报，支持触发微信告警通知
- 支持传感器数据本地存储：通过 SPI 接口 SD 卡模块，将温湿度、光照、空气质量、运行日志实时写入独立 TF 卡，实现数据掉电保存与离线记录
- 支持分布式多设备架构：同一账号可绑定主控制设备与多个环境采集从设备，云端统一汇聚、展示、分析多点环境数据。

### 3.1.7 硬件端模块化代码框架

硬件端采用共享数据池 + 模块化架构。所有功能模块围绕统一的全局数据结构（AppConfig）运行，各模块只负责读写数据池中的对应字段，模块之间不直接通信，实现高内聚低耦合。

文件 | 核心职责 | 数据池操作权限
main.ino | 系统初始化、各模块初始化调用、主循环任务调度 | 无直接读写操作
sensor.cpp | 驱动读取 ENS160、AHT21、BH1750 传感器数据，统一写入全局数据池 | 仅写入传感器类数据字段
screen.cpp | LVGL 界面渲染、触控交互逻辑、页面状态刷新 | 只读传感器数据与设备状态字段
speaker.cpp | 语音播报底层驱动封装 | 只读指令模块下发的播报文本缓冲区
dfplayer.cpp | 本地 MP3 音频播放控制、播放器指令调度 | 只读播放控制指令
sdcard.cpp | 离线数据缓存、历史监测数据本地日志存储 | 读取传感器数据，写入本地文件
wifi.cpp | WiFi 连接配置、自动重连、网络状态检测 | 读写并更新网络连接状态字段
mqtt.cpp | MQTT 云端消息上行上报、下行消息监听接收 | 上行只读传感器数据；下行写入设备配置字段
security.cpp | 设备 DID 唯一标识管理、Token 凭证存储、Flash 加密读写 | 独立管理安全凭证类私有字段
command.cpp | 指令注册表维护、云端下行指令解析与功能派发 | 解析指令并修改对应业务控制字段

setup () 全局硬件自检

开机一次性检测所有模块：

- 屏幕、传感器、喇叭、WiFi、Flash、时钟等
- 故障自动交叉告警：屏幕坏 → 喇叭报警；喇叭坏 → 屏幕提示
- 任意模块故障不影响整机运行，实现故障隔离

loop () 非阻塞主循环 + 条件执行

主循环永不阻塞，根据模块状态动态执行：

- 模块正常 → 执行功能
- 模块异常 → 跳过执行，不卡死系统
- 网络、显示、传感器、喇叭完全异步运行

表驱动编程（命令表模式）

使用结构体数组实现类似 Excel 配置表的命令管理：

- 命令 ID、命令名称、执行函数统一存放
- 新增 / 删除功能只需修改命令表，不改动主框架
- 支持远程指令、本地按键、红外指令统一调度

### 3.1.8 非阻塞异步联网架构

硬件端采用非阻塞 WiFi + MQTT 重连机制，确保断网不影响本地使用：

- 联网过程不阻塞屏幕、传感器、喇叭运行
- 断网自动进入离线模式，界面显示 “网络未连接”
- 每 10 秒后台尝试重连一次
- 重连成功自动恢复上传、同步 AI 建议
- 断网超过 1 分钟，喇叭自动播报：“网络异常，请检查路由器”
- 本地数据持续采集、显示、存储，不受网络影响

### 3.1.9 硬件安全机制

本设备在硬件层构建了四道纵深防线，覆盖固件、存储、身份、凭证四个维度，实现在物理设备被获取或通信被监听的情况下，仍能有效保护系统安全与用户隐私。

安全启动

设备仅运行签名后的合法固件，防止恶意固件刷入

Flash 加密

使用 mbedtls 库对 Flash 存储区域加密：

- 设备唯一 DID 加密存储
- 临时 Token 加密存储
- 传感器历史数据加密存储
- 防止固件读取、破解、篡改

唯一设备标识 DID

每台设备拥有全球唯一固定 DID，用于身份识别

临时 Token 鉴权

设备通过 HTTPS 申请短期有效 Token（5分钟周期），避免固定密钥泄露风险

### 3.1.10 算法模块

传感器数据滤波算法：采用均值滤波与限幅滤波结合，去除噪声与突变数据，保证温湿度、光照、空气质量数据稳定可靠。

人体舒适度评估算法：通过多传感器融合计算室内环境综合评分，基于国际通用不适指数公式（discomfort index）无风公式，输出人体舒适度等级。

故障检测算法：实时监测屏幕、传感器、喇叭、网络等模块状态，实现异常识别与故障隔离。

自适应策略算法：根据环境光照自动调节屏幕亮度，根据网络状态自动调整重连策略，根据运行模式自动调整设备功耗。

人体存在感知与专注模式决策算法：通过毫米波雷达实现人体在位检测，自动判断进入 / 退出专注模式，实现无感智能调度。

屏幕氛围光效联动算法：根据 AQI、TVOC、eCO₂等环境参数，自动计算光带颜色、呼吸周期与亮度，实现数据与视觉效果实时联动。

## 3.2 网络/后端网页端

网络端聚焦后台数据处理、智能分析与远程管控，依托网页平台实现数据可视化、AI运算与远程配置，后端采用 FastAPI + 全异步 async/await 架构，为硬件端提供数据支撑与策略指令，两大模块协同完成整体系统功能。

### 3.2.1 数据管理与可视化

- 搭建账号登录体系，实现设备专属账号管控，保障数据安全，并设有管理员账户，可以精准查询用户账户的设备信息，实现远程调配与设置
- 接收硬件端上传的温湿度、光照、空气质量等环境数据，完成持久化存储，利于数据分析和避免数据丢失
- 生成日/周/月环境历史数据曲线、可视化数据看板（含温湿度、光照、空气质量），支持多设备数据切换查看，直观展示环境变化趋势
- （可选）搭建桌面环境数字孪生可视化界面，将设备状态、环境参数、模式切换、异常告警实时映射到虚拟场景，实现物理环境与虚拟环境同步联动。

### 3.2.2 AI智能处理

- 对接赛事指定大模型接口，获取硬件上传的温湿度、光照、空气质量等环境数据
- 通过AI算法计算人体舒适度等级、环境综合评分
- 生成场景化实用建议，包含穿搭建议、通风提醒、作息适配提示、空气质量优化建议（如开窗通风、摆放绿植、减少有害气体来源等）
- 根据近期（一周）的温湿度、光照、空气质量数据，为用户提供综合环境优化建议，助力改善桌面周边环境

### 3.2.3 气象与预警逻辑

- 对接公开气象数据接口，完成室内外温差实时计算
- 识别极端天气、环境异常情况（含温湿度超标、空气质量异常），生成对应预警文案，推送至硬件端播报，提醒用户及时处理

### 3.2.4 语音合成与指令下发

- 采用快慢分离架构：高频语音（温度、湿度、告警、空调状态）由硬件端 DFPlayer Mini 本地播报；复杂 AI 建议、周总结等长文本由云端 TTS 合成向硬件端推送语音播报指令、模式切换指令、家电控制指令，实现远程联动

### 3.2.5 远程配置与设备管控

- 搭建网页管控面板，支持用户自定义温湿度、光照、空气质量触发阈值，适配个性化需求
- 支持远程手动控制红外家电启停、氛围灯开关，实现远程设备管控
- 实时监测设备在线状态，识别传感器异常情况并推送告警，保存异常运行记录
- 支持同一账号下多主从设备统一管理与远程配置，可查看不同采集节点数据，实现全屋 / 多区域环境智能管控。

### 3.2.6 业务逻辑处理

- 实现双模式后台配置，管理专注模式、日常模式的各项运行参数，并且在退出专注模式之后汇报在专注模式时间段内所有信息给用户
- 统一管控语音播报频率、定时推送规则，避免频繁播报干扰使用

### 3.2.7 微信告警通知

- 对接微信公众号测试号平台，实现异常事件实时推送
- 当温湿度超标、空气质量异常、传感器故障、网络断开时，后端自动向用户微信推送告警消息
- 推送内容包含设备编号、报警类型、当前数据、发生时间，便于用户快速定位问题

### 3.3 通信安全与防护架构

3.3.1 传输加密

1. MQTT over TLS

设备与服务器之间所有上报数据、指令下发全程 TLS 加密，抓包无法破解。

2. 全 HTTPS 接口

后端网页、Token 申请、配置下发、语音合成、微信推送全部使用 HTTPS，无明文传输。

3.3.2 身份鉴权体系

- DID 设备唯一标识：硬件级唯一身份，不可伪造
- 临时 Token：时效可控，过期自动失效，降低泄露风险
- 每次上报必须携带 DID + Token，双重验证

3.3.3 限流 + 双层黑名单 + 封禁策略（防攻击）

1. 限流机制

限制单设备单位时间上报次数，防止频繁请求攻击。

2. 短时封禁策略

同一 MAC / Token / IP 短时间大量请求，自动临时封禁 5 分钟。

3. 长期封禁策略

已封禁设备仍持续大量访问，直接将 MAC 地址加入永久黑名单。

4. 双层防护
  - 应用层：Token 校验、DID 校验、请求频率检查
  - 网络层：IP 封禁、MAC 封禁、异常流量过滤

# 四、硬件选型明细

硬件选型贴合竞赛低成本、易调试、零基础上手要求，所有模块适配Arduino开发环境，接线简单、稳定性强，无复杂调试流程。

- 核心控制器：ESP32-S3开发板n16r8焊针（自带WiFi和蓝牙）
- 环境传感器：ENS160 + AHT21组合模块（包含气体传感器和温湿度传感器）、BH1750光照传感器、显示模块：2.4寸触控TFT显示屏、LD2410B 24G 毫米波人体存在传感器
- 执行模块：无源语音喇叭、红外发射模块（KY-022红外传感器和KY-005红外发射模块）
- 辅助配件：电源模块、杜邦线、结构外壳等

# 五、团队分工

- 成员 1：硬件核心开发、系统架构设计、模块化代码实现、安全机制开发
- 成员 2：后端服务开发、MQTT 通信、AI 对接、微信告警、数据管理
- 成员 3（待定）：功能测试、文档撰写、PPT 制作、演示视频、外壳与展示设计

# 六、创新点与竞赛优势

多维度空气质量精细化监测与展示

采用 ENS160+AHT21 实现温湿度、TVOC、eCO₂、AQI 同步采集，支持霉菌风险评估与多指标分级展示，用户可单独查看任一污染物数据，突破传统设备仅显示等级的局限，健康参考价值更强。

毫米波无感自动专注模式

引入 24G 毫米波人体存在传感器，无需手动操作，自动识别用户就座 / 离开状态，智能进入 / 退出专注模式，实现真正无感智能交互，大幅提升用户体验与科技感。

一主多从分布式物联网架构

系统支持主设备 + 多采集从设备部署，同一账号统一管理，实现多点环境数据采集、上传、融合分析，从单设备升级为物联网分布式系统，架构更完整、扩展性更强。

桌面环境数字孪生可视化（扩展）

网页端支持搭建桌面数字孪生系统，实现物理设备、环境参数、运行状态与虚拟场景实时映射，展示效果更具视觉冲击力与工程完整性。

软硬解耦 + 高可靠非阻塞架构

硬件端与云端严格分工无重叠，采用非阻塞联网、故障隔离、开机自检、传感器滤波等算法，系统稳定、鲁棒性强，满足竞赛与实际使用双重要求。

屏幕边缘一体化氛围光效设计

摒弃传统独立 LED 灯珠方案，利用屏幕四周边缘实现环境光效联动，光带颜色、呼吸频率随空气质量、CO₂浓度动态变化。空气优良时柔和慢呼吸，超标时急促警示呼吸，无额外硬件、视觉更统一、科技感更强、产品化程度更高，区别于普通参赛项目的简单灯效堆砌。

多协议异构设备智能联动

不同于常规竞赛作品仅实现单一传感器数据采集，本系统利用ESP32-S3双模通信能力（Wi-Fi + BLE），实现与蓝牙Mesh智能台灯的直接通信与控制。当专注模式激活时，系统通过蓝牙协议栈自动调节台灯色温与亮度，营造适配专注场景的光环境。该设计体现了物联网终端对异构协议设备的协同管控能力，展示了系统从“环境感知”到“跨协议执行”的完整链路，拓展了智能桌面的交互边界。

# 七、待定的功能

1、毫米波人体感应

2、自研轻量化AI推理模型，用现有数据反推PM2.5等数据

3、后端本地调用Edge-TTS生成的语音支持普通话和各种地道的方言适合不同地区的播报需求

4、本地用 FreeRTOS 多任务 实现真正的硬件并行传感器数据读取和阈值判断语音播报分开运行（已实现）

6、打造专属ip虚拟角色，背景、开机启动、aqi状态、专注模式、菜单都采用虚拟角色替换，ESP32划分 SPIFFS 分区存放角色图片。代替传统rgb灯
