tianchuangya/SmartDesktopCube-IoT/魔方功能表旧.docx

1. 硬件端呈现

- 外观：3.2cm 方正立方体，简洁科技感，无外露飞线
- 0.96 寸 OLED 屏幕：分区清晰、排版专业
  - 时间 / 日期（网络自动同步）
  - 温度、湿度实时显示
  - WiFi 信号、配网状态
  - 设备 ID、电量百分比
  - 语音指令执行反馈
- 灯光：WS2812 RGB 氛围灯，支持呼吸、渐变、报警、语音联动灯效
- 音频：双声道喇叭，支持提示音、报警音、语音播报结果
- 供电：内置 3.7V 锂电池 + TP4056 充电，支持独立脱机运行
- 交互：语音控制 + 网页远程控制双重模式

2. 网站平台呈现（本地服务器部署）

- 登录系统：账号密码登录 + JWT 权限验证
- 设备总览：多设备在线 / 离线状态、实时数据卡片
- 数据仪表盘：温湿度实时曲线、历史柱状图
- 远程控制面板：灯效、音量、报警开关、设备重启、模式切换
- 设备管理：设备认证、绑定、解绑、黑名单
- 系统日志：用户操作日志 + 设备上下线日志 + 语音指令日志
- AI 语音交互面板：语音输入、语义解析结果展示、指令执行历史

3. 整体系统流程

1. 魔方上电 → 进入配网模式 → 用户配网 → 自动连 WiFi
2. 设备携带唯一 DeviceID + Token 向服务器认证
3. 认证通过 → 开始上传温湿度数据到本地服务器
4. 网页端实时展示数据并生成图表
5. 用户通过 AI 语音 或网页按钮下发指令
6. 服务器转发指令 → ESP32 执行动作（灯光 / 显示 / 报警）
7. 所有操作写入日志 → 可追溯、可审计
8. 多设备同时接入 → 统一批量管理

三、实现功能清单

（一）硬件端功能

1. 基础信息显示模块

- 0.96 寸 OLED 驱动
- 时间 / 日期网络同步（NTP）
- 温度、湿度实时显示
- WiFi 信号强度图标
- 设备 ID 短显示
- 电量百分比显示
- 指令执行状态文字反馈

2. 环境监测模块

- DHT11 温湿度采集
- 数据滤波、防抖、异常剔除
- 高温 / 高湿阈值报警
- 报警时灯光变红 + 蜂鸣提示

3. 灯效与音频模块

- RGB 灯效：呼吸、渐变、常亮、报警、语音联动
- 开机提示音
- 配网成功提示音
- 报警提示音
- 语音指令执行成功提示

4. WiFi 通信与配网模块（国赛关键）

- 自动重连机制
- AP 配网模式（手机 / 电脑连接魔方热点配网）
- 配网信息本地保存
- 支持重置 WiFi
- HTTP 协议上传数据到服务器

5. 设备安全认证模块

- 每台设备唯一固定 DeviceID
- 设备上线携带 Token 鉴权
- 鉴权失败拒绝接入服务器
- 防伪造设备、防重复接入

6. 远程指令执行模块

- 接收服务器下发指令：
  - 切换灯效
  - 设置灯光颜色
  - 开关报警
  - 重启设备
  - 调整屏幕亮度
  - 静音 / 解除静音

7. 电源管理模块

- 锂电池供电
- Type-C 充电
- 低电量提醒
- 简单功耗优化

（二）网站平台功能

1. 用户权限系统

- 用户注册、登录、退出
- JWT 身份验证
- 管理员 / 普通用户权限分离
- 密码加密存储

2. 设备管理系统

- 设备列表（在线 / 离线状态）
- 设备认证、绑定、解绑
- 设备黑名单功能
- 多设备批量查看

3. 数据可视化系统

- 实时温湿度仪表盘
- 历史折线图（按小时 / 天 / 周）
- 统计柱状图（平均值、峰值）
- 数据自动刷新

4. 远程控制系统

- 灯光颜色选择
- 灯效模式切换
- 报警开关
- 设备远程重启
- 音量调节
- 多设备批量控制

5. 日志审计系统

- 用户操作日志：谁、何时、控制了什么、结果如何
- 设备上下线日志
- 语音指令执行日志
- 日志可搜索、可导出

6. AI 智能语音交互模块

- 前端语音录制上传
- 对接第三方语音识别 API（百度 / 讯飞 / Web Speech）
- 语义解析：
  - “现在温度多少”
  - “打开灯光”
  - “把灯调成蓝色”
  - “开启报警模式”
  - “重启设备”
  - “查看今天湿度曲线”
- 语音指令执行结果回显
- 语音历史记录

7. 本地服务器与数据库

- 本地局域网部署（电脑即可运行）
- MySQL / SQLite 存储
  - 用户表
  - 设备信息表
  - 传感器历史数据表
  - 操作日志表
- API 接口：
  - 设备上报数据
  - 指令下发
  - 语音解析
  - 数据查询

四、详细分工（清晰责任制）

1. 硬件负责人（你）

- ESP32 基础环境搭建
- 0.96 寸 OLED 屏幕驱动与 UI 排版
- DHT11 数据采集与滤波
- WS2812 灯效逻辑编写
- 喇叭提示音实现
- WiFi 配网功能实现（AP 模式）
- NTP 网络时间同步
- DeviceID + Token 认证逻辑
- HTTP 上传数据到服务器
- 接收服务器指令并执行
- 锂电池供电调试
- 硬件整体组装、布线、外壳布局
- 系统稳定性、断连重连测试

2. 网页 / AI 负责人

- 本地服务器搭建（Flask/Django/Node）
- 数据库表结构设计
- 用户登录、权限、加密
- 前端页面设计（设备列表、仪表盘、控制页、日志）
- ECharts 图表绘制（折线、柱状、实时曲线）
- 设备认证接口开发
- 远程控制指令下发接口
- 日志系统实现
- AI 语音识别接入
- 语音语义解析逻辑
- 语音指令映射为硬件控制指令
- 内网穿透 / 局域网访问配置
- 多设备并发处理

五、创新点（评委直接打高分）

1. 超小型立方体硬件，高度集成，外观精致
2. 完整配网机制，真正可落地部署
3. 设备身份认证 + 权限系统 + 操作日志，达到工业物联网安全级别
4. 本地服务器部署，不依赖公网云，演示稳定
5. 多设备统一管理，具备分布式系统特征
6. AI 智能语音控制，实现自然语言交互，科技感拉满
7. 软硬件全闭环，可演示、可复现、可扩展

六、预期演示流程（现场满分流程）

1. 展示智能魔方硬件外观
2. 演示配网过程（手机配网，评委直观可见）
3. 魔方上线，服务器自动识别并认证
4. 网页端显示设备在线、实时温湿度
5. 展示历史数据折线图、柱状图
6. 演示网页远程控制灯光、报警、重启
7. 核心高潮：AI 语音控制
  - 语音问温度
  - 语音控制灯光
  - 语音查询数据
  - 语音开关报警
8. 展示操作日志、设备日志
9. 接入第二台魔方，演示多设备批量管理
10. 总结系统可扩展性与应用场景
