tianchuangya/SmartDesktopCube-IoT/AboutUI/env_monitor/import/image/background.jpg

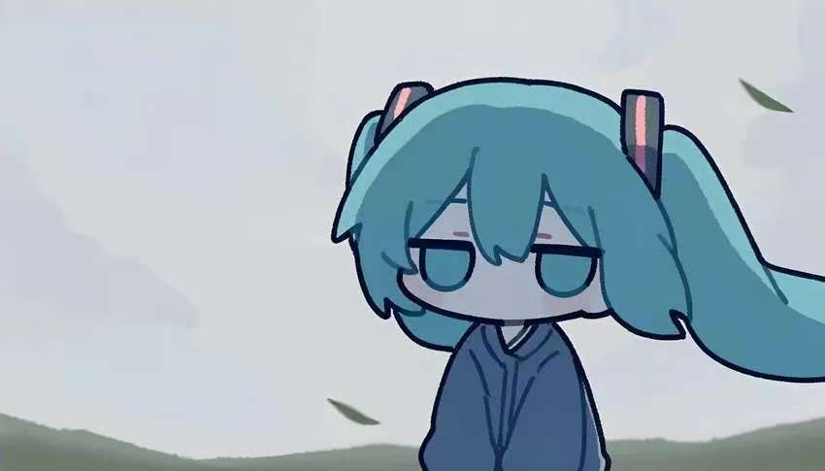
AboutUI/env_monitor/import/image/background.jpg
