tianchuangya/SmartDesktopCube-IoT/AboutUI/smart_cube/import/image/img_bg_focus.jpg

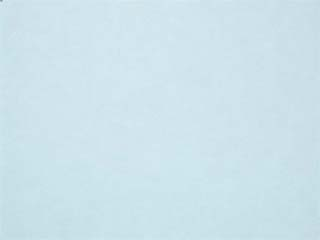
AboutUI/smart_cube/import/image/img_bg_focus.jpg
