tianchuangya/SmartDesktopCube-IoT/AboutUI/smart_cube/import/image/img_bg_report.jpg

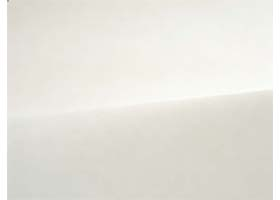
AboutUI/smart_cube/import/image/img_bg_report.jpg
