tianchuangya/SmartDesktopCube-IoT/AboutUI/smart_cube/import/image/img_boot_sleep/img_boot_sleep_27.png

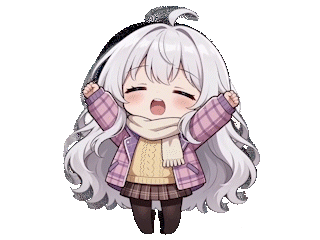
AboutUI/smart_cube/import/image/img_boot_sleep/img_boot_sleep_27.png
