tianchuangya/SmartDesktopCube-IoT/AboutUI/智能桌面魔方 二次元角色状态及菜单向导/高清/img_bg_report.jpg

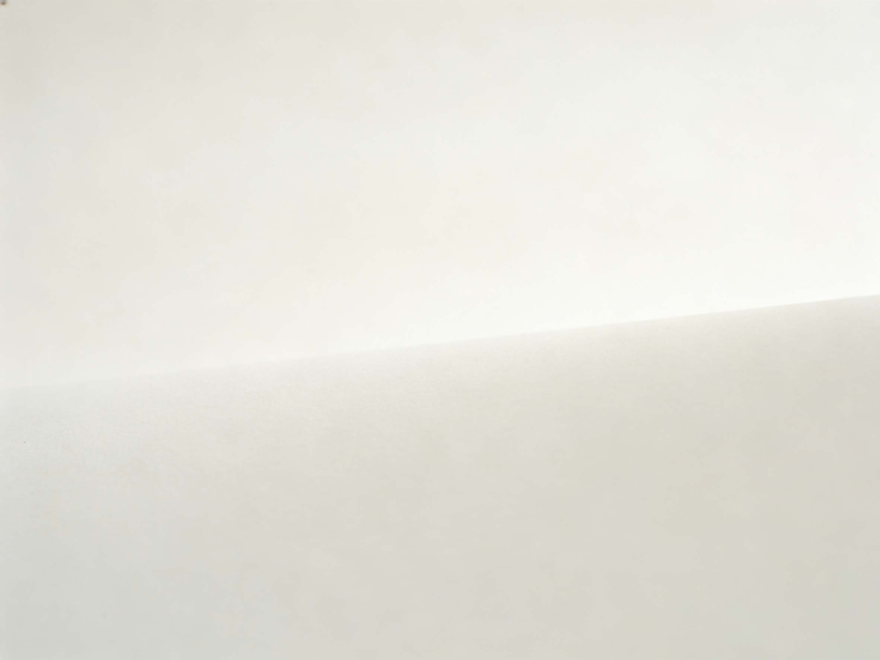
AboutUI/智能桌面魔方 二次元角色状态及菜单向导/高清/img_bg_report.jpg
