tianchuangya/SmartDesktopCube-IoT/AboutUI/智能桌面魔方 二次元角色状态及菜单向导/高清/img_boot_sleep.gif

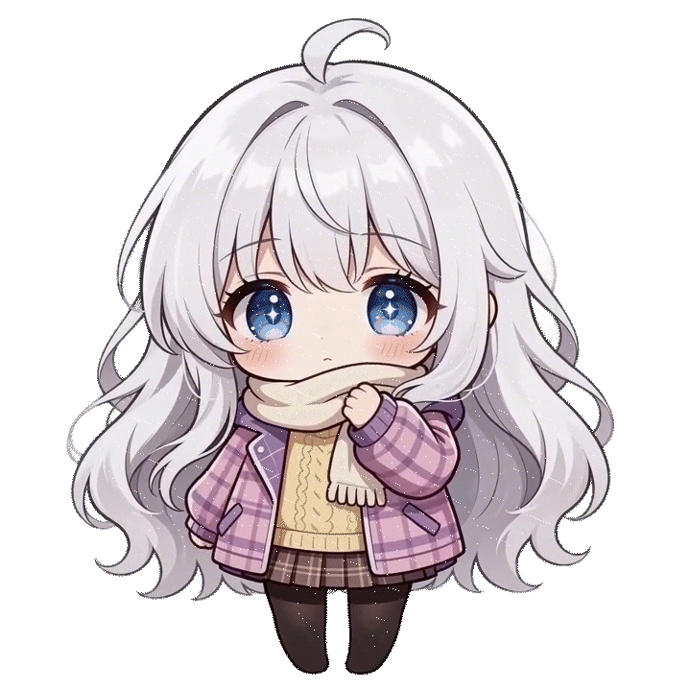
AboutUI/智能桌面魔方 二次元角色状态及菜单向导/高清/img_boot_sleep.gif
