tianchuangya/SmartDesktopCube-IoT/样例.png

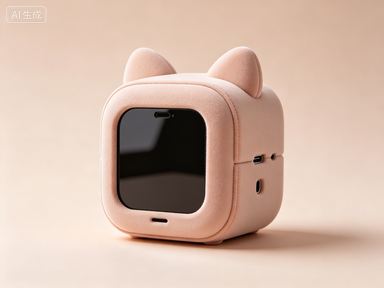
样例.png
