tianchuangya/SmartDesktopCube-IoT/(list of files, cad)

Other CAD files:
case_design/smart_cube_shell_v20_front_bezel_full_face.stl
case_design/smart_cube_shell_v4_body_typec_dc.stl
case_design/SmartDesktopCube_case_v20_package/preview/SmartDesktopCube_case_v20_all_parts_preview.stl
case_design/SmartDesktopCube_case_v20_package/print_parts_stl/02_front_bezel.stl
mzh51.stl
case_design/smart_cube_shell_v6_front_load_body.stl
case_design/SmartDesktopCube_case_v20_package/print_parts_stl/01_body.stl
case_design/smart_cube_shell_current_top_clear_lens_rollback_v12.stl
case_design/SmartDesktopCube_case_v20_package/print_parts_stl/03_side_slider.stl
case_design/smart_cube_shell_v10_body_air_light_ports.stl
case_design/SmartDesktopCube_case_v20_package/print_parts_stl/05_top_clear_lens_placeholder.stl
case_design/SmartDesktopCube_case_v20_package/print_parts_stl/04_back_cover.stl
case_design/smart_cube_shell_v13_body_true_screen_slide.stl
case_design/smart_cube_shell_v24_body_rear_wall_through_holes.stl
case_design/smart_cube_shell_current_body.stl
case_design/smart_cube_shell_v7_body_front_clamp_reinforced_ports.stl
case_design/smart_cube_shell_v25_back_cover_real_holes.stl
case_design/smart_cube_shell_v9_back_cover_reinforced_ports.stl
case_design/smart_cube_shell_v19_body_center_wire_opening.stl
case_design/smart_cube_shell_v14_back_cover_small_dc_port.stl
case_design/smart_cube_shell_v18_body_wire_relief.stl
case_design/smart_cube_shell_v8_web_dims_body.stl
case_design/smart_cube_shell_v20_body_real_top_side_vents.stl
case_design/smart_cube_shell_current_screen_side_cover_rollback_v12.stl
case_design/smart_cube_shell_v8_web_dims_front_bezel.stl
case_design/smart_cube_shell_v5_real_front_body.stl
case_design/smart_cube_shell_v14_screen_side_cover_one_piece.stl
case_design/smart_cube_shell_v20_back_cover_two_ports_vents.stl
case_design/smart_cube_shell_v25_front_bezel_real_holes.stl
case_design/smart_cube_shell_v15_side_simple_slider.stl
case_design/smart_cube_shell_v13_back_cover_rect_ports_vents.stl
case_design/smart_cube_shell_current_top_clear_lens.stl
case_design/smart_cube_shell_v3_back_cover.stl
case_design/smart_cube_shell_v8_web_dims_back_cover.stl
case_design/smart_cube_shell_v13_screen_slide_tray_with_wire_cover.stl
case_design/smart_cube_shell_v9_practical_body.stl
case_design/smart_cube_modular_insert_v1.stl
case_design/smart_cube_shell_v15_back_cover_two_ports.stl
case_design/smart_cube_shell_v25_top_clear_lens.stl
case_design/smart_cube_shell_v12_body_side_insert_screen.stl
case_design/smart_cube_shell_current_back_cover_rollback_v12.stl
case_design/smart_cube_shell_v16_body_simple_slot.stl
case_design/smart_cube_shell_v6_front_screen_bezel.stl
case_design/smart_cube_shell_v17_body_screen_entry.stl
case_design/smart_cube_shell_v25_side_simple_slider_vents.stl
case_design/smart_cube_shell_v4_back_cover_open_ports.stl
case_design/smart_cube_shell_v25_body_supported_upper_deck.stl
case_design/smart_cube_shell_v10_back_cover_ports_vents.stl
case_design/smart_cube_shell_current_screen_side_cover.stl
case_design/smart_cube_shell_current_back_cover.stl
case_design/smart_cube_fit_gauge_v3.stl
case_design/smart_cube_modular_insert_v2_compact.stl
case_design/smart_cube_shell_v3_body_adjustable.stl
case_design/smart_cube_shell_v4_back_cover_port_relief.stl
case_design/smart_cube_shell_v14_body_refined_v12.stl
case_design/smart_cube_shell_current_side_slider.stl
case_design/smart_cube_shell_v12_screen_side_lock_wire_cover.stl
case_design/smart_cube_shell_v11_body_rear_insert_wire_channel.stl
case_design/smart_cube_shell_current_body_rollback_v12.stl
case_design/smart_cube_shell_current_front_bezel.stl
case_design/smart_cube_shell_v11_front_screen_clamp_bezel.stl
case_design/smart_cube_shell_v7_back_cover_reinforced_open_ports.stl
case_design/SmartDesktopCube_case_v20_package/preview/SmartDesktopCube_case_v20_preview.blend
case_design/smart_cube_shell_current_preview.blend
case_design/smart_cube_shell_v10_air_light_ports_preview.blend
case_design/smart_cube_shell_v10_front_screen_clamp_bezel.stl
case_design/smart_cube_shell_v10_top_clear_lens.stl
case_design/smart_cube_shell_v11_back_cover_rect_ports_vents.stl
case_design/smart_cube_shell_v11_rear_insert_wire_channel_preview.blend
case_design/smart_cube_shell_v11_top_clear_lens.stl
case_design/smart_cube_shell_v12_back_cover_rect_ports_vents.stl
case_design/smart_cube_shell_v12_side_insert_screen_preview.blend
case_design/smart_cube_shell_v12_top_clear_lens.stl
case_design/smart_cube_shell_v13_top_clear_lens.stl
case_design/smart_cube_shell_v13_true_screen_slide_preview.blend
case_design/smart_cube_shell_v14_refined_v12_preview.blend
case_design/smart_cube_shell_v14_top_clear_lens.stl
case_design/smart_cube_shell_v15_body_simple_slot.stl
case_design/smart_cube_shell_v15_front_bezel_4screw.stl
case_design/smart_cube_shell_v15_simple_slot_preview.blend
case_design/smart_cube_shell_v15_top_clear_lens.stl
case_design/smart_cube_shell_v16_back_cover_two_ports_vents.stl
case_design/smart_cube_shell_v16_front_bezel_4screw.stl
case_design/smart_cube_shell_v16_side_simple_slider_vents.stl
case_design/smart_cube_shell_v16_top_clear_lens.stl
case_design/smart_cube_shell_v16_vented_simple_slot_preview.blend
case_design/smart_cube_shell_v17_back_cover_two_ports_vents.stl
case_design/smart_cube_shell_v17_front_bezel_full_face.stl
case_design/smart_cube_shell_v17_front_full_bezel_screen_entry_preview.blend
case_design/smart_cube_shell_v17_side_simple_slider_vents.stl
case_design/smart_cube_shell_v17_top_clear_lens.stl
case_design/smart_cube_shell_v18_back_cover_two_ports_vents.stl
case_design/smart_cube_shell_v18_front_bezel_full_face.stl
case_design/smart_cube_shell_v18_side_simple_slider_vents.stl
case_design/smart_cube_shell_v18_top_clear_lens.stl
case_design/smart_cube_shell_v18_wire_relief_preview.blend
case_design/smart_cube_shell_v19_back_cover_two_ports_vents.stl
case_design/smart_cube_shell_v19_center_wire_opening_preview.blend
case_design/smart_cube_shell_v19_front_bezel_full_face.stl
case_design/smart_cube_shell_v19_side_simple_slider_vents.stl
case_design/smart_cube_shell_v19_top_clear_lens.stl
case_design/smart_cube_shell_v20_real_top_side_vents_preview.blend
case_design/smart_cube_shell_v20_side_simple_slider_vents.stl
case_design/smart_cube_shell_v20_top_clear_lens.stl
case_design/smart_cube_shell_v21_back_cover_real_holes.stl
case_design/smart_cube_shell_v21_body_real_screw_holes.stl
case_design/smart_cube_shell_v21_body_real_screw_pilots.stl
case_design/smart_cube_shell_v21_front_bezel_real_holes.stl
case_design/smart_cube_shell_v21_real_screw_holes_preview.blend
case_design/smart_cube_shell_v21_side_simple_slider_vents.stl
case_design/smart_cube_shell_v21_top_clear_lens.stl
case_design/smart_cube_shell_v22_back_cover_real_holes.stl
case_design/smart_cube_shell_v22_body_rear_screw_holes.stl
case_design/smart_cube_shell_v22_front_bezel_real_holes.stl
case_design/smart_cube_shell_v22_rear_body_screw_holes_preview.blend
case_design/smart_cube_shell_v22_side_simple_slider_vents.stl
case_design/smart_cube_shell_v22_top_clear_lens.stl
case_design/smart_cube_shell_v23_back_cover_real_holes.stl
case_design/smart_cube_shell_v23_body_rear_screw_ring_boss.stl
case_design/smart_cube_shell_v23_front_bezel_real_holes.stl
case_design/smart_cube_shell_v23_rear_screw_ring_boss_preview.blend
case_design/smart_cube_shell_v23_side_simple_slider_vents.stl
case_design/smart_cube_shell_v23_top_clear_lens.stl
case_design/smart_cube_shell_v24_back_cover_real_holes.stl
case_design/smart_cube_shell_v24_front_bezel_real_holes.stl
case_design/smart_cube_shell_v24_rear_wall_through_holes_preview.blend
case_design/smart_cube_shell_v24_side_simple_slider_vents.stl
case_design/smart_cube_shell_v24_top_clear_lens.stl
case_design/smart_cube_shell_v25_supported_upper_deck_preview.blend
case_design/smart_cube_shell_v3_preview.blend
case_design/smart_cube_shell_v4_open_ports_preview.blend
case_design/smart_cube_shell_v4_preview.blend
case_design/smart_cube_shell_v5_preview.blend
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
