tianchuangya/SmartDesktopCube-IoT/AboutUI/智能桌面魔方 二次元角色状态及菜单向导/test.html

开机动画

启动中...

12:36 WiFi ✓

🌡️ 26°C | 💧 54% | ☀️ 320 lx

1

AQI

450

eCO₂ ppm

AI 建议：当前环境舒适

角色 😊

小魔方

🌬️ 空气质量

📊 环境数据

🧘 进入专注

⚙️ 设置

← 返回 空气质量详情

120

TVOC ppb

450

eCO₂ ppm

AQI 1 优

霉菌风险：低

← 返回 环境数据

🌡️ 温度: 26.3°C

💧 湿度: 54%

☀️ 光照: 320 lx

📡 TVOC: 120 ppb

🌫️ eCO₂: 450 ppm

← 退出专注 专注模式

00:00

台灯色温: 3000K 暖光

专注角色 😌

安静陪伴中...

模拟离开

← 返回 设置

亮度:

夜间模式

🔒 锁定设备

锁定后需远程解锁

锁定角色 😠

设备已锁定

远程解锁 (模拟)
