tianchuangya/SmartDesktopCube-IoT/日志/开发日志.txt

2026-5-23
屏幕触摸由IRQ判断换成压力值判断

2026-5-27
BH175模块初始化失败【已解决】
新增ui界面
2026-5-29
 1. DataPool.h — 数据结构调整
  - SensorData 新增 uint32_t focus_duration — 专注持续秒数的计数器
  - DeviceStatus 移除 focus_start_ms — 不再需要时间戳

  2. focus_mode.cpp — 全权管理 focus_duration（核心逻辑）
  - 进入专注：sensorData.focus_duration = 0，记录递增基准时刻
  - 退出专注：sensorData.focus_duration = 0
  - 专注中：每 1000ms 自增 sensorData.focus_duration++
  - 不再依赖 status.focus_start_ms

  3. MqttCom.cpp — MQTT 远程控制同步
  - MQTT 触发进入/退出时，同样重置 sensorData.focus_duration = 0

  4. custom.c — UI 直接读取，换算 HH:MM:SS
  - 原来：(millis() - focus_start_ms) / 1000 计算 MM:SS
  - 现在：直接读 sensorData.focus_duration，换算为 HH:MM:SS
  - 标签宽度从 200→240，适配8字符

6-17
✅ OTA 功能全部完成

  新建：OTAManager（HTTP流式下载+Flash写入+校验）、OTAScreen（锁屏进度UI）、partitions_8MB.csv（factory 3MB + ota_0 3MB + spiffs 2MB）
  修改：platformio.ini、DataPool、MqttCom（TLS+OTA指令回调）、main.cpp（注册OTA Task）、settingsScreen（检查更新按钮）
  流程：MQTT下发ota_update → 版本比对 → HTTP下载 → Update.write() → 校验重启
  触发：MQTT远程推送 + 设备手动检查更新
  后续：改FW_VERSION发新版 → 上传.bin到OSS → MQTT下发URL即可推送更新

7-12
✅ 全链路修复：启动→WiFi→内存→MQTT→NTP→传感器→UI，硬件完全跑通

  1. 启动死循环 — 板子8MB Flash但用16MB分区表，移除board_build.partitions用默认
  2. WiFi连接死循环 — WiFi.begin()异步需5~15s，旧代码每2.5s断开重来，加状态机15s超时重试
  3. LVGL内存 — 128KB静态buffer占内部RAM导致WiFi栈崩溃，LV_MEM_CUSTOM=1移到PSRAM（RAM 76%→36%）
  4. MQTT时序 — subscribe()后SUBACK未到就发握手，handshake_ack丢失。加loop+delay(300)等SUBACK；握手重试120s→10s；setBufferSize(512)
  5. NTP时间 — 失败后永不重试+超时太短，改为每30s重试+10s等待+configTzTime
  6. ENS160传感器 — 每次读调setTempAndHum干扰+异常无恢复，改每60s补偿+连续异常自动IDLE→STANDARD复位
  7. AQI — 1-5等级改为标准0-500+线性插值，eCO2/TVOC取更差
  8. UI envScreen — 标签更新覆盖名称，加回"温度:""湿度:"等前缀
  9. UI mainScreen — 左上角时间从未更新，加localtime()每200ms刷新
  10. MQTT调试 — 回调打印原始JSON，订阅三个topic（status/data/control）
  11. 版本号 — FW_VERSION加v前缀与后端对齐，OTA compareVersion兼容v前缀

7-12（晚）
✅ 新增 Web 管理后台 — 粒子效果可视化 Demo

  新建：web-dashboard/particle-demo.html（纯HTML单文件，无需任何依赖）

  功能：
  - 三栏粒子卡片：CO₂ / 湿度 / 温度，各一个独立Canvas粒子系统
  - CO₂：粒子数量随浓度动态变化（400ppm=6个粒子，2500ppm=60个粒子），颜色从青→橙→红渐变
  - 湿度：粒子大小随湿度变化（干燥=小粒子，潮湿=大粒子），固定25个粒子
  - 温度：粒子颜色随温度渐变（冷=蓝紫，舒适=暖黄，热=橙红）
  - 粒子行为：从中心向外辐射扩散，越靠近边缘越透明+模糊，生命周期结束后在中心重生
  - 中心标签：始终清晰的"CO₂""湿度""温度"文字 + 实时数值
  - 底部滑块：手动模拟环境数据变化，直观感受粒子效果
  - 鼠标悬停：粒子轻微跟随鼠标，增强交互感

  设计理念：
  - "一眼感知"：不需要读数字，粒子密集=空气差，粒子稀疏=空气好
  - 三种数据各有不同映射方式（数量/大小/颜色），避免视觉单调
  - 暗色主题 + 渐变光晕，符合IoT设备管理后台调性

  后续计划：
  - 接入MQTT/WebSocket实时数据（替代滑块模拟）
  - 多设备切换视图
  - 历史数据图表叠加

7-13
✅ 灯光方案升级：BLE+MOS → Yeelight 1S

  原方案：ESP32 → BLE → ESP32-C3 → PWM → MOS模块 → 灯带（6环节，需焊接接线）
  新方案：ESP32 → HTTP GET → Yeelight 1S（1环节，即插即用）

  Yeelight 1S 参数：
  - 色温 2700K-6500K，亮度 1%-100%，与项目预设模板完全匹配
  - 公开 LAN Control Protocol，HTTP 请求即可控制
  - 与专注模式联动：进入专注→暖光，退出→恢复

✅ Web 前端重构：分块加载 + 数字孪生两阶段转场

  设计原则：苹果风格"轻、慢、干净"，transform+opacity 为主，避免 blur 和 layout 重排

  主页面加载：
  - 左侧导航栏从左往右展开
  - Logo/导航项/用户区依次淡入
  - 顶部栏从上方轻微下落
  - 主内容区整体淡入上浮
  - 控制台卡片从下往上分批浮现（staggered）

  数字孪生控制面板（两阶段）：
  第一阶段：点击设备卡 → 模型放大移动到面板中央
  第二阶段：模型落位后 → 返回按钮/标题/左右面板分块出现

  返回控制台：面板内容先隐藏 → 模型平滑回到卡片 → 卡片恢复正常

7-13（晚）
✅ 粒子可视化 Demo 重构 + 文档全面优化

  粒子 Demo 重构：
  - 从"径向扩散"改为"全屏随机漂浮"，粒子布朗运动（随机加速度+速度阻尼）
  - 中心大字显示数据名称（CO₂/湿度/温度），半透明遮罩保护文字可读
  - 粒子数量平滑过渡（EMA），200+粒子60fps稳定运行

  系统方案文档重写（场景故事驱动）：
  - 旧文档：功能列表罗列 + 大量已割除功能（音频/红外/蓝牙Mesh/SD卡）混杂
  - 新文档：用户的一天（四个场景故事：早晨苏醒→专注工作→远程查看→离开锁定）
  - 边缘AI PM2.5预测从"扩展"升级为核心亮点（第四章第一节重点展开）
  - 灯光方案更新为Yeelight 1S，去掉已割除的音频/红外/蓝牙Mesh
  - 保留已实现：传感器/边缘AI/虚拟IP/专注模式/双核安全锁/粒子可视化/MQTT

  新建功能规格说明书（专业技术文档）：
  - 七章已实现功能：硬件规格→传感器参数→软件功能→系统架构→通信协议→性能指标→版本信息
  - 补全遗漏功能：开机动画（bootScreen 5帧）、锁屏界面（lockScreen）、MQTT握手协议（handshake→token）
  - OTA从"规划中"移至"已实现（框架）"：OTAManager+OTAScreen+FreeRTOS任务已搭建
  - 专注模式可配置参数（FocusConfig_t 7个参数）、图片资源池（ImagePool_t 6类资源）
  - 第八章11项规划中功能（微信告警/一主多从/开机自检/霉菌风险/红外/音频/SD卡/云端AI等）

  非阻塞异步联网架构确认：
  - WiFiManager状态机（15s超时）+ Task_Network独立任务（500ms轮询）
  - MqttReconnectTask独立任务（50ms消息收发）
  - NTP非阻塞轮询（30s重试）
  - 断网离线模式：本地功能不受网络影响

7-16
✅ Blinker App 集成 + NTP 断网时间修复 + LVGL 过渡动画

  Blinker App 物联网云平台集成（直连协议，不用 Blinker 库）：
  - 新建：BlinkerApp.h / BlinkerApp.cpp — 独立模块，直连实现 Blinker MQTT 协议
  - 不用 Blinker 库原因：blinker-library 自带旧版 ArduinoJson 与项目 v7.x 冲突无法编译
  - 协议实现：HTTPS 认证 iot.diandeng.tech 获取动态凭证 → 独立 PubSubClient 连 Blinker broker
  - 控件：bnt-light(按钮), ran-liangdu(亮度), ran-sewen(色温), num-wendu/shidu/eco2/pm25/lx/ppb(6个数值)
  - 合并发送：9 个控件打包到 1 条 MQTT publish，减少 TCP 开销
  - 安全设计：断网自动跳过，独立 WiFiClient 不干扰主 MQTT，setSocketTimeout(2) 防看门狗
  - 接收回调：App 端按钮/滑块指令直接调用 BL_TurnOn/Off/SetBrightness/SetColorTemp
  - 数据推送：2 秒一次，独立于 MQTT 服务器上报（MQTT 2 秒，Blinker 2 秒，错开执行）
  - 坑1：auth 返回 host 带 mqtts:// 前缀 → PubSubClient DNS 失败，需剥离协议前缀
  - 坑2：protocol=mqtts 返回 TLS broker，明文 WiFiClient 发 CONNECT 不回 CONNACK → 看门狗崩溃，改 protocol=mqtt
  - 坑3：PubSubClient 默认 socketTimeout=15 秒，connect() 阻塞太久 → IDLE0 喂狗饿死 → setSocketTimeout(2)
  - 坑4：BlinkerApp_Init() 被 MqttReconnectTask 每轮调用 → 串口刷屏，加 b_inited 防重复

  NTP 断网时间修复：
  - DataPool.h 新增 bool time_synced — NTP 同步标志，断网后仍保持 true
  - WiFiManager.cpp syncTimeOnce() 成功后设置 status.time_synced = true
  - custom.c 时间显示判断从 tm_year>=126 改为 status.time_synced — ESP32 内部 RTC 断网后继续走时

  LVGL 过渡动画：
  - 新建：ui_animations.h / ui_animations.c — 屏幕切换淡入 + 控件逐级加载
  - 修改：events_init.c — switch_to_screen 改用 LV_SCR_LOAD_ANIM_FADE_ON + SCREEN_LOADED 回调
  - 参数：OFFSET=20px, DURATION=300ms, STEP=70ms, ease_out 曲线

  串口调试信息清理：
  - BlinkerApp.cpp 移除所有 Serial 打印（认证/连接/接收/发送日志全部关闭）
  - MqttReconnectTask.cpp 移除所有 Serial 打印（重连/握手/心跳/上报日志全部关闭）
  - 目的：减少 Core 0 串口 I/O 阻塞，提升硬件 UI 流畅度

7-17
✅ 微信报警通知功能

  BlinkerApp 新增微信推送 + 自动报警检测：
  - 新增：BlinkerApp_SendWechat(title, state, message) — 通过 Blinker HTTP API 发送微信模板消息
  - 协议：HTTP POST 到 iot.diandeng.tech/api/v1/user/device/wxMsg/，JSON body 含 deviceName/key/title/state/msg/receivers
  - 新增：BlinkerApp_CheckAlarms() — 10 秒检查一次传感器数据，超阈值自动发微信报警
  - 8 项报警，各自独立冷却 2 分钟（Blinker 服务端限制 60s/条）：
    1. AQI ≥ 300 → "AQI值过高(XXX)，请注意室内通风"（严重）
    2. 温度 ≥ 45°C → "室内温度过高，目前XX°C，疑似火灾！"（紧急）
    3. 温度 ≤ 5°C → "室内温度过低，目前XX°C"（提醒）
    4. 湿度 ≥ 85% → "室内湿度过高，当前XX%，注意防潮"（提醒）
    5. 湿度 ≤ 20% → "室内湿度过低，当前XX%，注意保湿"（提醒）
    6. PM2.5 ≥ 150 μg/m³ → "PM2.5浓度超标，请通风或佩戴口罩"（严重）
    7. eCO2 ≥ 2000 ppm → "CO2浓度过高，请开窗通风"（严重）
    8. TVOC ≥ 2200 ppb → "TVOC浓度过高，注意室内空气"（严重）
  - 断网时自动跳过，不影响其他功能
  - MqttReconnectTask 集成：last_alarm 独立 10 秒计时

  功能规格说明书更新：
  - 新增 3.7.6 节"微信报警通知"：推送方式、模板格式、检测周期、报警阈值表（4列9行）

7-17
✅ 灯光方案升级：BLE + ESP32-C3 → Yeelight 1S 直连

  背景：原方案 ESP32 → BLE → ESP32-C3 → PWM → MOS → 灯带（6 级链路，需焊电路）
  新方案：ESP32 → WiFi → Yeelight 1S（1 步直连，即插即用）

  BluetoothLight.cpp 重写（API 不变，底层全换）：
  - 移除 NimBLE 库依赖，新增 WiFiClient TCP 通信
  - 协议：Yeelight LAN Control Protocol（TCP 55443 端口，JSON-RPC）
  - 命令：set_power(开关), set_bright(亮度 1-100), set_ct_abx(色温 2700-6500K)
  - SSDP 自动发现：M-SEARCH 多播 239.255.255.250:1982，解析 Location 头获取 IP
  - 也支持硬编码 IP（YEELIGHT_IP 宏，留空则自动搜索）
  - 后台任务 Core 1，200ms 周期，5 秒重连
  - 非阻塞 API 不变：BL_SetBrightness/SetColorTemp/TurnOn/TurnOff/PresetWarm/Cool/White
  - BlinkerApp、UI 滑块、专注模式联动无需修改

  移除文件依赖：
  - platformio.ini 移除 h2zero/NimBLE-Arduino@^2.1.2
  - 不再需要 ESP32-C3 灯光控制器（esp32c3_light_controller 目录保留作参考）

  UI 更新：
  - events_init.c 状态文字 "BLE: connected" → "Light: connected"
  - setup_scr_settingsScreen.c 初始文字 "BLE: checking..." → "Light: checking..."
  - Toast 提示更新为 "Check Yeelight power & WiFi"

  资源节省：
  - RAM: 36.2% → 34.3%（省 6KB）
  - Flash: 84.9% → 79.2%（省 178KB）

  使用前提：
  - 米家 App 绑定 Yeelight 灯带 1S
  - 开启「局域网控制」
  - Yeelight 与 ESP32 同一 WiFi
