tianchuangya/SmartDesktopCube-IoT/日志/变更日志_20260619.md

# Smart Desktop Cube IoT — 变更日志 2026-06-19

## 一、变更概述

本次改动围绕一条主线：**PM2.5 AI 预测模型集成** — 将朋友训练好的 LightGBM 模型转换并部署到 ESP32-S3，利用现有传感器（AHT20温湿度 + ENS160 CO2/TVOC）实时预测 PM2.5 浓度，无需额外硬件。

核心挑战：
- LightGBM 模型文件为文本格式（2.8MB / 1000棵树），无法直接在 ESP32 上加载
- ESP32 无 Python 运行时、无 LightGBM 动态库支持
- 需要将模型"编译"成纯 C 数据结构，并实现高性能树遍历推理

解决方案：编写 Python 脚本提取 LightGBM 模型的全部决策树结构，生成为 C 常量数组（存入 ESP32 Flash），再在设备端实现 0-dependency 的树遍历推理引擎。

---

## 二、新增文件

| # | 文件 | 说明 |
|---|---|---|
| 1 | `SmartDesktopCube-IoT-model/convert_model_to_c.py` | ⭐ Python 模型→C代码转换脚本（可复用） |
| 2 | `SmartDesktopCube-IoT-model/verify_fix.py` | 验证脚本：对比手动C遍历 vs LightGBM库预测（确认一致） |
| 3 | `src/pm25_model_data.h` | ⭐ 自动生成：1000棵树的结构数据（threshold/feature/left/right/leaf），~330KB Flash |
| 4 | `src/PM25Predictor.h` | PM2.5 预测模块头文件 |
| 5 | `src/PM25Predictor.cpp` | PM2.5 预测模块实现（纯C遍历1000棵决策树，<1ms） |

---

## 三、修改文件

| # | 文件 | 改动类型 | 修改内容 |
|---|---|---|---|
| 1 | `src/DataRW.cpp` | 功能增强 | 新增 `#include "PM25Predictor.h"`；传感器读取后调用 `pm25Predict(temp, eco2, tvoc, humi)` 存入 `sensorData.pm25`；任一传感器离线时 pm25=-1 |
| 2 | `src/MqttCom.cpp` | 功能增强 | `mqttSendDataReport()` 的 JSON 中新增 `"pm25"` 字段，上报 AI 预测值 |
| 3 | `src/ui/custom/custom.c` | 功能增强 | `envScreen` 定时刷新新增 PM2.5 标签更新：`"PM2.5: xx.x ug/m3"` |

---

## 四、技术细节

### 4.1 LightGBM → C 转换原理

LightGBM 模型文件（`pm25_predictor_4features_fold.txt`）结构：
- 1000 棵树，每树 `num_leaves=31`（30个内部节点 + 31个叶子）
- 每节点：`split_feature`（0-3）、`threshold`、`left_child`、`right_child`
- 每叶子：`leaf_value`（预测值）

转换为 5 个 C 常量数组：
```
pm25_thresholds[1000][30]   — float, 每个分裂节点的阈值
pm25_features[1000][30]     — uint8_t, 每个节点使用哪个特征
pm25_left[1000][30]         — int8_t, 左子节点索引（<0=叶子）
pm25_right[1000][30]        — int8_t, 右子节点索引
pm25_leaves[1000][31]       — float, 叶子预测值
```

所有数组标注 `PROGMEM`，存入 Flash（ESP32 MMU 直接映射读取）。

### 4.2 关键发现：leaf_value 已含学习率

调试过程中发现：LightGBM 模型文件中 `leaf_value` **已经乘过了学习率（shrinkage）**，预测时直接累加即可。不能再次乘以 `shrinkage`，否则会双重缩放导致预测值严重偏差。

验证：4组测试数据的 LightGBM 库预测 vs 手动C遍历结果 **完全一致（diff < 0.000001）**。

### 4.3 子节点索引约定

```
child >= 0  → 内部节点，直接 0-based 索引到数组位置
child < 0   → 叶子节点，-1 → leaf[0], -2 → leaf[1], ...
```

### 4.4 模型参数

- 模型类型：LightGBM 梯度提升回归树
- 特征数量：4（temperature, co2, tvoc, humidity）
- 特征范围：
  - 温度：18.33 ~ 24.61 °C
  - CO2：424.95 ~ 908.56 ppm
  - TVOC：0 ~ 4568.4 ppb
  - 湿度：26.76 ~ 66.86 %
- 树数量：1000
- Flash 占用：~330 KB

### 4.5 性能

- ESP32-S3 @240MHz，1000棵树遍历 < 1ms
- 每 500ms 调用一次（随 `DataRead_ReadAll` 周期）
- 使用 `pgm_read_byte` / `pgm_read_float` 从 Flash 读取
- 无堆内存分配（纯栈变量）

---

## 五、数据流

```
AHT20(温湿度) + ENS160(CO2/TVOC)
        │ 每500ms
        ▼
   DataRead_ReadAll()
        │
        ▼
   pm25Predict(temp, eco2, tvoc, humi)  ← AI推理（1000棵树）
        │
        ▼
   sensorData.pm25
        │
        ├── MQTT 上报 → 服务器 (data_report JSON)
        └── LVGL UI  → envScreen "PM2.5: xx.x ug/m3"
```

---

## 六、如何使用 / 更新模型

如果朋友重新训练了模型：

```bash
# 1. 把新模型文件放到 model 目录
cp 新模型.txt SmartDesktopCube-IoT-model/pm25_predictor_4features_fold.txt

# 2. 运行转换脚本
cd SmartDesktopCube-IoT-model
python convert_model_to_c.py

# 3. 复制到项目
cp pm25_model_data.h ../SmartDesktopCube-IoT/Smart\ Desktop\ Cube\ IoT/src/

# 4. 重新编译固件（PlatformIO Upload）
```

---

## 七、预测示例

| 温度 | CO2 | TVOC | 湿度 | 预测 PM2.5 | 场景 |
|---|-----|---|---|---|---|
| 22.5°C | 600 | 500 | 55% | -0.09 | 低污染 |
| 20.5°C | 450 | 100 | 40% | 0.20 | 良好 |
| 24.0°C | 800 | 2000 | 65% | 16.73 | 高TVOC需注意 |
| 19.0°C | 500 | 50 | 30% | 0.19 | 良好 |

> ⚠ 超出训练数据范围时预测可能不准，注意特征范围限制。

---

## 八、相关文件路径

- 模型目录：`C:\Users\ASUS\Desktop\SmartDesktopCube-IoT-model\`
- IoT 项目：`C:\Users\ASUS\Desktop\SmartDesktopCube-IoT\SmartDesktopCube-IoT\Smart Desktop Cube IoT\`
- 模型文件：`pm25_predictor_4features_fold.txt`（2.8MB 文本格式）
- 转换脚本：`convert_model_to_c.py`
- 验证脚本：`verify_fix.py`
- C 模型数据：`src/pm25_model_data.h`（自动生成）
- 预测模块：`src/PM25Predictor.cpp` / `src/PM25Predictor.h`

---

*日志最后更新: 2026-06-19*
*Co-Authored-By: Claude <noreply@anthropic.com>*
