tianchuangya/SmartDesktopCube-IoT/日志/开发日志_2026-07-20.md

# 开发日志 - 2026-07-20

## 项目：SmartDesktopCube-IoT（智能桌面魔方 IoT）

---

## 一、硬件端UI修复

### 1.1 删除"Air quality poor!"告警横幅

- 彻底删除该告警横幅功能：
  - `setup_scr_mainScreen.c`：删除横幅控件的创建代码
  - `custom.c`：删除横幅的显示/隐藏逻辑

### 1.2 修复"XiaoMian"名字被截断问题

- **问题**：名字显示为"XiaoMia"，末尾字母被截断
- **原因**：label宽度不足（50px）
- **修复**：
  - label宽度从 50px 加到 70px
  - x起点从 16 调整到 6

---

## 二、OTA进度条修复（核心Bug）

### 问题描述

OTA任务运行在 Core 1，直接调用 LVGL 函数（`otaScreenShow` / `otaScreenUpdateProgress`）。但 LVGL 不是线程安全的，只能从 LVGL 定时器任务（LVGL timer task）中调用。导致进度条虽然代码写了，但根本渲染不出来。

### 修复方案

| 文件 | 修改内容 |
|---|---|
| `OTAManager.cpp` | OTA任务不再调用任何LVGL函数，改为只更新共享字段：`status.ota_in_progress` / `ota_progress` / `ota_status_text` |
| `custom.c` | LVGL定时器每帧检查 `status.ota_in_progress`，在正确的线程上下文中调用 `otaScreenShow()` / `otaScreenUpdateProgress()` 渲染进度 |
| `OTAManager.cpp` | 移除对 `OTAScreen.h` 的依赖 |

### 核心原则

> LVGL 函数只能从 LVGL 定时器任务调用，其他任务通过共享状态通信。

---

## 三、OTA期间任务暂停机制

OTA下载/写入Flash期间，暂停其他任务以保证系统稳定性和带宽：

| 任务 | 文件 | 暂停方式 |
|---|---|---|
| 雷达 + 专注模式状态机 | `Task_Control.cpp` | 200ms sleep 循环 |
| 传感器采集 | `Task_DataRead` | 500ms sleep 循环 |
| 数据上报 / Blinker推送 / 心跳 | `MqttReconnectTask.cpp` | 跳过执行，但保持MQTT连接（用于OTA状态上报） |
| 自动亮度 / 告警 / 历史数据 | `LocalIntelligence.cpp` | 1000ms sleep 循环 |

---

## 四、网页端固件更新功能

### 4.1 新增"固件更新"卡片

- 显示当前固件版本号
- "检测更新"按钮

### 4.2 检测流程

```
点击"检测更新" → MQTT发送 version_check → 后端回复 ota_update
  ├── code: 200 → 有新版本，网页显示版本信息
  └── code: 204 → 已是最新版本
```

### 4.3 确认流程

```
发现新版本 → 显示"确认更新 / 暂不更新"按钮
  → 用户点击"确认更新" → OTA开始 → 网页实时显示进度百分比
```

### 4.4 超时与异常处理

- 5秒无响应：显示"已是最新版本"
- MQTT未连接：显示"检测失败"

### 4.5 新增API命令

- `check_update` — 触发版本检测
- `confirm_update` — 确认开始OTA
- `dismiss_update` — 取消/关闭更新提示

### 4.6 /api/data 新增字段

- `fw_version` — 当前固件版本
- `ota_in_progress` — OTA是否进行中
- `ota_progress` — OTA进度百分比
- `ota_update_available` — 是否有可用更新
- `ota_pending_version` — 待更新版本号
- `ota_check_status` — 检测状态

---

## 五、OTA协议设计

### 设计原则

> **设备不自动更新！所有OTA触发权交给网页端用户。**

### 5.1 新增 DataPool 字段

- `ota_update_available` — 是否有待确认的更新
- `ota_pending_url[256]` — 待更新固件URL
- `ota_pending_version[32]` — 待更新版本号
- `ota_pending_md5[33]` — 待更新固件MD5校验
- `ota_check_status` — 版本检测状态
- `ota_check_time` — 检测时间戳

### 5.2 MQTT消息处理

- `MqttCom.cpp`：收到 `ota_update` 消息时检查 `code` 字段：
  - `200` = 有新版本，存储URL/版本/MD5，等待用户确认
  - `204` = 已是最新版本

### 5.3 协议格式文件

- 新增：`协议格式/版本检查请求协议.json`
- 新增：`协议格式/OTA更新推送协议.json`
- 更新：`协议格式/MQTT 握手请求协议.json`（type列表新增：`version_check` / `ota_update` / `control` / `control_ack` / `ota_status`）

---

## 六、版本号

- 当前固件版本：**v1.0.0**
- 定义位置：`DataPool.h` 中 `FW_VERSION` 宏
- 显示位置：
  - 硬件屏幕左下角
  - 数字孪生网页页面

---

## 修改文件清单

| 文件路径 | 修改说明 |
|---|---|
| `src/DataPool.h` | 新增OTA待确认字段、check_status |
| `src/DataPool.cpp` | 初始化新字段 |
| `src/OTAManager.cpp` | 重写otaTaskFunc，移除所有LVGL直接调用，改用共享状态 |
| `src/MqttCom.cpp` | ota_update处理改为存储待确认 + code判断 |
| `src/MqttReconnectTask.cpp` | OTA暂停 + 检测超时机制 |
| `src/Task_Control.cpp` | OTA期间暂停雷达和传感器 |
| `src/LocalIntelligence.cpp` | OTA期间暂停智能决策 |
| `src/WebServerTask.cpp` | 固件更新UI + API |
| `src/ui/custom/custom.c` | OTA进度渲染(LVGL安全) + 删除告警横幅逻辑 |
| `src/ui/generated/setup_scr_mainScreen.c` | 删除告警横幅 + 加宽XiaoMian label + 版本号 |
| `协议格式/版本检查请求协议.json` | **新增** |
| `协议格式/OTA更新推送协议.json` | **新增** |
| `协议格式/MQTT 握手请求协议.json` | 更新type列表 |

---

## 七、启动流程重构（黑色背景 + 模块加载）

### 7.1 需求

- 启动画面背景改为纯黑色
- 启动期间加载所有传感器模块，每个模块5次重试
- 模块加载期间持续显示启动画面（小眠图片 + 状态文字）
- 所有模块加载完成后自动过渡到主界面

### 7.2 实现方案：两阶段初始化

| 阶段 | 函数 | 内容 | 耗时 |
|---|---|---|---|
| Phase 1 | `Device_InitDisplay()` | Serial + LVGL + 触摸 + UI setup | ~1s |
| Phase 2 | `Device_InitModules()` | BH1750 → AHT20 → ENS160 → Radar（各5次重试） | 2~12s |

### 7.3 启动时序

```
setup()
  ├── Device_InitDisplay()     ← 快速，启动画面立即渲染
  ├── Task_LVGL_Init()         ← LVGL任务启动，定时器开始轮询
  ├── Task_ModuleLoader        ← 后台任务调用 Device_InitModules()
  │     ├── BH1750 (5 retries)
  │     ├── AHT20  (5 retries)
  │     ├── ENS160 (5 retries)
  │     └── Radar  (5 retries)
  │     └── status.modules_ready = true
  └── 其他任务（网络/MQTT/OTA/Web）

LVGL定时器 (500ms):
  boot_to_main_cb() → 检查 status.modules_ready → 切换到 mainScreen
```

### 7.4 修改文件

| 文件 | 修改内容 |
|---|---|
| `src/DeviceInit.h` | 新增 `Device_InitDisplay()` / `Device_InitModules()` 声明 |
| `src/DeviceInit.cpp` | 拆分为两阶段，Phase2每模块5次重试 + 更新 `boot_status_text` |
| `src/main.cpp` | 先InitDisplay→启动LVGL→创建ModuleLoader任务→再初始化网络 |
| `src/DataPool.h` | 新增 `modules_ready` / `boot_status_text[32]` 字段 |
| `src/DataPool.cpp` | 初始化新字段 |
| `src/ui/custom/custom.c` | boot_to_main_cb改为500ms轮询；ui_refresh_timer_cb更新启动文字 |
| `src/ui/generated/setup_scr_bootScreen.c` | 背景改纯黑(0x000000) + 文字改白色(0xFFFFFF) |

---

## 编译状态

- **PlatformIO 编译通过**
- RAM: 35.4%（116,092 / 327,680 bytes）
- Flash: 76.9%（2,417,965 / 3,145,728 bytes）

---

## 今日总结

今天完成了OTA固件更新功能的完整闭环：从协议设计、设备端实现、线程安全修复、任务暂停机制，到网页端交互界面。核心解决了LVGL线程安全问题（进度条无法渲染的Bug），并确立了"用户确认制"的OTA更新策略。同时修复了两个UI显示问题。最后重构了启动流程：黑色背景启动画面 + 两阶段初始化（先显示后加载），每个传感器模块5次重试，加载期间实时显示进度文字，全部完成后自动过渡到主界面。
