tianchuangya/SmartDesktopCube-IoT/AboutUI/smart_cube/lvgl-simulator/build_log.txt

"Compiling C:/NXP/GUI-Guider-Projects/test1/lvgl-simulator/main.c"
C:\NXP\GUI-Guider-1.10.1-GA\environment\mingw\bin\mingw32-make.exe : main.c:20:10: fatal error: custom.h: No such file 
or directory
所在位置 行:1 字符: 1
+ C:\NXP\GUI-Guider-1.10.1-GA\environment\mingw\bin\mingw32-make.exe 2> ...
+ ~~~~~~~~~~~~~~~~~~~~~~~~~~~~~~~~~~~~~~~~~~~~~~~~~~~~~~~~~~~~~~~~~~~~~
    + CategoryInfo          : NotSpecified: (main.c:20:10: f...le or directory:String) [], RemoteException
    + FullyQualifiedErrorId : NativeCommandError
 
   20 | #include "custom.h"
      |          ^~~~~~~~~~
compilation terminated.
Makefile:95: recipe for target 'build/object/main.o' failed
mingw32-make: *** [build/object/main.o] Error 1
