tianchuangya/SmartDesktopCube-IoT/Smart Desktop Cube IoT/src/DataPool.cpp

#include "DataPool.h"
#include "secrets.h"

// 全局数据池初始化
SensorData sensorData = {
  .temp = -1.0f,
  .humi = -1.0f,
  .tvoc = -1.0f,
  .eco2 = -1.0f,
  .light = -1.0f,
  .pm25 = -1.0f,
  .aqi = 0,
  .human_duration = 0
};

// WiFi 默认配置
WiFiConfig_t wifi_config = {
  WIFI_DEFAULT_SSID,
  WIFI_DEFAULT_PWD
};

FocusConfig_t focusConfig = {
    .radar_max_distance   = 60,    // 1.5米
    .radar_sensitivity    = 5,      // 中等灵敏度
    .leave_timeout_ms     = 5000,   // 5秒
    .auto_enter_delay_ms  = 5000,   // 5秒
    .human_distance       = 0,       // 检测到的人体距离（cm），无人时为0
    .is_human_exist       =false,   // 是否有人
    .auto_enter_enabled   = false,  // 默认关闭自动进入
    .auto_exit_enabled    = true,   // 默认启用自动退出
    .focus_cooldown_ms    = 30000,  // 手动退出后30秒冷却期
    .last_manual_exit_ms  = 0       // 初始不在冷却期
};

DeviceStatus status = {
  .wifi_connected = false,
  .mqtt_connected = false,
  .is_human_exist = false,
  .screen_brightness = 100,
  .sensor_bh1750 = false,
  .sensor_aht21 = false,
  .sensor_ens160 = false,
  .boot_time = 0,
  .run_seconds = 0,
  .focus_mode=false,
  .device_lock=false,
  .request_focus_screen=false,
  .on_main_screen=true,  // 启动时在mainScreen
  .ota_in_progress=false,
  .ota_progress=0,
  .ota_new_version={0},
  .ota_status_text={0},
  .ota_check_requested=false,
  .ota_check_status=0,
  .ota_check_time=0,
  .ota_update_available=false,
  .ota_pending_url={0},
  .ota_pending_version={0},
  .ota_pending_md5={0},
  .air_quality_alert=false,
  .pending_wechat_air=false,
  .temp_comfort_alert=false,
  .auto_brightness_enabled=true,
  .silent_mode=false,
  .pending_toast={0},
  .toast_pending=false,
  .toast_duration_ms=0,
  .focus_summary_text={0},
  .focus_summary_pending=false,
  .co2_trend_text={0},
  .modules_ready=false,
  .boot_status_text={0}
};

CommandData cmd = {
  "",          // speak_text
  0,           // player_cmd
  0,           // aircon_mode
  25           // target_temp
};

SecurityData security = {
    "CUBE001",  // did（JSON 消息中的设备标识）
    "",         // mqtt_client_id（MAC 地址生成，mqttInit 时填充）
    "",         // token
    false,      // token_ok
    0           // token_expire_time（0=未设置）
};

ImagePool_t img = {

    //角色状态图片
    .role = {
        .normal    = nullptr,  // 正常微笑
        .remind    = nullptr,  // 提醒
        .alert     = nullptr,  // 告警
        .focus     = nullptr,  // 专注
        .celebrate = nullptr,  // 点赞
        .guide     = nullptr   // 菜单向导
    },

    //AQI 5 级背景
    .aqi = {
        .aqi_1 = nullptr,  // 优
        .aqi_2 = nullptr,  // 良
        .aqi_3 = nullptr,  // 中
        .aqi_4 = nullptr,  // 差
        .aqi_5 = nullptr   // 劣
    },

    //开机启动动画
    .boot = {
        .sleep   = nullptr,  // 睡觉
        .wake_1  = nullptr,  // 苏醒1
        .wake_2  = nullptr,  // 苏醒2
        .welcome = nullptr,  // 欢迎
        .logo    = nullptr   // LOGO
    },

    //界面背景
    .bg = {
        .main    = nullptr,  // 主界面
        .focus   = nullptr,  // 专注模式
        .menu    = nullptr,  // 菜单
        .report  = nullptr,  // 报告
        .setting = nullptr   // 设置
    },

    //UI 菜单/选项卡
    .ui = {
        .tab_air = nullptr,  // 空气质量
        .tab_env = nullptr,  // 环境
        .tab_time= nullptr,  // 计时
        .tab_set = nullptr,  // 设置
        .btn_back= nullptr,  // 返回
        .btn_ok  = nullptr   // 确认
    },

    //专注模式图片
    .focus = {
        .focus_start   = nullptr,  // 开始专注
        .focus_running = nullptr,  // 专注中
        .focus_end     = nullptr   // 结束
    }
};

// 传感器历史记录初始化（环形缓冲区）
SensorHistory sensorHistory = {
    .temp = {0},
    .humi = {0},
    .light = {0},
    .eco2 = {0},
    .history_index = 0,
    .history_count = 0
};

// 专注会话记录初始化
FocusSession_t focusSession = {
    .start_time = 0,
    .duration_sec = 0,
    .temp_sum = 0.0f,
    .humi_sum = 0.0f,
    .eco2_sum = 0.0f,
    .sample_count = 0,
    .last_break_suggest = 0,
    .quality_score = 0,
    .active = false
};
