tianchuangya/SmartDesktopCube-IoT/Smart Desktop Cube IoT/src/MqttCom.h

#ifndef MQTT_COM_H
#define MQTT_COM_H
#include <Arduino.h>
#include <WiFiClient.h>
#include <PubSubClient.h>
#include <WiFi.h>

// MQTT 服务器配置（公共 EMQX Broker）
#define MQTT_SERVER "broker.emqx.io"
#define MQTT_PORT   1883
#define MQTT_USER   ""
#define MQTT_PASS   ""

// 全局客户端对象（非 TLS 明文连接）
extern WiFiClient wifiClient;
extern PubSubClient mqtt;

// 初始化（设置服务器/回调，不连接）
void mqttInit();

// 生成 MAC 地址的 Client ID（格式: cube_AABBCCDDEEFF），存入 security.mqtt_client_id
void mqttGenerateClientId();

// 带超时的连接（阻塞最多 timeout_ms 毫秒，内部使用 vTaskDelay 让出 CPU）
bool mqttConnect(uint32_t timeout_ms = 3000);

// 断开
void mqttDisconnect();

// 订阅
bool mqttSubscribe(const char* topic);

// 发布
bool mqttPublish(const char* topic, const char* payload);

// 状态查询
bool mqttIsConnected();

// 运行循环（处理接收，无阻塞）
void mqttLoop();

// 握手、心跳、数据上报、OTA版本检查、控制ACK
bool mqttSendHandshake();
void mqttSendHeartbeat();
void mqttSendDataReport();
void mqttSendVersionCheck();
void mqttSendControlAck(const char* command, const char* value, const char* result);

#endif
