tianchuangya/SmartDesktopCube-IoT/Smart Desktop Cube IoT/src/BlinkerApp.cpp

/*
 * BlinkerApp.cpp — Blinker App 数据发送/接收实现（直连协议，不依赖 Blinker 库）
 *
 * 为什么不用 Blinker 库？
 *   Blinker 库自带旧版 ArduinoJson，与项目使用的 ArduinoJson v7.x 冲突，编译失败。
 *   本模块直接实现 Blinker MQTT 协议：HTTPS 认证 + 独立 PubSubClient 连接。
 *
 * 架构：
 *   - HTTPS 认证握手到 iot.diandeng.tech，获取动态 MQTT 凭证
 *   - 独立 WiFiClient + PubSubClient 连接 Blinker broker（与主 MQTT 互不干扰）
 *   - 在 MQTT 任务（Core 0）中被调用，与主 MQTT 数据上报同步
 *   - 断网时所有操作自动跳过，不影响 WiFi 重连和其他功能
 *
 * 安全设计：
 *   - WiFi 未连接时跳过所有 Blinker 操作
 *   - 认证失败 60s 重试，MQTT 断线 5s 重连，连续 3 次失败重新认证
 *   - 独立的 WiFiClient/PubSubClient 实例，不干扰主 MQTT 连接
 *   - setSocketTimeout(2) 防止看门狗崩溃
 *
 * 用法：
 *   1. BlinkerApp_Init()  — WiFi 就绪后调用一次
 *   2. BlinkerApp_Run()   — 每次循环调用（约 50ms），保持连接 + 处理接收
 *   3. BlinkerApp_SendAll() — 定时调用（2 秒一次），推送全部控件
 *
 * 注意：使用前需在下方填入 BLINKER_AUTH 密钥
 */
#include "BlinkerApp.h"
#include "DataPool.h"
#include "secrets.h"
#include "WiFiManager.h"
#include <WiFiClientSecure.h>
#include <HTTPClient.h>
#include <PubSubClient.h>
#include <ArduinoJson.h>
#include "esp_heap_caps.h"

// ==================== 用户配置（从 secrets.h 读取）====================
#define BLINKER_AUTH BLINKER_AUTH_KEY

// ==================== Blinker 凭证（认证后填充）====================
static String b_host;
static uint16_t b_port = 0;
static String b_devName;
static String b_iotId;
static String b_iotToken;
static String b_uuid;

// ==================== 独立 MQTT 客户端 ====================
static WiFiClient   b_client;
static PubSubClient b_mqtt(b_client);

// ==================== 主题 ====================
static String b_topic_pub;   // /device/<devName>/s
static String b_topic_sub;   // /device/<devName>/r

// ==================== 状态机 ====================
static bool     b_inited = false;
static bool     b_authed = false;
static uint32_t b_last_auth = 0;
static uint32_t b_last_reconnect = 0;
static int      b_reconnect_fails = 0;

static const uint32_t AUTH_RETRY_MS      = 60000;
static const uint32_t RECONNECT_RETRY_MS = 5000;
static const int      MAX_RECONNECT_FAILS = 3;

// ==================== 认证握手 ====================
static bool b_doAuth()
{
    Serial.printf("[Blinker] 认证开始, heap free=%u, max_alloc=%u\n",
                  (unsigned)esp_get_free_heap_size(),
                  (unsigned)heap_caps_get_largest_free_block(MALLOC_CAP_DEFAULT));

    WiFiClientSecure tls;
    tls.setInsecure();
    tls.setTimeout(10000);
    Serial.println("[Blinker] TLS客户端已创建");

    HTTPClient http;
    String url = String("https://iot.diandeng.tech/api/v1/user/device/diy/auth?authKey=")
                 + BLINKER_AUTH + "&version=1.0&protocol=mqtt";

    Serial.printf("[Blinker] 认证URL长度=%d\n", url.length());

    if (!http.begin(tls, url)) {
        Serial.println("[Blinker] 认证: HTTP begin failed");
        return false;
    }
    Serial.println("[Blinker] HTTP begin OK, 发送GET请求...");

    int code = http.GET();
    Serial.printf("[Blinker] GET返回: code=%d\n", code);
    if (code != 200) {
        Serial.printf("[Blinker] 认证失败: HTTP %d\n", code);
        http.end();
        return false;
    }

    String resp = http.getString();
    http.end();
    Serial.printf("[Blinker] 响应长度=%d\n", resp.length());

    JsonDocument doc;
    if (deserializeJson(doc, resp)) {
        Serial.println("[Blinker] 认证失败: JSON解析错误");
        return false;
    }

    if (!doc["detail"].is<JsonObject>()) {
        Serial.printf("[Blinker] 认证失败: 无detail字段, resp=%s\n", resp.c_str());
        return false;
    }

    JsonObject d = doc["detail"];
    b_host    = d["host"].as<String>();
    b_port    = d["port"].as<uint16_t>();
    b_devName = d["deviceName"].as<String>();
    b_iotId   = d["iotId"].as<String>();
    b_iotToken = d["iotToken"].as<String>();
    b_uuid    = d["uuid"].as<String>();

    // 去掉 host 中的协议前缀（mqtts:// / mqtt:// 等）
    int proto = b_host.indexOf("://");
    if (proto >= 0) b_host = b_host.substring(proto + 3);
    int colon = b_host.indexOf(':');
    if (colon >= 0) {
        b_port = (uint16_t)b_host.substring(colon + 1).toInt();
        b_host = b_host.substring(0, colon);
    }
    int slash = b_host.indexOf('/');
    if (slash >= 0) b_host = b_host.substring(0, slash);

    b_topic_pub = "/device/" + b_devName + "/s";
    b_topic_sub = "/device/" + b_devName + "/r";

    Serial.printf("[Blinker] 认证成功: devName=%s, host=%s:%d\n",
                  b_devName.c_str(), b_host.c_str(), b_port);
    return true;
}

// ==================== 接收回调 ====================
static void b_callback(char* topic, byte* payload, unsigned int len)
{
    char buf[256];
    if (len >= sizeof(buf)) return;
    memcpy(buf, payload, len);
    buf[len] = '\0';

    JsonDocument doc;
    if (deserializeJson(doc, buf)) return;

    JsonObject data = doc["data"].as<JsonObject>();
    if (!data) return;

    for (JsonPair kv : data) {
        String key = kv.key().c_str();
        /* 蓝牙灯控制已移除 */
    }
}

// ==================== MQTT 连接 ====================
static bool b_connectMqtt()
{
    if (b_host.length() == 0) return false;

    b_mqtt.setServer(b_host.c_str(), b_port);
    b_mqtt.setCallback(b_callback);
    b_mqtt.setBufferSize(512);
    b_mqtt.setSocketTimeout(2);

    if (b_mqtt.connect(b_devName.c_str(), b_iotId.c_str(), b_iotToken.c_str())) {
        b_mqtt.subscribe(b_topic_sub.c_str());
        return true;
    }
    return false;
}

// ==================== 发送辅助函数 ====================
static void b_pubVal(const char* key, float val)
{
    if (!b_mqtt.connected()) return;
    JsonDocument doc;
    JsonObject data = doc["data"].to<JsonObject>();
    data[key].to<JsonObject>()["val"] = val;
    doc["fromDevice"] = b_devName;
    doc["toDevice"]   = b_uuid;
    doc["deviceType"] = "OwnApp";
    char buf[256];
    serializeJson(doc, buf, sizeof(buf));
    b_mqtt.publish(b_topic_pub.c_str(), buf);
}

static void b_pubSwi(const char* key, const char* swi)
{
    if (!b_mqtt.connected()) return;
    JsonDocument doc;
    JsonObject data = doc["data"].to<JsonObject>();
    data[key].to<JsonObject>()["swi"] = swi;
    doc["fromDevice"] = b_devName;
    doc["toDevice"]   = b_uuid;
    doc["deviceType"] = "OwnApp";
    char buf[256];
    serializeJson(doc, buf, sizeof(buf));
    b_mqtt.publish(b_topic_pub.c_str(), buf);
}

// ==================== 微信通知（PushPlus）====================
// PushPlus 推送加：关注公众号"pushplus推送加"后在 pushplus.net 获取 token
// HTTP POST JSON 到 www.pushplus.net/send，纯 HTTP 无需 TLS（省 ~16KB 堆内存）
static void b_sendWechat(const char* title, const char* state, const char* msg)
{
    if (!WiFiManager_IsConnected()) {
        Serial.println("[推送] 未连接WiFi，跳过");
        return;
    }

    WiFiClient client;
    HTTPClient http;

    if (!http.begin(client, "http://www.pushplus.plus/send")) {
        Serial.println("[推送] HTTP begin failed");
        return;
    }

    http.addHeader("Content-Type", "application/json");

    // snprintf 构造 JSON body，零堆分配
    static char body[256];
    snprintf(body, sizeof(body),
        "{\"token\":\"%s\",\"title\":\"%s\",\"content\":\"[%s] %s\",\"template\":\"txt\"}",
        PUSHPLUS_TOKEN, title, state, msg);

    int code = http.POST(body);
    if (code > 0) {
        String resp = http.getString();
        Serial.printf("[推送] %s -> HTTP %d, resp=%s\n", title, code, resp.c_str());
    } else {
        Serial.printf("[推送] 失败: %s -> %s\n", title, http.errorToString(code).c_str());
    }
    http.end();
}

// ==================== 报警阈值 ====================
#define ALARM_AQI_HIGH      150     // AQI≥150 重度污染（屏幕变红即告警）
#define ALARM_TEMP_HIGH     45.0f   // 温度≥45°C 疑似火灾
#define ALARM_TEMP_LOW       5.0f   // 温度≤5°C 过冷
#define ALARM_HUMI_HIGH     85.0f   // 湿度≥85% 过湿
#define ALARM_HUMI_LOW      20.0f   // 湿度≤20% 过干
#define ALARM_PM25_HIGH    100.0f   // PM2.5≥100 中度污染
#define ALARM_ECO2_HIGH   1200.0f   // eCO2≥1200ppm 通风告警
#define ALARM_TVOC_HIGH    800.0f   // TVOC≥800ppb 通风告警

#define ALARM_COOLDOWN_MS  120000   // 报警冷却 2 分钟（Blinker 服务端限制 60s）
#define ALARM_COUNT 8

typedef enum {
    ALARM_AQI = 0,
    ALARM_TEMP_HI,
    ALARM_TEMP_LO,
    ALARM_HUMI_HI,
    ALARM_HUMI_LO,
    ALARM_PM25,
    ALARM_ECO2,
    ALARM_TVOC
} AlarmType_t;

static uint32_t alarm_last_sent[ALARM_COUNT] = {0};

static bool alarm_can_send(AlarmType_t t) {
    uint32_t now = millis();
    if (alarm_last_sent[t] == 0) return true;
    return (now - alarm_last_sent[t] >= ALARM_COOLDOWN_MS);
}

static void alarm_send(AlarmType_t t, const char* title, const char* state, const char* msg)
{
    if (!alarm_can_send(t)) {
        Serial.printf("[报警] %s 冷却中，跳过\n", title);
        return;
    }
    alarm_last_sent[t] = millis();
    Serial.printf("[报警] 触发: %s (%s) %s\n", title, state, msg);
    b_sendWechat(title, state, msg);
}

// ==================== 公共 API ====================

void BlinkerApp_Init()
{
    if (b_inited) return;
    b_inited = true;
}

void BlinkerApp_Run()
{
    // 入口诊断（每30秒打印一次，避免刷屏）
    static uint32_t last_diag = 0;
    uint32_t now_ms = millis();
    bool do_diag = (now_ms - last_diag >= 30000);
    if (do_diag) last_diag = now_ms;

    if (!WiFiManager_IsConnected()) {
        if (do_diag) Serial.println("[Blinker] Run: WiFi未连接，跳过");
        return;
    }

    if (!b_authed) {
        if (now_ms - b_last_auth < AUTH_RETRY_MS) {
            if (do_diag) Serial.printf("[Blinker] Run: 未认证，冷却中(剩余%ds)\n",
                (int)((AUTH_RETRY_MS - (now_ms - b_last_auth)) / 1000));
            return;
        }
        if (do_diag) Serial.println("[Blinker] Run: 开始认证...");
        b_last_auth = now_ms;
        b_authed = b_doAuth();
        if (b_authed) b_connectMqtt();
        return;
    }

    if (!b_mqtt.connected()) {
        if (now_ms - b_last_reconnect < RECONNECT_RETRY_MS) return;
        b_last_reconnect = now_ms;
        Serial.println("[Blinker] MQTT重连...");
        if (b_connectMqtt()) {
            b_reconnect_fails = 0;
            Serial.println("[Blinker] MQTT重连成功");
        } else {
            b_reconnect_fails++;
            Serial.printf("[Blinker] MQTT重连失败(%d/%d)\n", b_reconnect_fails, MAX_RECONNECT_FAILS);
            if (b_reconnect_fails >= MAX_RECONNECT_FAILS) {
                b_authed = false;
                b_reconnect_fails = 0;
                Serial.println("[Blinker] 重连失败过多，重新认证");
            }
        }
        return;
    }

    b_mqtt.loop();
}

// ==================== 各控件发送函数 ====================

void BlinkerApp_SendLight()       { /* 蓝牙灯已移除 */ }
void BlinkerApp_SendBrightness()  { /* 蓝牙灯已移除 */ }
void BlinkerApp_SendColorTemp()   { /* 蓝牙灯已移除 */ }
void BlinkerApp_SendTemp()        { b_pubVal("num-wendu", sensorData.temp); }
void BlinkerApp_SendHumi()        { b_pubVal("num-shidu", sensorData.humi); }
void BlinkerApp_SendECO2()        { b_pubVal("num-eco2", sensorData.eco2); }
void BlinkerApp_SendPM25()        { b_pubVal("num-pm25", sensorData.pm25); }
void BlinkerApp_SendLightLux()    { b_pubVal("num-lx", sensorData.light); }
void BlinkerApp_SendTVOC()        { b_pubVal("num-ppb", sensorData.tvoc); }

// ==================== 总发送函数 ====================

void BlinkerApp_SendAll()
{
    if (!WiFiManager_IsConnected()) return;
    if (!b_mqtt.connected()) return;

    static char buf[512];  // 静态缓冲区，零堆分配
    snprintf(buf, sizeof(buf),
        "{\"data\":{"
        "\"num-wendu\":{\"val\":%.2f},"
        "\"num-shidu\":{\"val\":%.2f},"
        "\"num-eco2\":{\"val\":%.0f},"
        "\"num-pm25\":{\"val\":%.4f},"
        "\"num-lx\":{\"val\":%.1f},"
        "\"num-ppb\":{\"val\":%.0f}"
        "},\"fromDevice\":\"%s\",\"toDevice\":\"%s\",\"deviceType\":\"OwnApp\"}",
        sensorData.temp, sensorData.humi, sensorData.eco2,
        sensorData.pm25, sensorData.light, sensorData.tvoc,
        b_devName.c_str(), b_uuid.c_str());
    b_mqtt.publish(b_topic_pub.c_str(), buf);
}

// ==================== 微信报警通知 ====================

void BlinkerApp_SendWechat(const char* title, const char* state, const char* message)
{
    b_sendWechat(title, state, message);
}

void BlinkerApp_CheckAlarms()
{
    if (!WiFiManager_IsConnected()) return;
    if (b_devName.length() == 0) {
        static bool warned = false;
        if (!warned) {
            warned = true;
            Serial.println("[报警] Blinker未认证(b_devName为空)，报警检查跳过。需先完成BlinkerApp_Run()认证");
        }
        return;
    }

    // 补发暂存的空气质量告警（峰值已过但告警标志仍在）
    if (status.pending_wechat_air) {
        status.pending_wechat_air = false;
        char msg[64];
        snprintf(msg, sizeof(msg), "Air alert! CO2=%.0fppm, TVOC=%.0fppb. Ventilate!",
                 sensorData.eco2, sensorData.tvoc);
        alarm_send(ALARM_AQI, "Air Alert", "Warning", msg);
        Serial.println("[报警] 补发暂存的空气质量告警");
    }

    // AQI 严重污染
    if (sensorData.aqi >= ALARM_AQI_HIGH) {
        char msg[64];
        snprintf(msg, sizeof(msg), "AQI too high(%d), please ventilate", sensorData.aqi);
        alarm_send(ALARM_AQI, "Air Alert", "Warning", msg);
    }

    // 温度过高（疑似火灾）
    if (sensorData.temp >= ALARM_TEMP_HIGH) {
        char msg[64];
        snprintf(msg, sizeof(msg), "Temp too high: %.1fC, possible fire!", sensorData.temp);
        alarm_send(ALARM_TEMP_HI, "Temp Alert", "Emergency", msg);
    }

    // 温度过低
    if (sensorData.temp >= 0 && sensorData.temp <= ALARM_TEMP_LOW) {
        char msg[64];
        snprintf(msg, sizeof(msg), "Temp too low: %.1fC", sensorData.temp);
        alarm_send(ALARM_TEMP_LO, "Temp Alert", "Info", msg);
    }

    // 湿度过高
    if (sensorData.humi >= ALARM_HUMI_HIGH) {
        char msg[64];
        snprintf(msg, sizeof(msg), "Humidity too high: %.1f%%", sensorData.humi);
        alarm_send(ALARM_HUMI_HI, "Humidity Alert", "Info", msg);
    }

    // 湿度过低
    if (sensorData.humi >= 0 && sensorData.humi <= ALARM_HUMI_LOW) {
        char msg[64];
        snprintf(msg, sizeof(msg), "Humidity too low: %.1f%%", sensorData.humi);
        alarm_send(ALARM_HUMI_LO, "Humidity Alert", "Info", msg);
    }

    // PM2.5 超标
    if (sensorData.pm25 >= ALARM_PM25_HIGH) {
        char msg[64];
        snprintf(msg, sizeof(msg), "PM2.5 too high: %.1f ug/m3, ventilate!", sensorData.pm25);
        alarm_send(ALARM_PM25, "Air Alert", "Warning", msg);
    }

    // eCO2 超标
    if (sensorData.eco2 >= ALARM_ECO2_HIGH) {
        char msg[64];
        snprintf(msg, sizeof(msg), "CO2 too high: %.0f ppm, open windows!", sensorData.eco2);
        alarm_send(ALARM_ECO2, "Air Alert", "Warning", msg);
    }

    // TVOC 超标
    if (sensorData.tvoc >= ALARM_TVOC_HIGH) {
        char msg[64];
        snprintf(msg, sizeof(msg), "TVOC too high: %.0f ppb, ventilate!", sensorData.tvoc);
        alarm_send(ALARM_TVOC, "Air Alert", "Warning", msg);
    }
}
