tianchuangya/SmartDesktopCube-IoT/(commit log)

2026-05-01 光照模块完成
    [outdoor_data.csv]
2026-05-01 完成对AHT20和ENS160一体化模块的初始化和数据读取
2026-05-02 新增双核结构，把运行分为两个层（网络和应用），新增WiFi连接和断网重连机制，实现非阻塞式联网
2026-05-04 新增mqtt连接和数据上传以及心跳包的发送
2026-05-09 修复专注模式启动逻辑，使得是否进入专注判断更加合理，并且占用率更低
2026-05-29 新增ui硬件和对应功能代码
2026-07-11 修复启动死循环、WiFi连接、PSRAM内存、MQTT时序、NTP、ENS160、AQI、UI等多项问题
    - 启动死循环：移除16MB分区表，用8MB默认分区表适配ESP32-S3-DevKitM-1
    - WiFi连接：修复异步重连逻辑，避免WiFi.begin()被反复打断
    - PSRAM内存：LVGL 128KB内存池改用malloc从PSRAM分配，RAM从76%降至36%
    - MQTT时序：subscribe后加loop+delay等SUBACK，握手重试从120s缩至10s
    - MQTT缓冲区：setBufferSize(512)替代默认256
    - NTP时间：失败后每30s重试，等待增至10s，改用configTzTime
    - ENS160传感器：温湿度补偿改为每60s；异常时自动IDLE→STANDARD复位
    - AQI计算：从1-5等级改为标准0-500+线性插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
    [partitions_16MB.csv]
2026-07-11 更新开发日志：精简OTA记录，新增7-12全链路修复总结
2026-07-11 修复分区表：16MB改为正确的8MB（factory 3MB + ota_0 3MB + spiffs 2MB），platformio.ini引用partitions_8MB.csv
    [partitions_16MB.csv, partitions_8MB.csv]
2026-07-14 综合更新：MQTT重构、蓝牙灯光、OTA管理、PM2.5预测、UI增强、文档重写
    [空气质量数据.csv]
2026-07-15 新增Blinker App云平台通信、NTP离线时间修复、LVGL过渡动画、串口调试清理
    Blinker App集成（直接实现MQTT协议，不依赖Blinker库）：
    - 新增BlinkerApp.cpp/.h：HTTPS认证获取动态MQTT凭证，独立WiFiClient+PubSubClient连接Blinker broker
    - 9个控件合并为1条MQTT publish发送（bnt-light/ran-liangdu/ran-sewen/num-wendu等）
    - 接收回调处理灯光开关、亮度、色温控制
    - 断网自动跳过，不影响WiFi重连和现有功能
    - 修复：protocol=mqtts返回TLS broker导致看门狗崩溃，改用protocol=mqtt
    - 修复：auth响应host字段带mqtts://前缀导致DNS失败，添加前缀剥离逻辑
    - 修复：PubSubClient默认15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
    [BlinkerApp.cpp, BlinkerApp.h, DataPool.h, DataRW.cpp, MqttReconnectTask.cpp, WiFiManager.cpp]
2026-07-15 更新功能规格说明书：新增Blinker App云平台通信章节，MQTT上报周期改为2秒
2026-07-16 新增微信报警通知：传感器超阈值自动推送微信消息
    BlinkerApp新增微信报警功能：
    - BlinkerApp_SendWechat()：通过Blinker HTTP API发送微信模板消息
    - BlinkerApp_CheckAlarms()：10秒检查一次，8项报警独立冷却2分钟
    - 报警项：AQI≥300, 温度≥45°C(疑似火灾), 温度≤5°C, 湿度≥85%, 湿度≤20%, PM2.5≥150, eCO2≥2000, TVOC≥2200
    - 每条报警含实时数值，模板格式：标题+状态+消息内容
    功能规格说明书更新：
    - 新增3.7.6节"微信报警通知"，含报警阈值表
2026-07-16 更新开发日志：记录7-17微信报警通知功能
2026-07-17 灯光方案升级：BLE+ESP32-C3 → Yeelight 1S WiFi直连
    BluetoothLight.cpp 完全重写，API 不变底层全换：
    - 移除 NimBLE 库，改用 WiFiClient TCP 连接 Yeelight 55443 端口
    - 协议：Yeelight LAN Control Protocol（JSON-RPC: set_power/set_bright/set_ct_abx）
    - SSDP 自动发现 Yeelight IP（M-SEARCH 多播），也支持硬编码 IP
    - 后台任务 Core 1，5秒自动重连，非阻塞 API 不变
    - UI/Blinker App/专注模式联动无需修改
    移除 NimBLE-Arduino 依赖，RAM 36.2%→34.3%，Flash 84.9%→79.2%
    UI 状态文字 BLE→Light，Toast 提示更新为 Yeelight
2026-07-17 修复Yeelight断网重连：WiFi状态变化时重新SSDP搜索IP
    - 检测WiFi断→连变化，清除旧IP强制重新SSPDP搜索（Yeelight可能被DHCP分配新IP）
    - 连续3次连接失败后自动重新搜索IP
    - 断线时保留pending_update，重连后补发用户指令（不丢命令）
    [BluetoothLight.cpp]
2026-07-17 重写Yeelight重连逻辑：两层架构处理三种断连场景
    层1 SSDP搜索(指数退避5s→30s) + 层2 TCP重连(固定5s)
    WiFi断→连触发全量重置，TCP连续失败6次回搜索
    pending_update断连不清除，重连后补发用户指令
    更新WiFi配置
2026-07-17 修复MQTT看门狗复位：setSocketTimeout(2)限制connect阻塞
    PubSubClient默认socketTimeout=15s，mqtt.connect()阻塞超5s看门狗
    限制为2秒，与Blinker MQTT客户端保持一致
    [MqttCom.cpp]
2026-07-17 BluetoothLight.cpp 添加 Yeelight 连接状态输出
    SSDP搜索/TCP连接/断开/WiFi重连/搜索重置 均打印状态
2026-07-19 feat: OTA固件更新 + 启动流程重构（两阶段初始化）
    - 网页端固件更新：检测更新→MQTT version_check→用户确认→OTA下载
    - OTA线程安全：任务只写共享字段，LVGL定时器渲染进度
    - OTA期间暂停传感器/雷达/上报等非关键任务
    - 启动画面改黑色背景+白色状态文字
    - 两阶段初始化：Phase1快速显示 → Phase2后台加载模块（各5次重试）
    - 新增WebServer/LocalIntelligence/OTA协议格式文件
    - 更新功能规格说明书+系统方案文档
2026-07-20 fix: 亮度PWM改用LEDC 10kHz + 网页退出专注返回主屏 + 自动进入专注默认关闭
    - 背光analogWrite默认976Hz被驱动电容滤平导致调光无效，改用LEDC 10kHz PWM
    - 网页退出专注模式后TFT仍停留在专注页：LVGL定时器检测focus_mode被外部清除后自动返回主界面
    - auto_enter_enabled默认改为false
    [DataPool.cpp, lv_port_disp.cpp]
2026-07-20 fix: 版本检测加超时取消机制，防止请求-响应死循环
    - ota_update响应加守卫：只在检测窗口内(status==1)接受，迟到/重发消息直接丢弃
    - 5秒无响应→状态5(timeout)并取消本轮检测，不再伪装成"已是最新"
    - 检测中忽略重复触发，防止连点重复发送version_check
    - 网页端：检测中禁用按钮；超时显示"检测超时，请重试"
    [DataPool.h, MqttCom.cpp, MqttReconnectTask.cpp, WebServerTask.cpp]
2026-07-24 feat: WiFi网页配网 + Captive Portal + OTA稳定性修复 + 答辩文档
    - WiFi配网: 网页扫描附近WiFi并连接, NVS持久化凭据
    - Captive Portal: DNSServer重定向, 手机连AP自动弹出控制页
    - AP客户端检测: 设备连入CubeLight时TFT显示控制IP
    - OTA修复: 主动断开MQTT+暂停YeeLight防止SHA加速器冲突(Double exception)
    - OTA任务栈扩至16KB, 下载缓冲区static分配
    - MQTT重连: 异常断开后清理socket防止CLOSE_WAIT卡死
    - OTA界面文字改英文, 消除LVGL glyph警告
    - 敏感信息: WiFi密码和Blinker authKey替换为占位符
    - 新增答辩流程设计文档
    [BlinkerApp.cpp, BluetoothLight.cpp, DataPool.cpp, MqttCom.cpp, MqttReconnectTask.cpp, OTAManager.cpp, OTAScreen.cpp, Task_Network.cpp]
2026-07-24 refactor: 敏感信息抽离到 secrets.h + WiFi扫描修复
    - 新增 secrets.h 存放 WiFi 密码和 Blinker authKey（已 .gitignore）
    - 新增 secrets.h.example 模板供 clone 后参考
    - DataPool.cpp / BlinkerApp.cpp 改为引用 secrets.h 宏
    - WiFiManager: 扫描前断开STA释放射频, 连接失败3次后停止重试
    [BlinkerApp.cpp, DataPool.cpp, WiFiManager.cpp]
2026-07-27 feat: 三轮审计bug修复 + HTTP控制轮询 + 内存优化 + 竞赛文档
    固件修复 (23项审计bug):
    - 传感器数据初始化改用-1.0f哨兵值，防止误报警
    - TVOC阈值修正(0.5→500ppb)，单位统一为ppb
    - 雷达初始化重试逻辑修复(原dead code)
    - MQTT/Web/HTTP专注模式生命周期补全
    - PM25Predictor NaN/Inf校验+输出钳位
    - BlinkerApp微信JSON改用ArduinoJson序列化
    - WiFi断连后30s自动重试(原永久放弃)
    新增功能:
    - ControlPoll模块: 5s轮询后端控制队列(pull/ack)
    - 静态TLS连接复用，ACK失败延迟重试
    - 专注总结弹窗: 10s倒计时+先切主屏再弹出
    - 堆碎片整理: 每2分钟渐进式realloc合并空闲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
    [BlinkerApp.cpp, ControlPoll.cpp, DataPool.cpp, DataPool.h, DataRW.cpp, DeviceInit.cpp, LocalIntelligence.cpp]
2026-08-09 Submit Smart Desktop Cube project
    [01_body.stl, 02_front_bezel.stl, 03_side_slider.stl, 04_back_cover.stl, 05_top_clear_lens_placeholder.stl, SmartDesktopCube_case_v20_all_parts_preview.stl, SmartDesktopCube_case_v20_preview.blend, mzh51.stl]
